yepengfei81-cpu/Motor_Glove/docs/teleop_cube_test.png

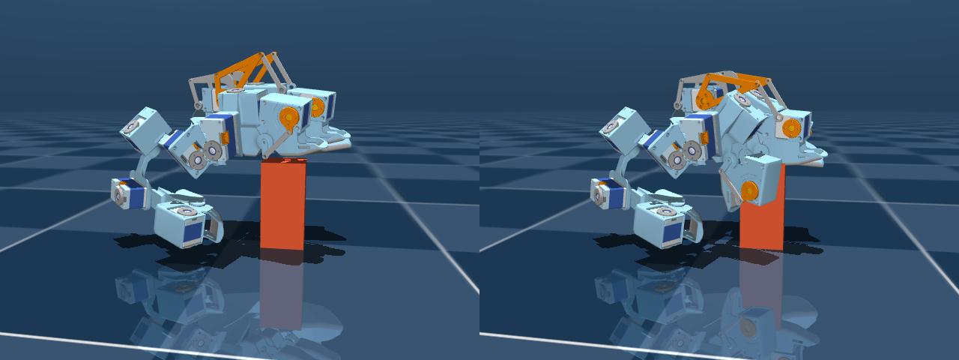
docs/teleop_cube_test.png
