yepengfei81-cpu/Motor_Glove/docs/middle_mcp_boxes_numbered.png

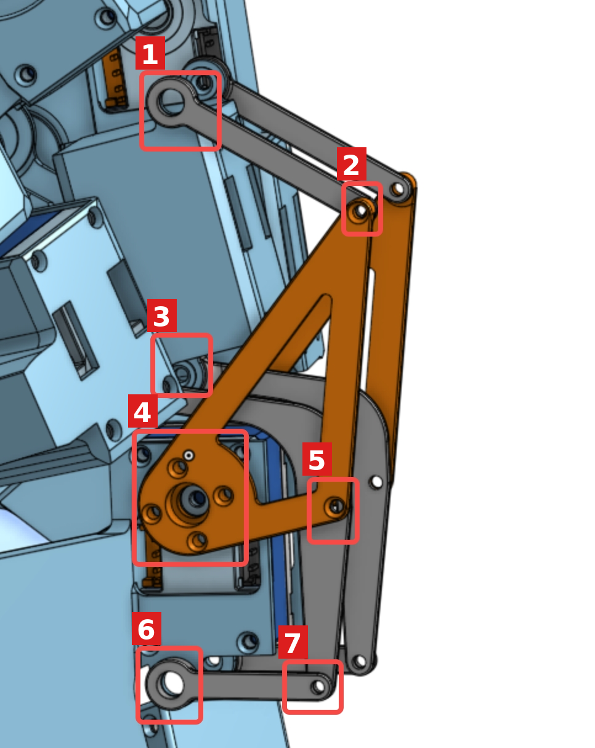
docs/middle_mcp_boxes_numbered.png
