yepengfei81-cpu/Motor_Glove/docs/motor_optimization_plan.md

# 电机性能优化计划（台架：两台 XL330-M077，ACM0 = OpenRB-150，USB0 = U2D2）

最后更新：2026-10-22。状态：☐ 没做 ☐→ 进行中 ☑ 完成。每完成一项把结论写在后面，别只打勾。

## 0. 现状基线（演示版本，手套 A → 机械手 H，13 关节）
- 控制频率 160–183 Hz：两条总线各一次 Sync Read（13 × 21 字节 ≈ 2.7 ms 线上时间）+ 两次 Sync Write + USB 往返 + 纯 Python SDK 拼包/CRC；两总线并行读后 183 Hz。
- 力反馈：主手电流模式，kp·位置差（有虚位）；或墙模式（主手模式 5，目标 = 从手位置，电流上限 = 门控 × 力）。
- 摩擦补偿：按电机报的速度加电流（--visc-ma），在 M077 上变成负阻尼，已弃用。
- 速度信号：电机的 Present Velocity，滤波滞后 + 0.229 rpm 量化。

## 1. 通信（已完成：3 Mbps + Fast Sync Read + 常驻读线程 + --rt；台架 1 关节 750 Hz，墙模式 800 Hz 手感明显优于 100 Hz）
- ☑ 写 `tools/bench_bus.py`，1 Mbps 单电机实测：OpenRB 读 0.6 ms / U2D2 读 1.0 ms（FTDI latency timer 地板）；读+写环 1.2 kHz / 1.0 kHz；500 Hz 节拍 0% 迟到；SDK 和精简包一样快（Python 开销可忽略）：单次读写往返、Sync Read vs Fast Sync Read(0x8A)、latency timer 1/16、用大块读模拟 13 电机线上时间、环频率和抖动直方图。
- ☑ U2D2 的 FTDI latency timer 是 1 ms（`cat /sys/bus/usb-serial/devices/ttyUSB0/latency_timer`，规则文件 tools/99-dxl-latency.rules）。
- ☑ 波特率：U2D2 2 Mbps 通（13 电机模拟读 1.0 ms）。OpenRB 原厂桥接固件只能 1 M。
- ☑ 自己的桥接固件 `firmware/openrb_bridge`（DMA 接收环形缓冲 + 8 倍过采样 + 总线供电开关）：
    逐字节中断在 2 M 就丢字节（每 7–10 字节丢 1 个，中断优先级提高也没用）→ DMA 后 2 M / 3 M 500 次 111 字节读 0 坏包；
    4 M 有 0.2% 坏包（分频 1.5，时序余量不够）→ **定 3 Mbps**。
    3 M 实测（OpenRB）：单电机读 0.36 ms，13 电机模拟读 0.82 ms，读+写全速环 1.95 kHz，800 Hz 节拍 0% 迟到。
    U2D2 3 M 实测：所有读都卡在 1.00 ms（FTDI latency timer 地板，和波特率无关），读+写环 1.0 kHz，800 Hz 节拍 0% 迟到。机械手侧要再快只能换成 OpenRB 跑同一个固件。
- ☑ Fast Sync Read：2 电机同总线验证通过（回包 ID 字段是 0xFE，每段 CRC 是累计 CRC，末段 CRC 即整包 CRC）。
    已并进 `dxl_bus.Bus`：`read_state`/`read_raw` 默认走 0x8A，按包头重对齐 + 整包 CRC，连续失败 3 次自动退回 SDK Sync Read；
    `Bus()` 打开时按 3M → 1M → 2M → 57600 自动找波特率；`mg.py <设备> baud 3000000` 一键迁移。
    台架 2 电机 @3M：read_state 0.47 ms（SDK 0.50），read_raw 0.40 ms。
- ☐ 真手套/机械手迁移到 3 M 并量 13 电机实际周期：`mg.py A baud 3000000`、`mg.py H baud 3000000`，然后 `mg.py teleop A H --hz 800`。
- ☑ 精简包层：实测和 SDK 一样快，不需要重写，保留 SDK。
- ☐ 每条总线一个线程自由跑，最新状态写共享缓冲；控制环固定节拍取值，不在环里等串口。
- ☑ `--rt`：SCHED_FIFO 50 + 绑空闲核（需 limits.conf 放开 rtprio）；例行检查拆成逐周期一步；从手常驻读线程。p99 1.6 ms。
- ☐→ 13 电机周期估算（线上时间 + USB 往返 + 写；3 M + Fast Sync Read ≈ 0.63 + 0.3 + 0.15 ≈ 1.1 ms → 800 Hz 级别，真手套上验证）：
    1 M 普通 Sync Read ≈ 4.2 ms → 240 Hz（现状）；1 M Fast Sync Read ≈ 3.4 ms → 290 Hz；1 M Fast + 只读位置电流 6 字节 ≈ 2.9 ms → 350 Hz；
    2 M Fast ≈ 1.7 ms → 600 Hz；4 M Fast ≈ 1.2 ms → 800 Hz。结论：1 M 下 13 个电机到不了 500 Hz，手套侧必须提波特率或内环上板。
- ☐ 评估把内环搬到 OpenRB-150 固件（它本来就在手套上，不加重量）：板上 1 kHz，PC 发设定值。STM32 不需要。

## 2. 辨识（裸电机，M077 和 M288 各做）
- ☑ `tools/motor_id.py`：spin / ramp / chirp / step / hold 五个实验 + fit（合成数据自测能拟回 J、b、tc），结果存 config/motor_params/<设备>.json。待台架实测。
- ☒ 实验 1 挂砝码保持 / 电流抬升（T1 实测）：不可用。砝码径向拉力让输出轴套摩擦涨到 ≈20 mN·m（空载 2.6），
    29 mN·m 的重力矩从上面下放只要 18 mA 保持；lift 里 100 mA 不动、140 mA 起动后直接翻过顶（起动后摩擦骤降，净力矩翻倍）。
    推论：真实电磁 Kt ≈ 0.3 N·m/A，手册 0.146 是堵转净值；输出力矩 = Kt·i − 随负载和方向变化的摩擦，被反驱和主动推要分开标。
- ☑ 实验 1''（sweep，T1，164 g × 18 mm 连续转 2 圈 × 2 方向，重复性 1 mA 以内）：
    抬升半圈（电机推负载）电流峰值包络 vs 重力矩 → 净 Kt ≈ 0.16 N·m/A，手册 0.146 基本对；抬升段是粘滑（电流在 20–240 mA 间来回），负载下静摩擦 > 动摩擦。
    下放半圈（负载反驱电机）平均电流只有 13 mA，摩擦扛了约 90% 的负载：1.6 N 径向力压在输出轴套上，M077 在这种负载下接近不可反驱。
    对手套的含义：四连杆对舵盘的拉力就是这种径向负载（50 mN·m 关节力矩 ≈ 5 N 链接力），接触时主手电机"顶住人"几乎不花电流、"推动人"要全额电流，
    透明度的大头是负载摩擦不是控制；机械上考虑用 idler 侧双支撑输出轴、或加轴承。
- ☐ 实验 1'（可选）平衡杆惯量法：对称杆装/不装各做一次 chirp，ΔJ 已知 → 电磁 Kt 和电机 J（现在净 Kt 已够用，优先级降低）。
- ☑ 负载摩擦标定（T1：53 / 122 / 164 g）：反驱时摩擦 4.6 / 12.2 / 16.5 mN·m，对径向力线性，≈ 10.9 mN·m 每牛顿，截距 ≈ 0。
    推负载时的表观净 Kt 随负载降（0.21 → 0.16），反推电磁 Kt ≈ 0.27 N·m/A（三点一致 ±15%）。
    模型：τ_out = 0.27·i − f，f ≈ 10.9 mN·m/N × 径向力（+ 空载 2.9）。手套四连杆的径向力 ≈ 关节力矩 / 舵盘半径，摩擦和传递力矩同量级。
    结果存 config/motor_params/T1.json（load_friction_model、kt_em_estimate）。
- ☑ 实验 2 ramp（T1）：起动电流 17–18 mA 极稳（≈2.6 mN·m 按手册 Kt；按真实 Kt 约 5 mN·m）。
- ☑ 实验 3（改为 spin 零电流衰减，T1）：b/J = 1.30 /s，tc/J = 110 rad/s²（与 Kt 无关的量）。
- ☑ 实验 4 chirp（T1）：按手册 Kt 算 J = 26 g·cm²（真实 Kt 下约 50）；电流环：实测电流滞后指令 8 ms。chirp 的 b 和 spin 差十倍，拟合要补延迟，信 spin。
- ☐ 实验 5 零电流单摆衰减：反驱摩擦（手感）；关扭矩再做一遍对比（零电流 ≠ 关扭矩？）。
- ☑ 实验 6 step（T1）：电机报的速度比位置差分滞后 22 ms → 阻尼项不能用它，必须自己做速度估计。
- ☐ 装上手套/机械手后：每个四连杆关节做一次衰减实验，减去裸电机模型 = 连杆增量（销轴摩擦、柔度），按关节存。传动比 r = dφ/dθ 用 passive_map 的曲线。
- ☐ 同型号多台的离散度：测 2–3 台看摩擦差多少，决定按型号还是按台存参数。

## 3. 控制
- ☐ 速度估计：500 Hz 下用位置 + 辨识模型做观测器（或低滞后差分滤波），替掉 Present Velocity。
- ☐ 模型前馈：摩擦（Stribeck/库仑/粘滞）+ 惯量，用辨识参数，不手调。
- ☐ 增益由目标阻抗（K、B）和辨识对象 + 延迟反推，带裕度。
- ☐ 扰动观测器（DOB）：标称模型 = 辨识结果，抵消摩擦和参数误差，做"透明"模式。
- ☐ 时域无源性控制（TDPC）：能量观测，自动注入阻尼，硬墙不抖。
- ☐ 位置模式前馈寄存器（88 速度前馈、90 加速度前馈）：从手跟随用，系数从 b、J 换算，比例实测。
- ☐ 可选：PWM 模式（16）+ 反电动势补偿当更快的力矩通路，需要 R、Ke。
- ☐ 可选：小网络拟合摩擦随角度/方向/温度的图，只做前馈，用衰减实验验证。

## 4. 其他
- ☐ 热：M077/M288 持续电流上限和温升曲线。
- ☐ 机械：四连杆销轴换轴承（手感的大头）。
- ☐ 台架 = 一自由度双边遥操作测试台：透明度（空中力）、墙刚度、稳定边界、Z-width；每版控制律先在台架量。

## 已经确定的结论
- 墙模式比电流模式弹簧硬得多，无虚位；电流上限不能按预算预摊（会把 13 关节摊薄）。
- 零点在 0/4095 边缘的关节写目标位置必须就近折返。
- 拇指 IP、中指 PIP 从手方向相反，力反馈要乘方向符号。

## 2026-10-23 虚拟耦合为什么高频振、根因与出路

**现象（data/coupling.csv，bench_coupling 预设，kc 0）**：6.6 Hz 极限环。主手 ±52°，从手反相 ±40°，主手电流 ±800 mA 饱和 88% 时间，
速度封顶 ±31 rad/s —— 正好是 6 V 除以 Ke 0.18–0.19 V·s/rad 的空载转速（实测电流随转速逼近 31 rad/s 掉到 0，Kt_em≈0.18 又一次被证实）。
日志里的 qA/qB/err 单位是弧度，不是度。

**我加的、也是出问题的东西**：coupling 模式把弹簧从"门控开才接"改成了"误差超过 2° 就一直接"，又加了 B·ė。电流模式下这两项都是非被动的：

| 事实 | 数值 | 来源 |
|---|---|---|
| 命令到力矩延迟 T | ≈7 ms | 阶跃位置起动 7.6 ms、啁啾回归 5–9 ms、实测电流滞后 8 ms（三者一致，是电机内部电流环的慢，不是上报滤波） |
| 主手物理阻尼 b | 0.45 mN·m·s/rad | 啁啾 |
| 延迟弹簧等效负阻尼 K·T | 0.8 × 7 ms = 5.6 mN·m·s/rad | 远大于 b |
| 被动上界 K < 2b/T（Colgate） | ≈0.13 N·m/rad | 实际 0.8，超 6 倍 |
| B·ė 在 25 Hz（√(K/J)）处的相位 | −72°(延迟) −59°(15 Hz 观测器) = −131° | 本身已是负阻尼 |

手指握着时手指的阻尼和惯量把它压住，所以 bench_free 在接触时好用；一松手就只剩电机自己 → 弹飞/振荡。门控方案空载不振只是因为空载弹簧根本没接。

**仿真（scratchpad bilat_sim.py：两电机、7 ms 延迟、反电动势限速、库仑摩擦、编码器量化、从手位置环）**：
- 电流模式连续弹簧：K ≥ 0.04 空载一拨就起 10 Hz 极限环，K 0.8 复现饱和极限环（14 Hz ±24°，实测 6.6 Hz ±52°，量级一致）；堵转松手同样振。
- 原门控方案：空载 2°（没弹簧），堵转松手 35° @10 Hz 衰减到 2.6°（就是用户感受到的"弹飞"）。
- 电压(PWM)模式：绕组被电压源驱动，Kt²/R ≈ 0.18²/3.3 ≈ 9.8 mN·m·s/rad 的电磁阻尼是物理的、零延迟的（电流模式下它被电机的电流环抵消掉了）。
  K 0.8 和 2.0、空载和松手全部 0.00° 振幅（延迟 2 ms），延迟 7 ms 也稳。空载用 k_bemf = 1 − w_pen 把电磁阻尼按穿透深度抵消
  （空载全抵消 = 和电流模式一样轻，一拨滑行 1.9° vs 门控 4.5°），穿透越深阻尼越真。若 PWM 延迟也是 7 ms，松手时 k 要慢放（待调）。

**下一步（台架，T1）**：
1. `python tools/motor_id.py T1 spin --mode pwm`：占空比 20% 脉冲后归零，看是几毫秒刹住（电压源）还是滑行几百毫秒（断开）。
2. `python tools/motor_id.py T1 step --mode pwm`：占空比 ±15% 阶跃 → 延迟、Ke、R。
3. 两个都对了再给 bilateral.py 加 `--mode pwm`（力矩 → 占空比 = (R·τ/Kt + k·Ke·v̂)/V，k = 1 − w_pen），沿用现在的弹簧律、摩擦前馈和观测器。

### 台架结果（2026-10-23，T1 电压模式）

- `spin --mode pwm`：占空比归零后 40–60 ms 停下，再转 10–13°。既不是短路绕组的 3 ms，也不是关扭矩的 380 ms：
  电磁阻尼 b_em ≈ 1.3–1.8 mN·m·s/rad（阶跃上升时间常数 13–24 ms 给出 1.4–2.5，一致）。比电流模式的 0.45 大 4 倍，但没有理论值 9.8 那么大。
- `step --mode pwm` ±15%（0.915 V）：稳态 6.5 rad/s；实测电流 2 ms 就开始升、8 ms 到峰（61 mA）；位置 10 ms 才动 1 tick。
  电流模式 +120 mA 阶跃同样 2 ms 起电流、10 ms 位置才动。**延迟主要在位置上报（≈6 ms），执行 ≈2 ms，两种模式一样。**
  起始加速度 450 rad/s²（电流模式 120 mA 是 545）→ 15% 占空比 ≈ 100 mA 当量，G ≈ 19 mN·m/V，100% ≈ 117 mN·m；
  扣摩擦 0.31 V 后 Ke_eff ≈ 0.093 V·s/rad（6.1 V 空载 65 rad/s）；G·Ke = 1.8 mN·m·s/rad 和 spin 测的 b_em 自洽。
  （电流读数的绝对标定和 Kt 0.18/Ke 0.093 对不上，先不管：控制只用电压模式里直接测到的 G、Ke、b_em。）
- 仿真按实测改（感知 6 + 执行 2 ms，b_em 1.8）：空载连续弹簧 电流模式 K≥0.2 全振，电压模式 K 到 0.8 都 0.00°；
  堵转松手两种模式都有"弹飞"——松手后力矩还要作用一个回路延迟（≈9 ms），Δv = τ·T/J ≈ 20 rad/s，这是硬物理，
  电压模式只是把之后的滑行从 ~100°（库仑摩擦刹）缩到 ~25°（电磁阻尼 τ=J/b=18 ms）。仿真里松手后的极限环比实际悲观（实际门控方案会收敛）。

### 决定

1. 先不动力律：`--mode pwm` 用 bench_free 同一套（门控弹簧、单向、摩擦前馈、观测器），只换执行路径：
   占空比 = (τ/G + k·Ke·v̂)/V，k = pwm-cancel × (1 − 门控)。空载全抵消电磁阻尼（和电流模式一样轻），接触/松手保留。预设 `bench_pwm`。
   A/B：`mg.py teleop T1 T2 thumb --preset bench_free` vs `--preset bench_pwm`，重点是堵转松手。
2. 再做：电压模式下用实测电流反推速度（i = (dV − Ke·ω)/R，电流 2 ms 就响应，位置要 6 ms）做松手检测，把力矩作用时间从 9 ms 压到 4 ms，弹飞再减半。
3. 之后才考虑去掉门控的连续弹簧（空载从手滞后 3° 会变成拖拽，需要死区/滞后补偿）。

## 2026-10-25 M288 辨识与从手软件环

- 两台从手套拆下的 M288（T3 = ID 5 index_mcp_flex，T4 另一台）全套辨识，和 M077 按减速比 3.74 对照全部吻合：
  起动 21/18 mA（M077 17–18，起动摩擦在转子侧）；tc 15.8 mN·m（3.6×3.74 = 13.5）；tc/J 28.5/26.4（110×3.74/14 = 29）；
  J 5.6e-4（3.2e-5×14 = 4.5e-4）；净 Kt 0.76–1.0（0.18×3.74 = 0.67）；负载摩擦 ≈9 mN·m/N（M077 10.9）；关扭矩多出的 b/J +1.3 /s 两者一样。
  两台之间 Kt、负载摩擦差 <5%，摩擦差 7–14% → 共用参数，前馈留一成余量（手套预设 0.8）。
- 电压模式：归零刹车 τ≈26 ms → b_em 21 mN·m·s/rad（M077 1.5 × 14）；Ke 0.45（0.12 × 3.74）；R 沿用 4.1 Ω。
  **发现驱动桥 PWM 关断期断开（断续导通）**：堵转 占空比→电流 不是线性，5% 时表观 14 Ω、50% 时 6 Ω、88% 才 4.1 Ω。
  原来按 G 线性换算，13 mA 前馈只给了 0.8% 占空比（需要 2.2%），接触 134 mA 只送到 35 mA。改成查堵转表（从接触段日志反推，两型号共用），电流环增益按工作点表观电阻。
- 参数文件按型号：XL330-M288.json / XL330-M077.json；bilateral `--model auto` 按总线型号逐关节选，J、B、φ、G/Ke/R 全部按关节。
- 从手 `--follower-mode current`：电流模式 + 软件 PD（K = J·(2πf)²，f 默认 6 Hz，`--follower-bw-map M077=12`）+ 模型前馈（J·a_ref + b·v_ref + c·tc·sgn(v_ref)）。
  台架 T3/T4 实测：从手不再粘滑（原位置环 P 600 需 1.2° 误差才顶过静摩擦，一格一格跳；加 I 增益会在目标附近来回蹭），用户评价"效果很好"。
- `--fb-force`：反作用力观测器力反射（从手指令力矩 − 模型），第一版三项滤波不配平 → 主手一加速就出假接触力，两边抖且黏；改成统一 6 Hz 低通 + 和前馈同形的摩擦项，待台架验证。
  位置差弹簧只能渲染硬挡，软物体（硅胶）要靠力反射；电流/位置上报 8 ms 滞后 + M288 自身摩擦 16 mN·m 决定了纹理摸不到，软硬和慢起伏可以。
- M288 空载"比断电更丝滑"的上限：摩擦那十几 mN·m 能补掉 80–90%，换向死区内仍是全摩擦；惯量 5.6e-4（M077 的 14 倍）补不了，是 288:1 的代价。
- 下一步：装回手套（T4 ID 改回、两台先回 1 M、整只迁 3 M、量 13 电机实际频率）；装着做 ramp 量每关节起动摩擦再放开前馈；舵盘半径表填 --r-load-map；机械手 PIP/IP 若嫌软退回位置模式。
