yepengfei81-cpu/Motor_Glove/docs/figs/ppt/cad_palm_front.png

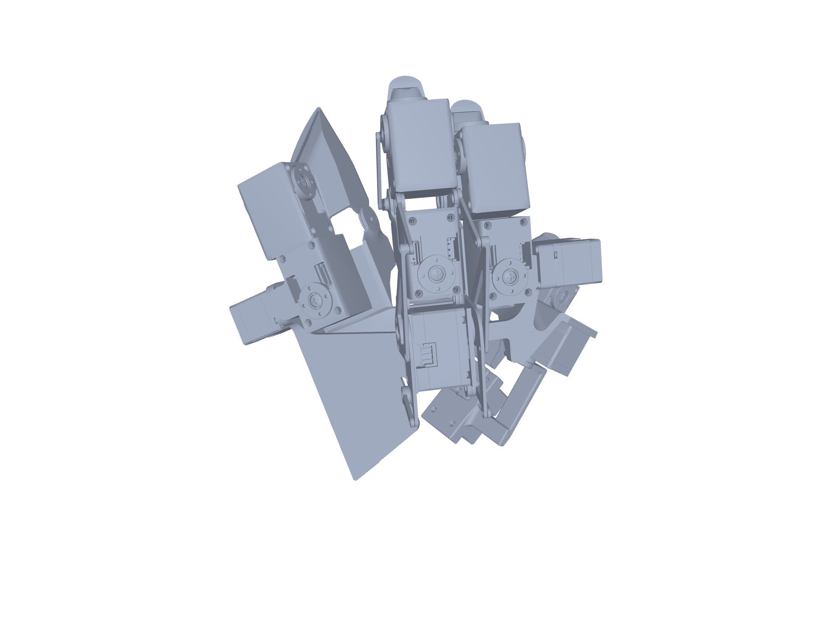
docs/figs/ppt/cad_palm_front.png
