yepengfei81-cpu/Motor_Glove/docs/figs/ppt/cad_top.png

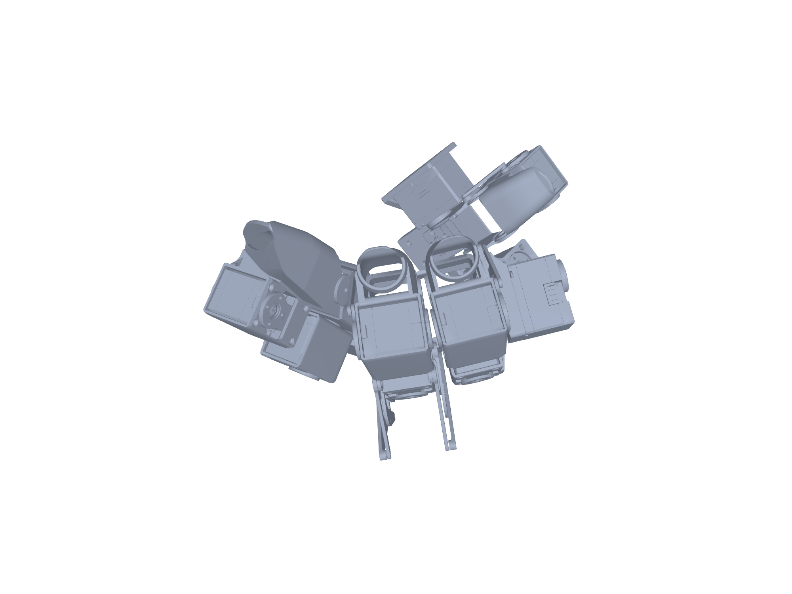
docs/figs/ppt/cad_top.png
