yepengfei81-cpu/Motor_Glove/docs/figs/ppt/comparison_table.png

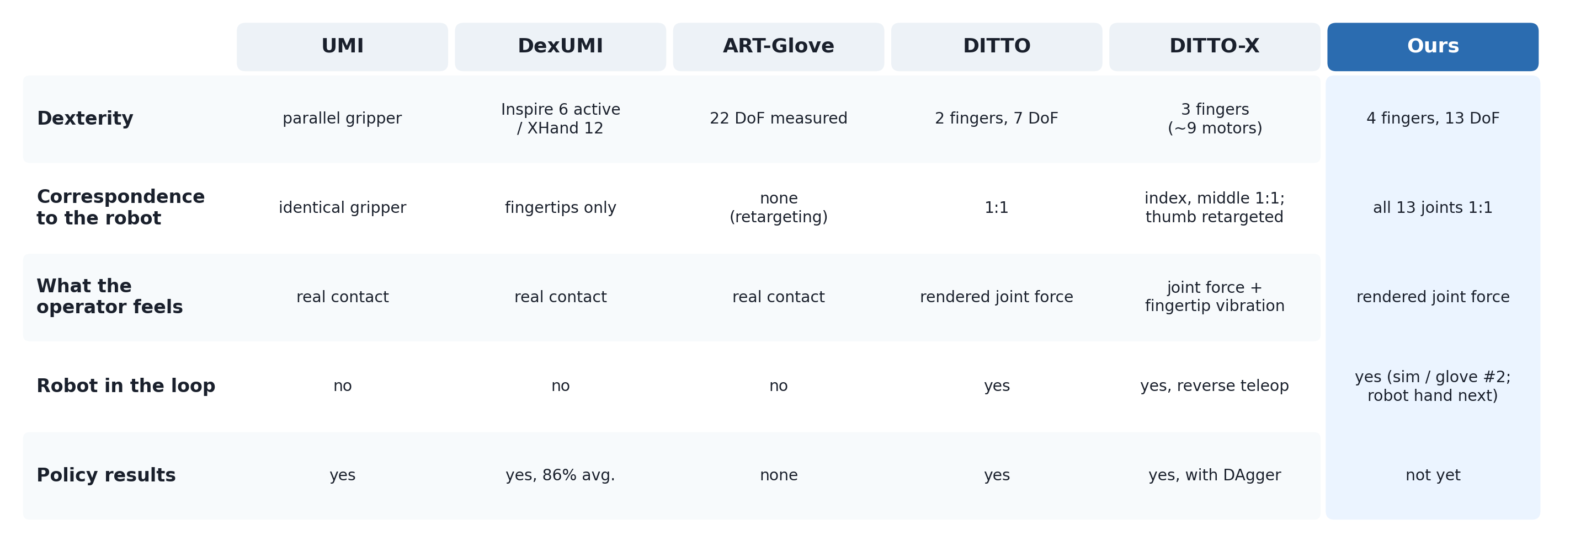
docs/figs/ppt/comparison_table.png
