yepengfei81-cpu/Motor_Glove/docs/figs/ppt/control_law.png

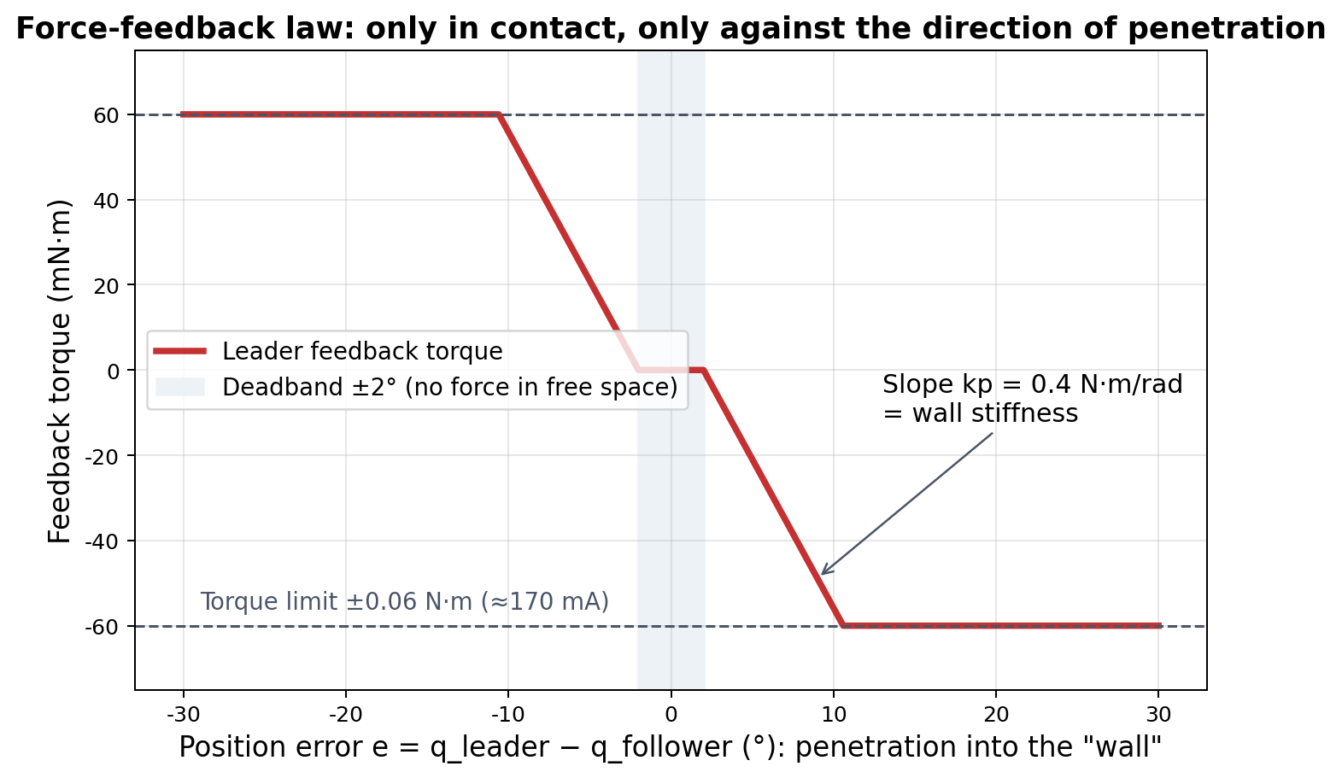
docs/figs/ppt/control_law.png
