yepengfei81-cpu/Motor_Glove/docs/figs/ppt/data_record.png

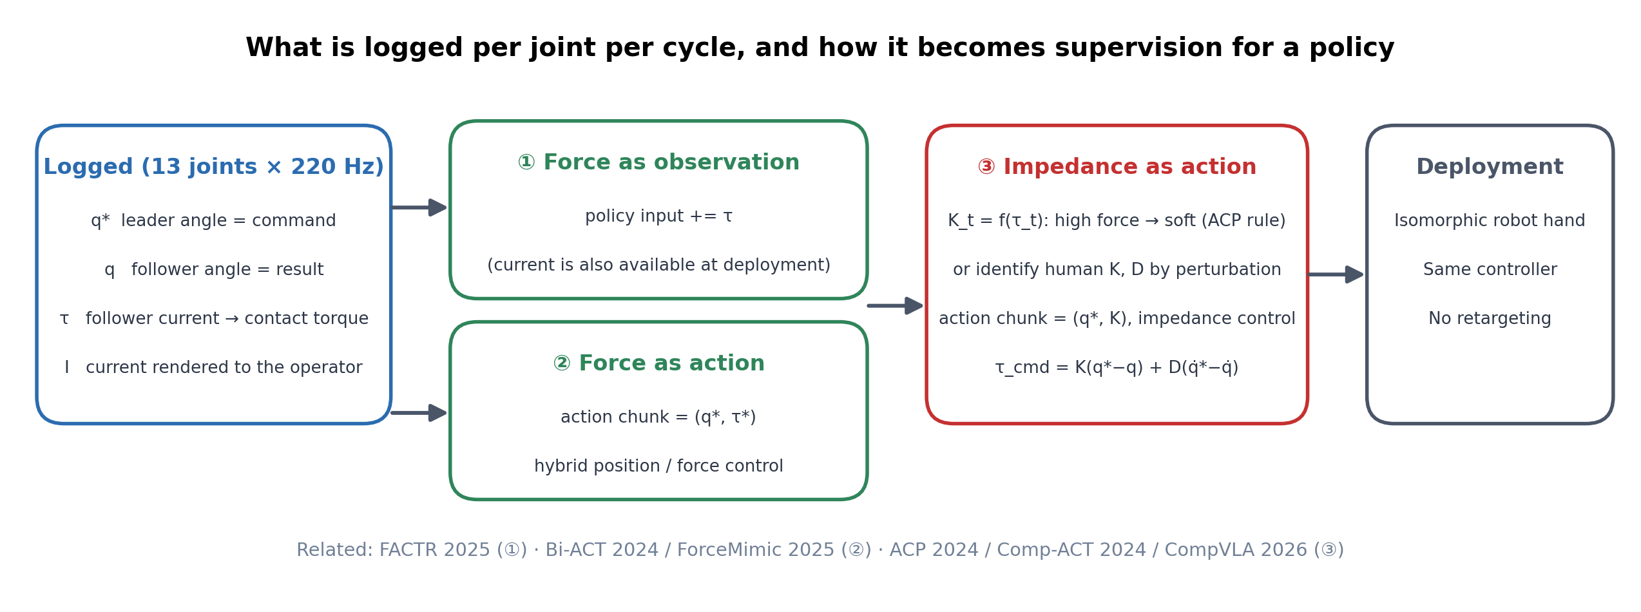
docs/figs/ppt/data_record.png
