yepengfei81-cpu/Motor_Glove/docs/figs/ppt/modules_dorsal.png

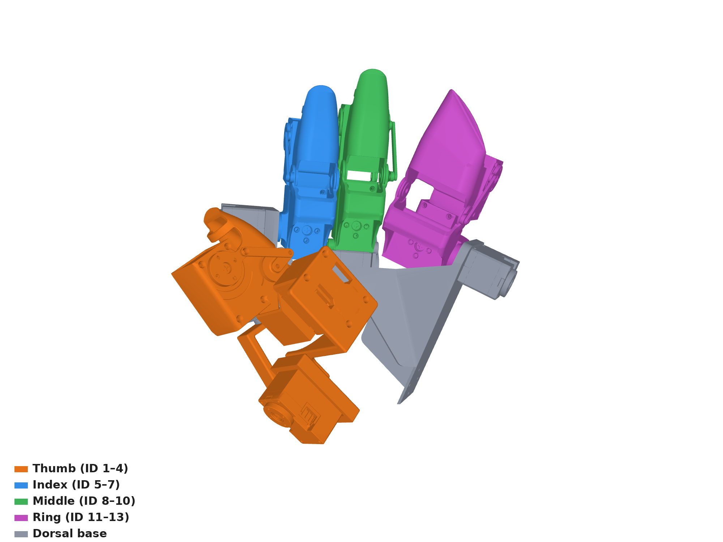
docs/figs/ppt/modules_dorsal.png
