yepengfei81-cpu/Motor_Glove/docs/figs/ppt/modules_palm_front.png

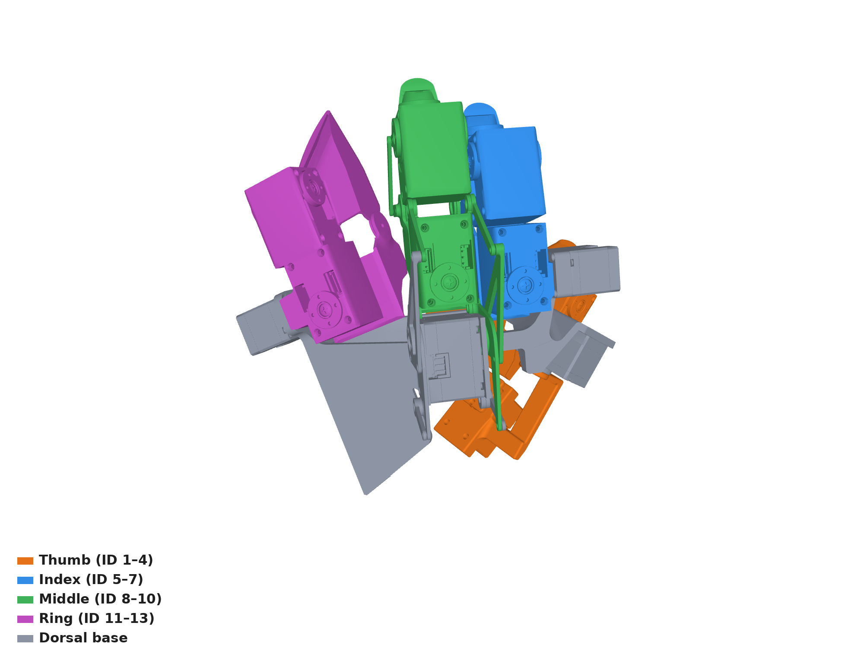
docs/figs/ppt/modules_palm_front.png
