yepengfei81-cpu/Motor_Glove/docs/figs/ppt/modules_palm_oblique.png

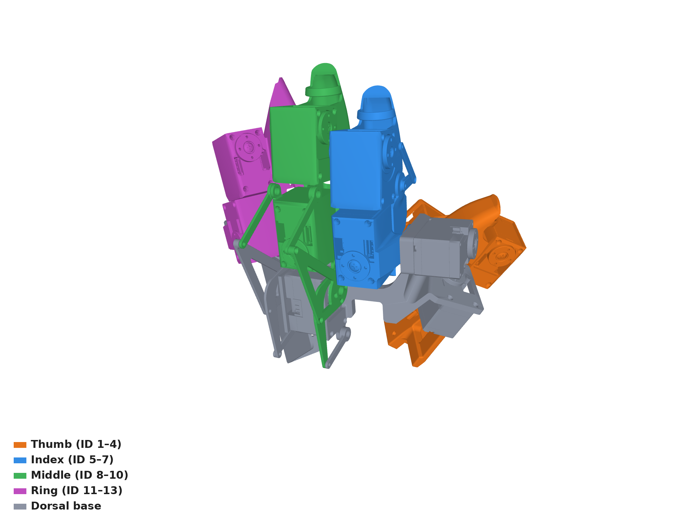
docs/figs/ppt/modules_palm_oblique.png
