yepengfei81-cpu/Motor_Glove/docs/figs/ppt/rcm_mid_mcp.png

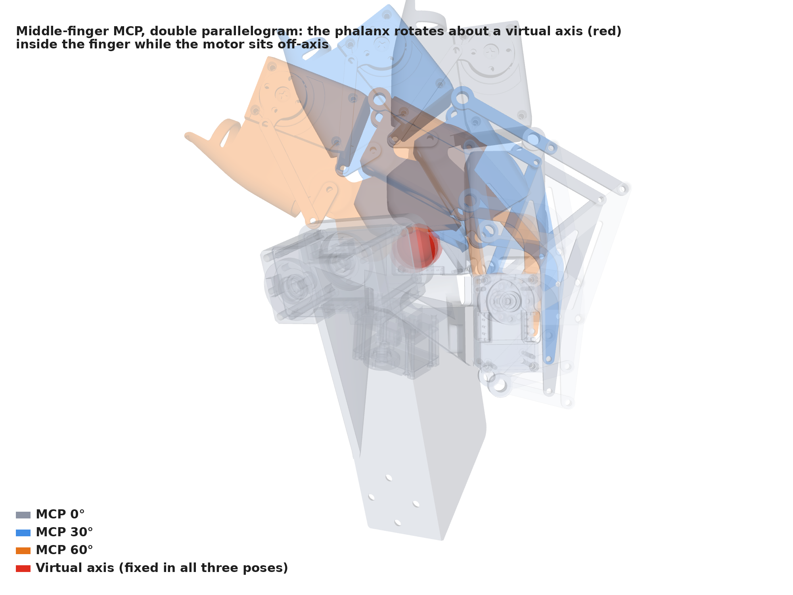
docs/figs/ppt/rcm_mid_mcp.png
