yepengfei81-cpu/Motor_Glove/docs/figs/ppt/rom_overlay_palm_front.png

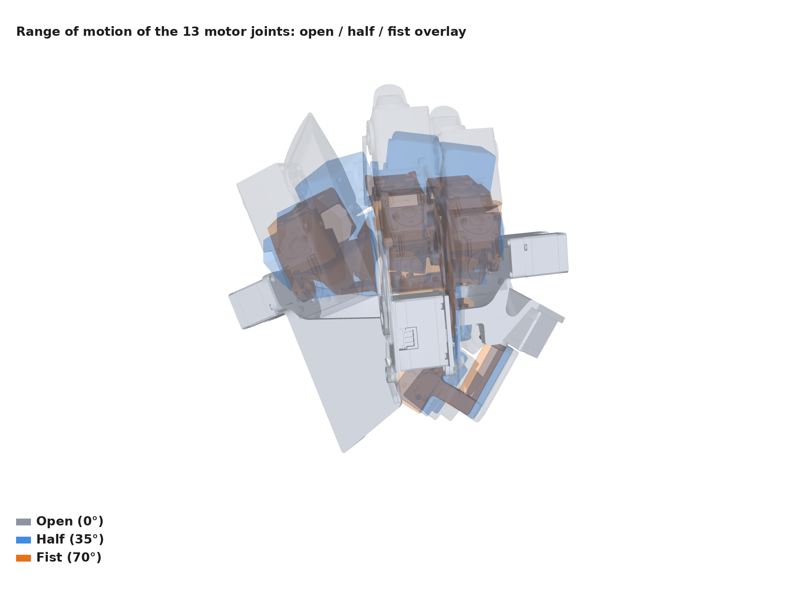
docs/figs/ppt/rom_overlay_palm_front.png
