yepengfei81-cpu/Motor_Glove/docs/figs/ppt/scorecard.png

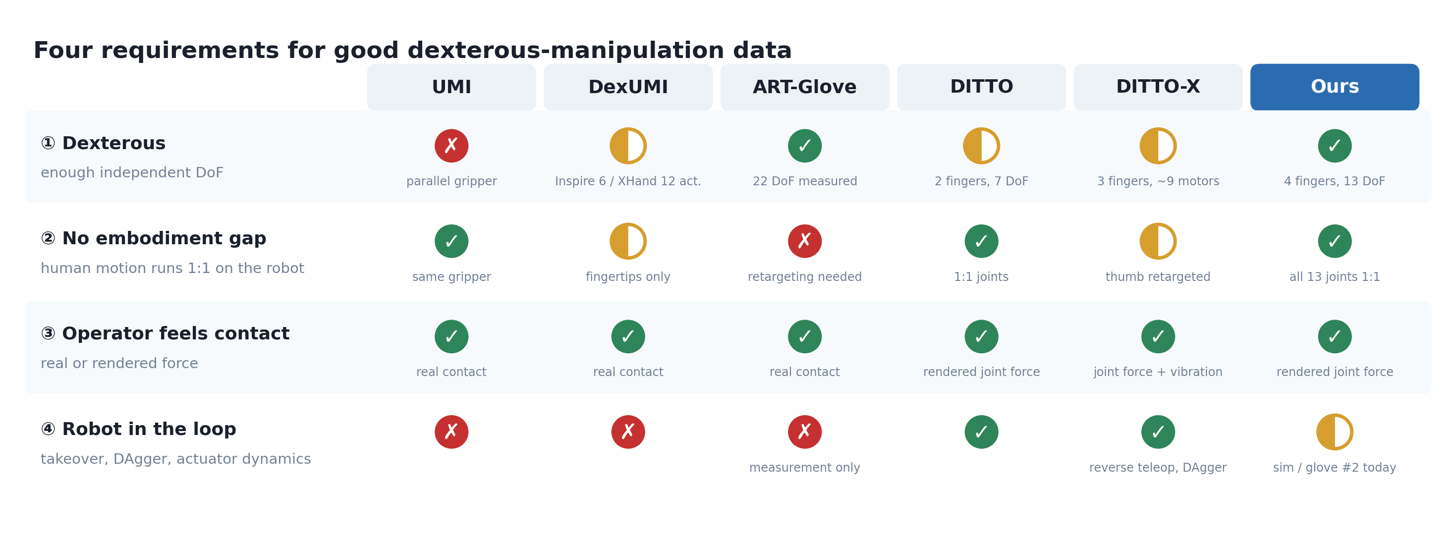
docs/figs/ppt/scorecard.png
