yepengfei81-cpu/Motor_Glove/docs/figs/ppt/scorecard_artglove.png

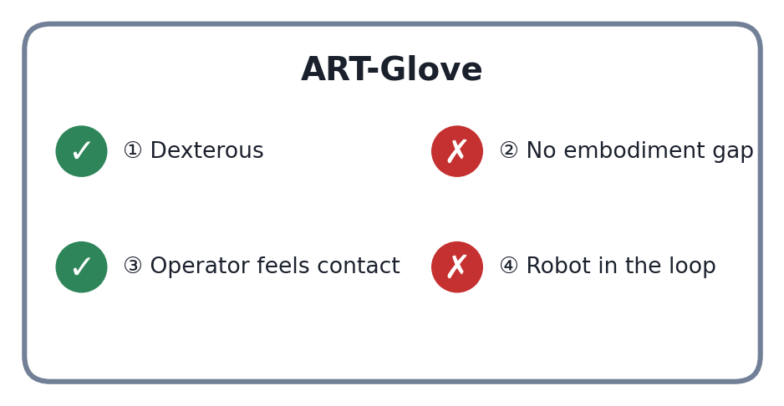
docs/figs/ppt/scorecard_artglove.png
