yepengfei81-cpu/Motor_Glove/docs/figs/ppt/stiffness_adaptive.png

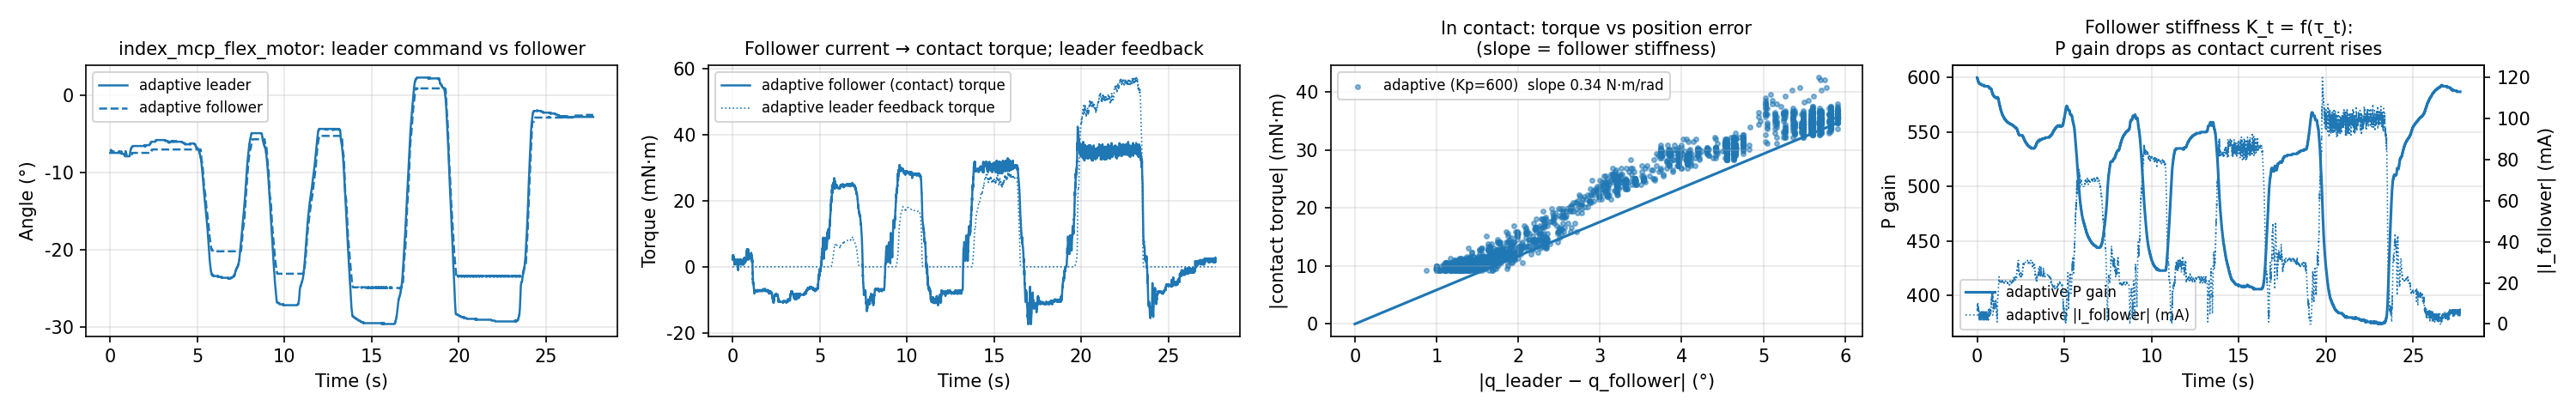
docs/figs/ppt/stiffness_adaptive.png
