yepengfei81-cpu/Motor_Glove/docs/figs/ppt/stiffness_adaptive_p1.png

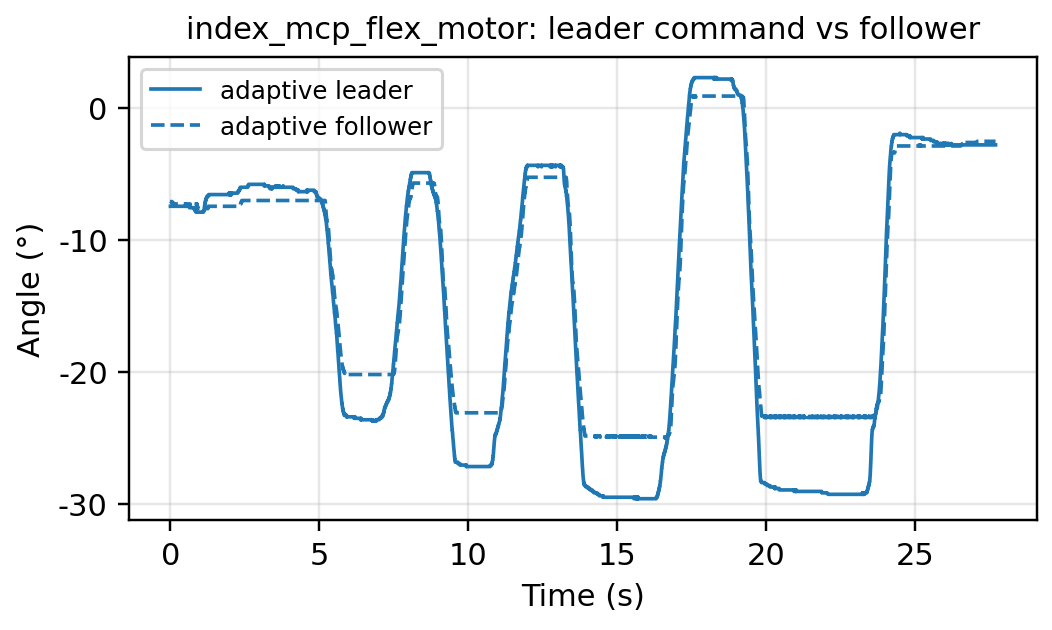
docs/figs/ppt/stiffness_adaptive_p1.png
