yepengfei81-cpu/Motor_Glove/docs/figs/ppt/stiffness_adaptive_p2.png

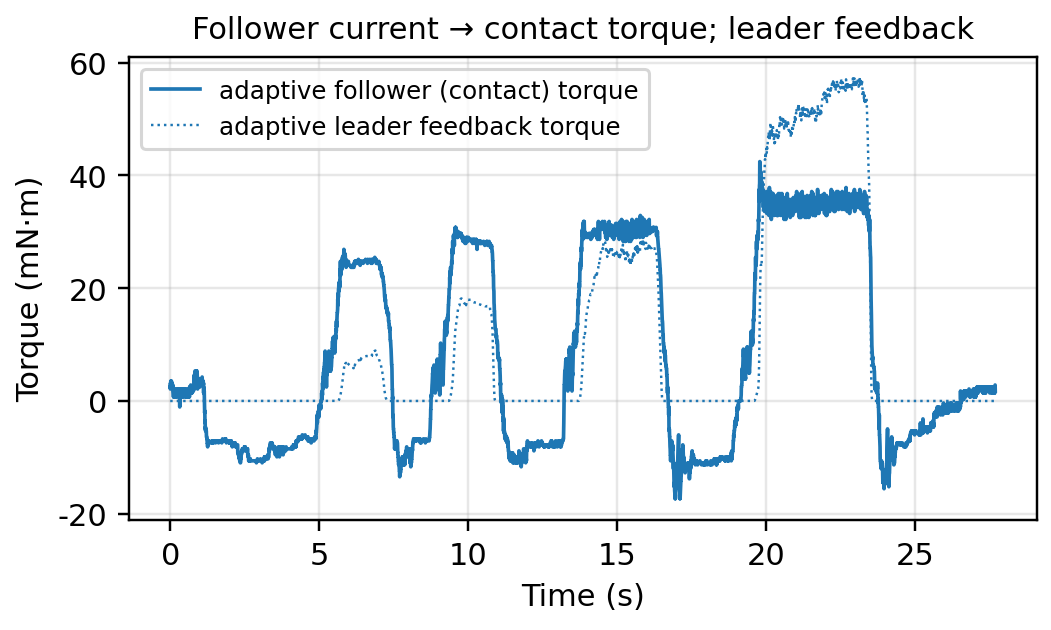
docs/figs/ppt/stiffness_adaptive_p2.png
