yepengfei81-cpu/Motor_Glove/docs/figs/ppt/stiffness_adaptive_p3.png

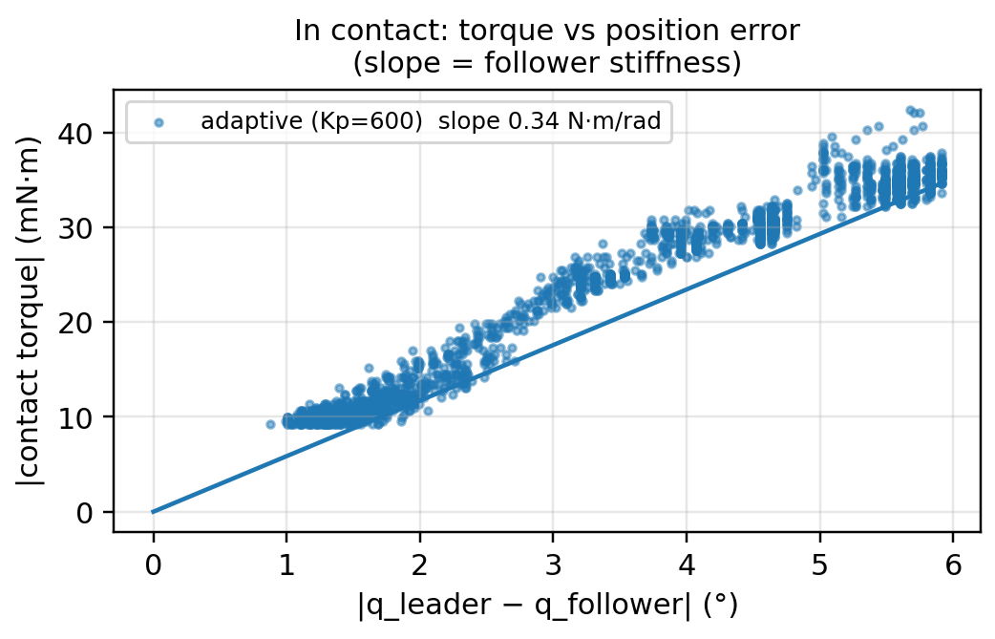
docs/figs/ppt/stiffness_adaptive_p3.png
