yepengfei81-cpu/Motor_Glove/docs/figs/ppt/stiffness_kp.png

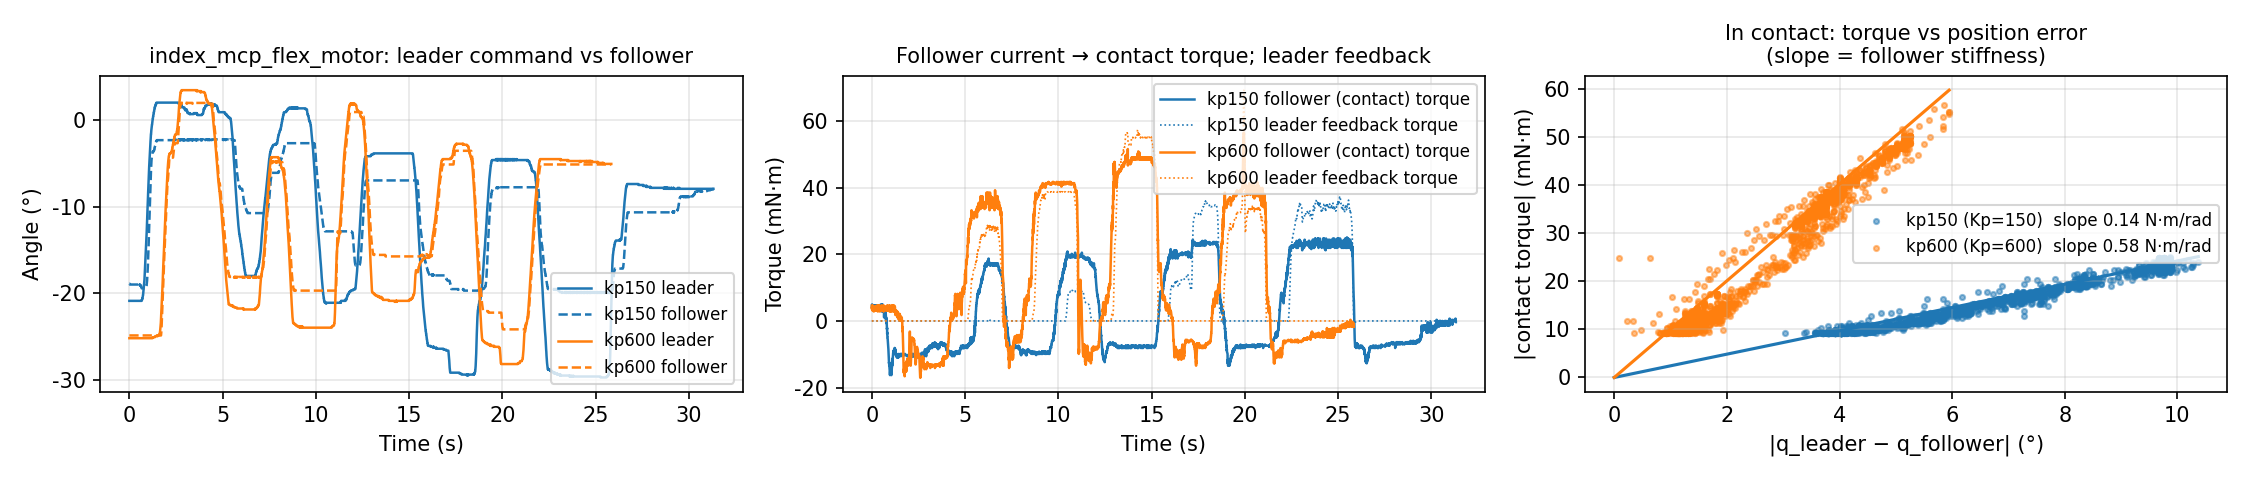
docs/figs/ppt/stiffness_kp.png
