yepengfei81-cpu/Motor_Glove/docs/figs/ppt/stiffness_kp_p1.png

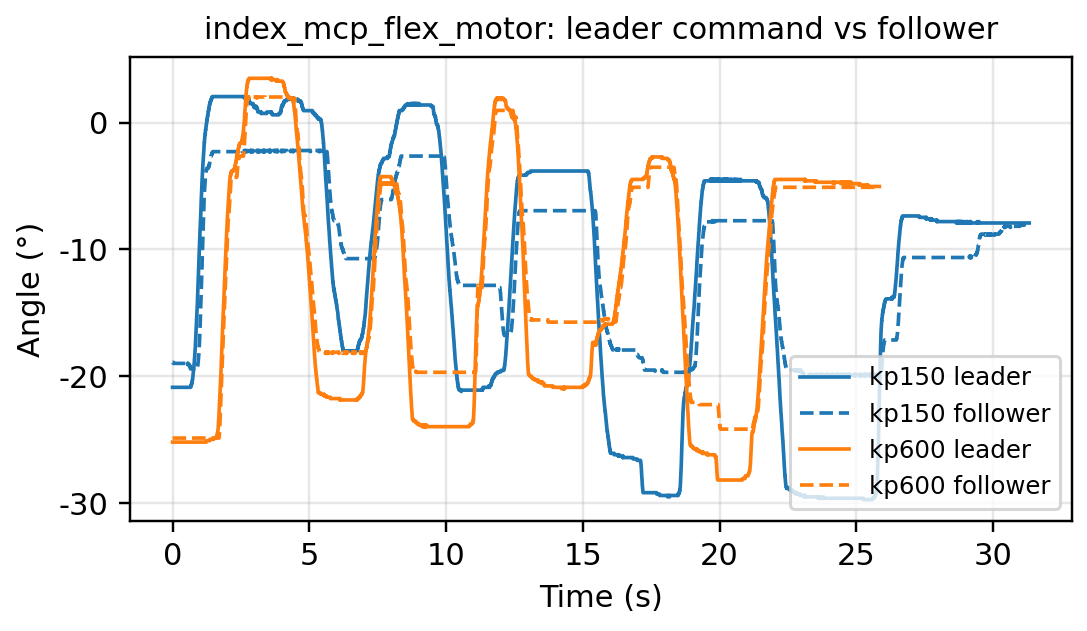
docs/figs/ppt/stiffness_kp_p1.png
