yepengfei81-cpu/Motor_Glove/docs/figs/ppt/system_diagram.png

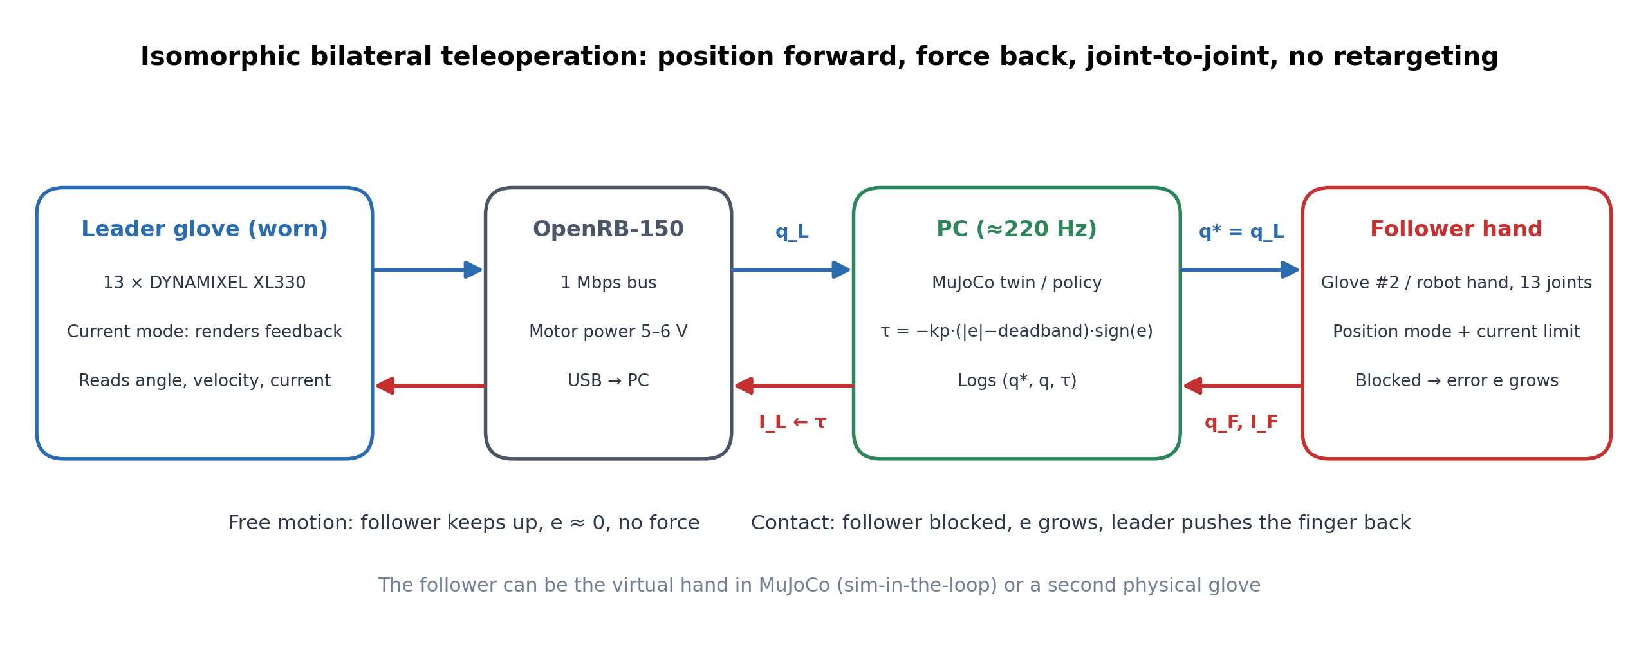
docs/figs/ppt/system_diagram.png
