yepengfei81-cpu/Motor_Glove/docs/figs/skeleton_fist_dorsal.png

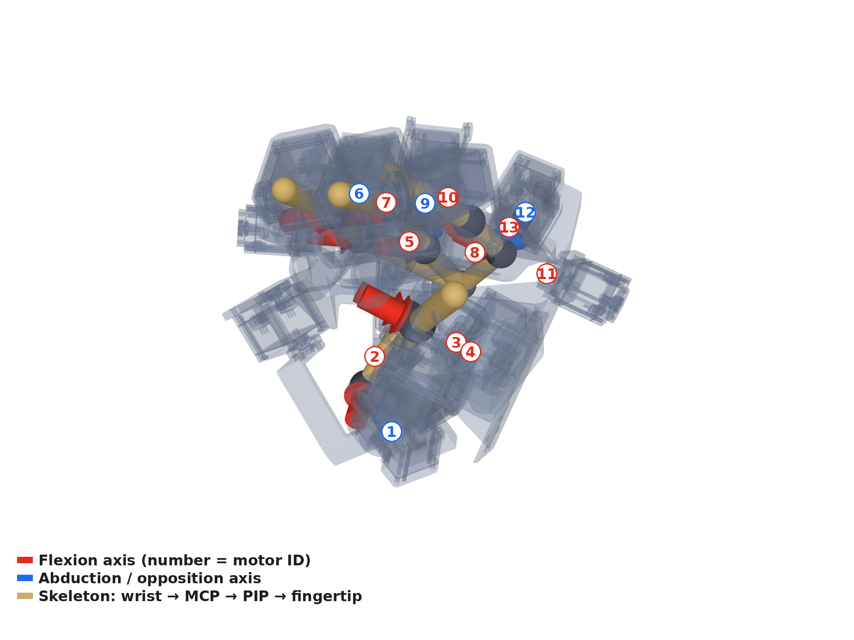
docs/figs/skeleton_fist_dorsal.png
