yepengfei81-cpu/Motor_Glove/docs/figs/skeleton_fist_palm_oblique.png

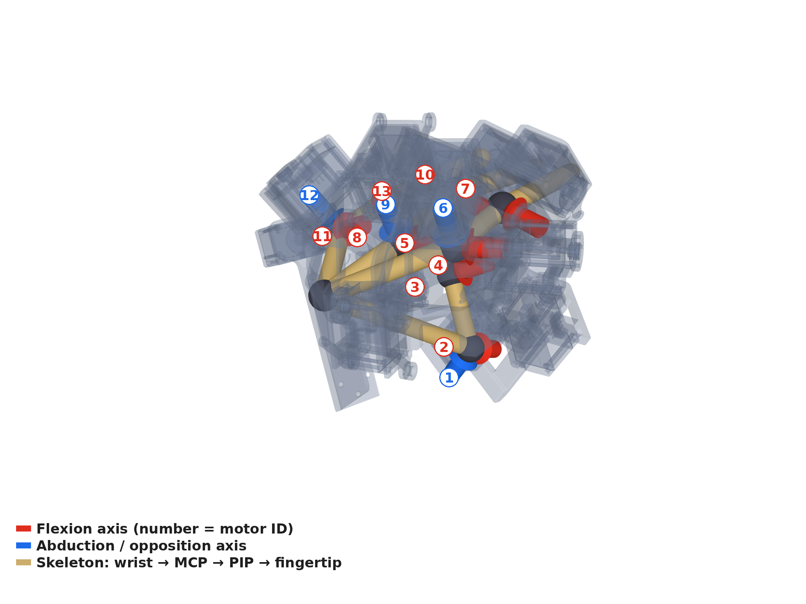
docs/figs/skeleton_fist_palm_oblique.png
