yepengfei81-cpu/Motor_Glove/docs/figs/skeleton_zero_dorsal.png

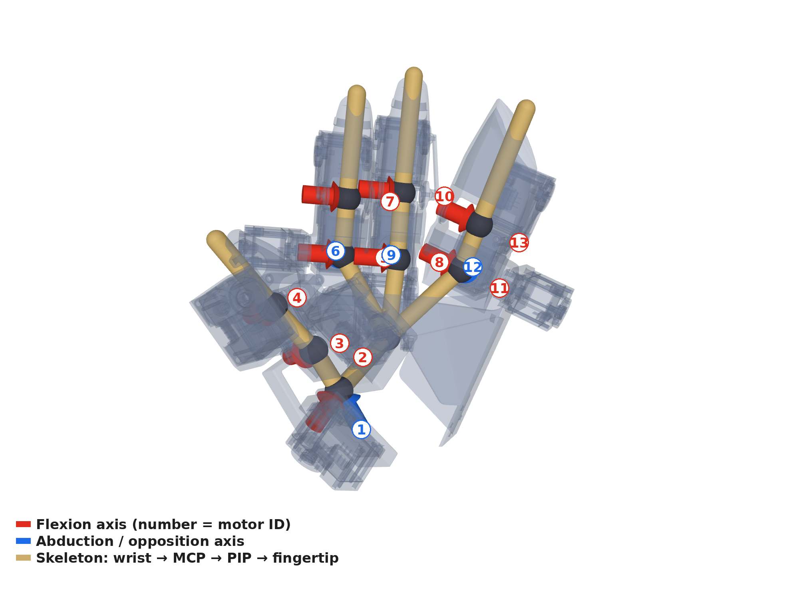
docs/figs/skeleton_zero_dorsal.png
