yepengfei81-cpu/Motor_Glove/docs/figs/skeleton_zero_dorsal_nomesh.png

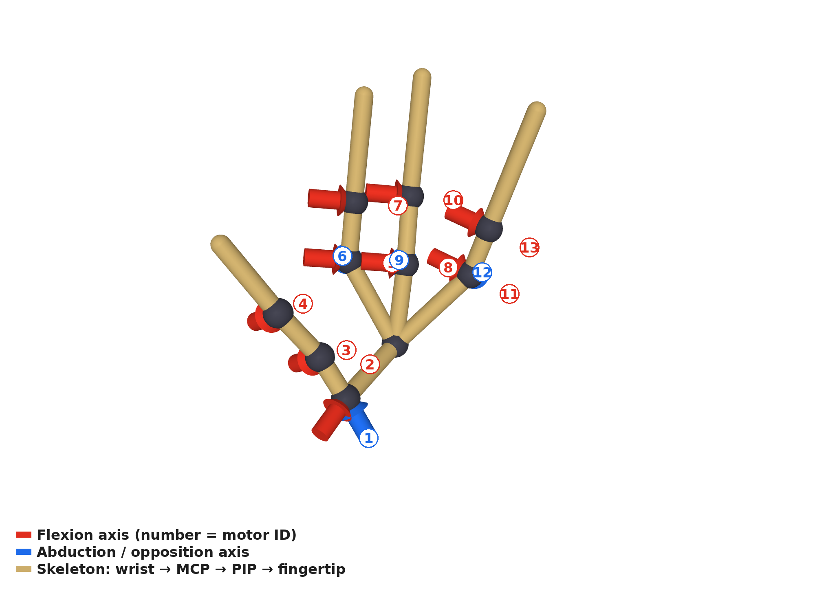
docs/figs/skeleton_zero_dorsal_nomesh.png
