yepengfei81-cpu/Motor_Glove/docs/figs/skeleton_zero_palm_oblique.png

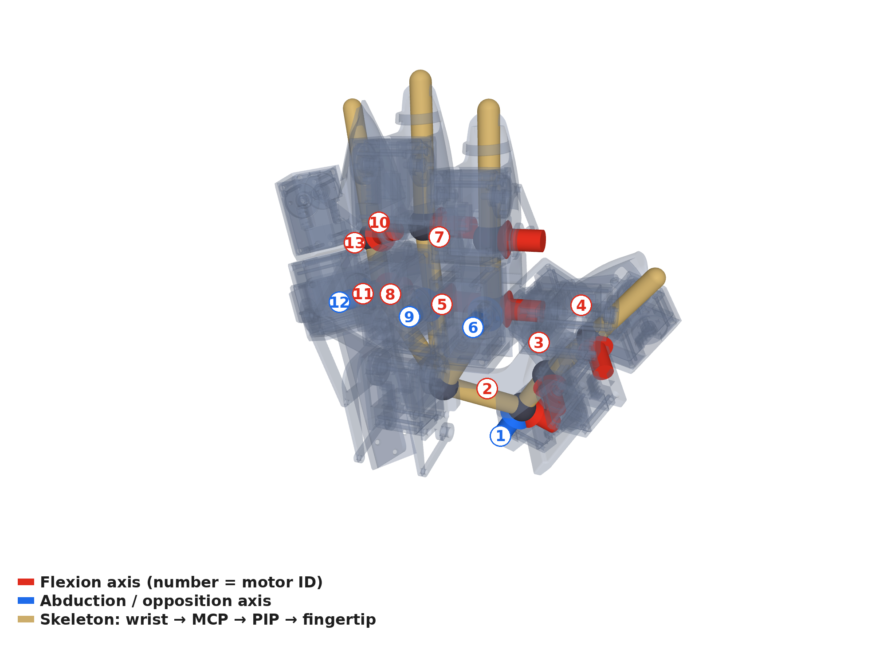
docs/figs/skeleton_zero_palm_oblique.png
