yepengfei81-cpu/Motor_Glove/docs/figs/skeleton_zero_thumb_side_nomesh.png

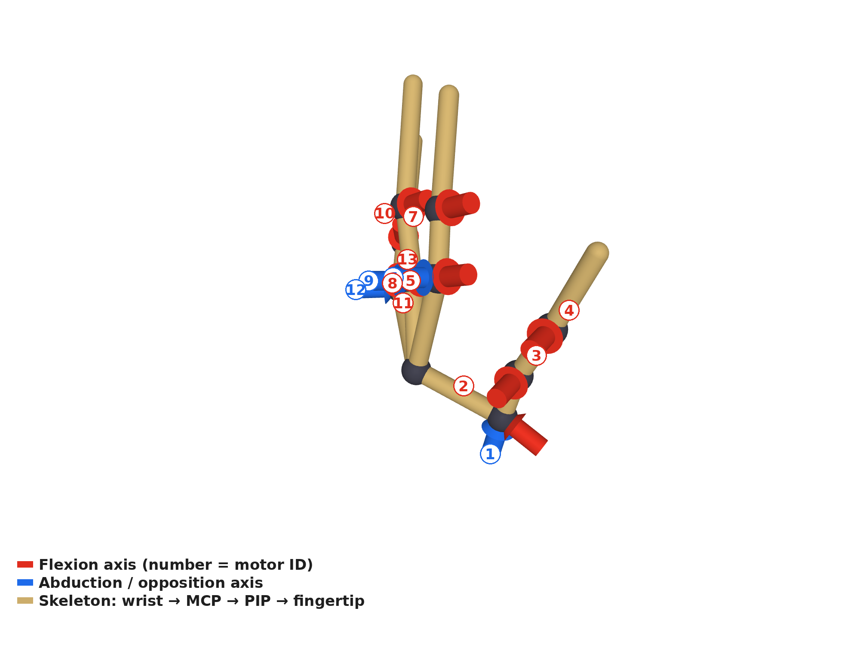
docs/figs/skeleton_zero_thumb_side_nomesh.png
