yepengfei81-cpu/Motor_Glove/docs/figs/skeleton_zero_top.png

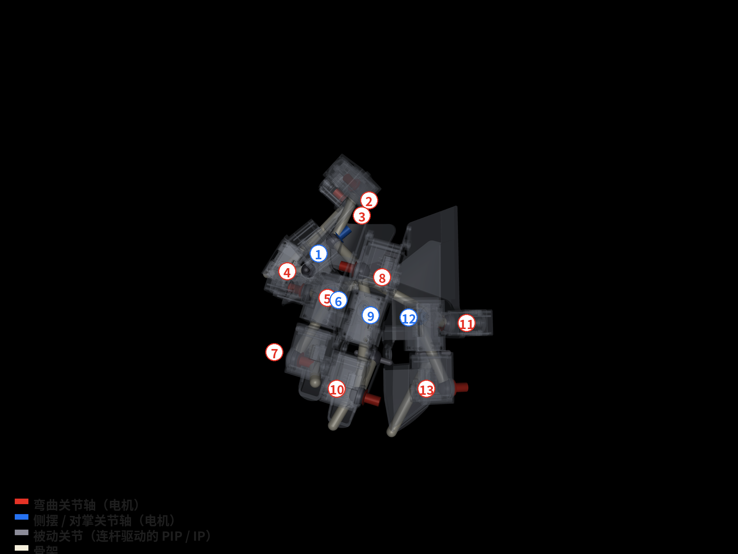
docs/figs/skeleton_zero_top.png
