yepengfei81-cpu/Motor_Glove/docs/mujoco_preview.png

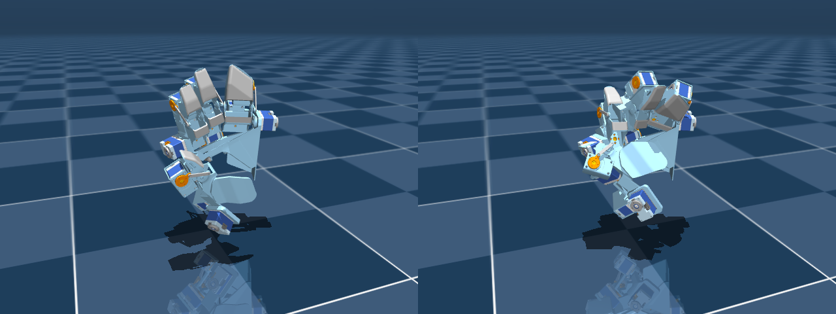
docs/mujoco_preview.png
