yepengfei81-cpu/Motor_Glove/docs/palm_down_check.png

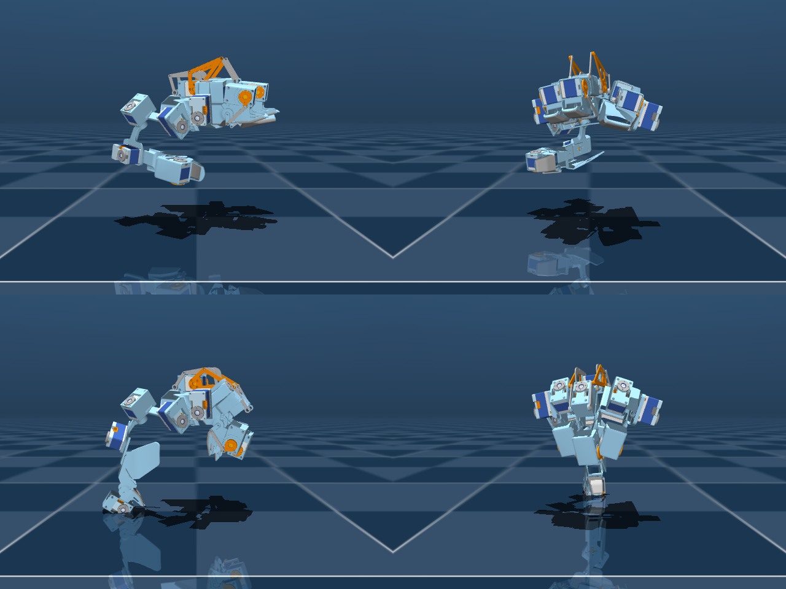
docs/palm_down_check.png
