yepengfei81-cpu/Motor_Glove/glove/assets/part_1.stl

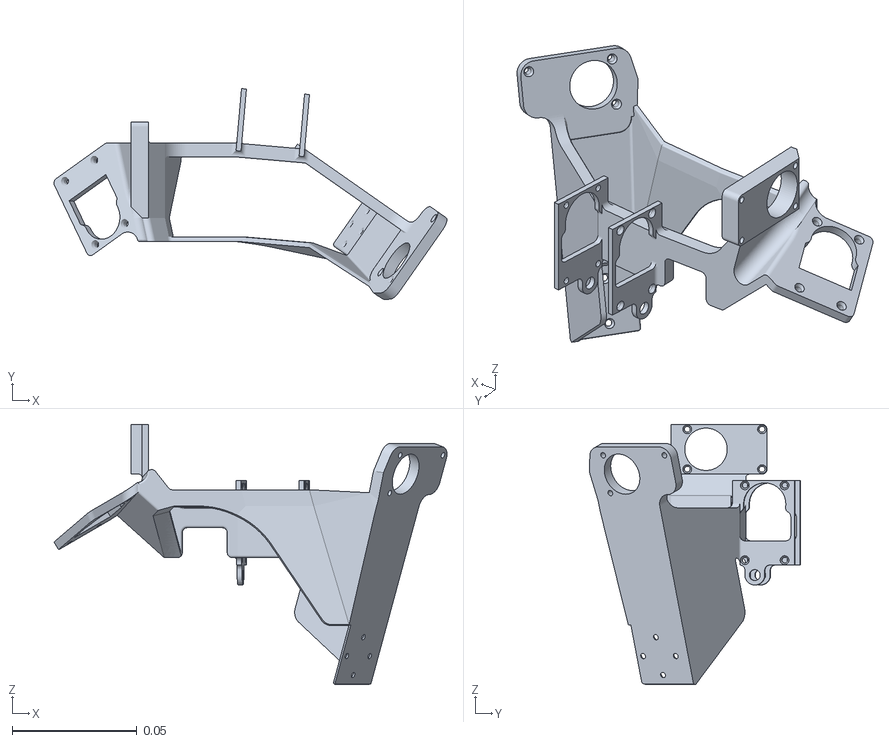
[picture p50: CAD file, 2026-10-20]
glove/assets/part_1.stl
0.158 x 0.0846 x 0.104
