yepengfei81-cpu/Motor_Glove/hand/assets/part_1__3.stl

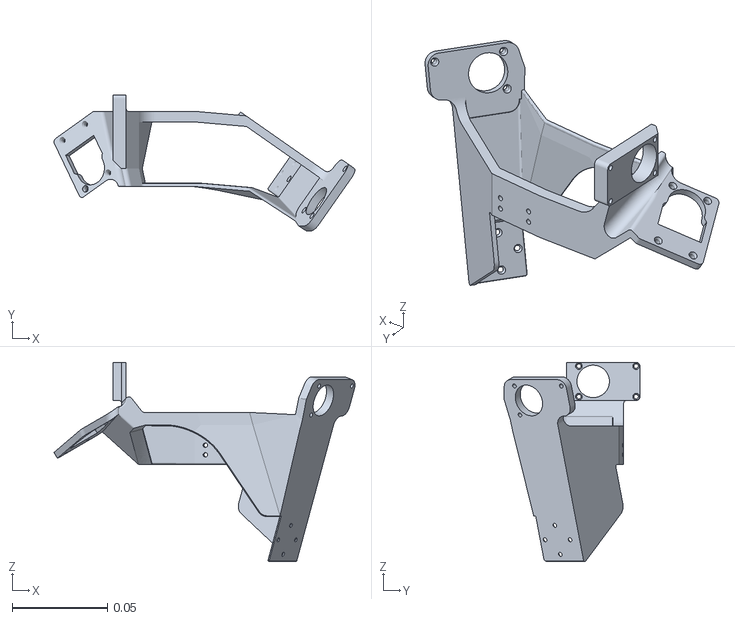
[picture p51: CAD file, 2026-10-20]
hand/assets/part_1__3.stl
0.158 x 0.0712 x 0.104
