yepengfei81-cpu/Motor_Glove/hand_mujoco/assets/part_1__15.stl

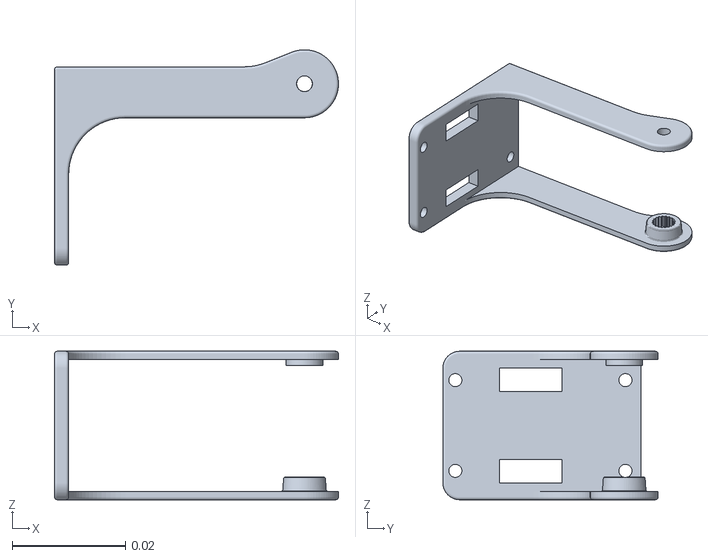
[picture p52: CAD file, 2026-10-20]
hand_mujoco/assets/part_1__15.stl
0.0501 x 0.038 x 0.0262
