yepengfei81-cpu/Motor_Glove/glove/assets/part_1__2.stl

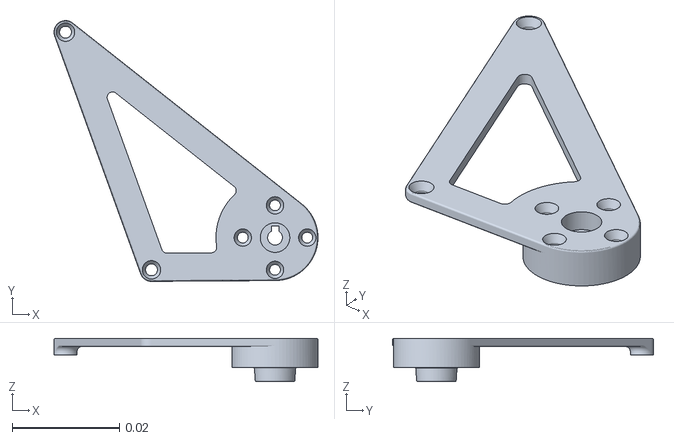
[picture p53: CAD file, 2026-10-16]
glove/assets/part_1__2.stl
0.0492 x 0.0485 x 0.00805
