yepengfei81-cpu/Motor_Glove/glove_mujoco/assets/part_1__34.stl

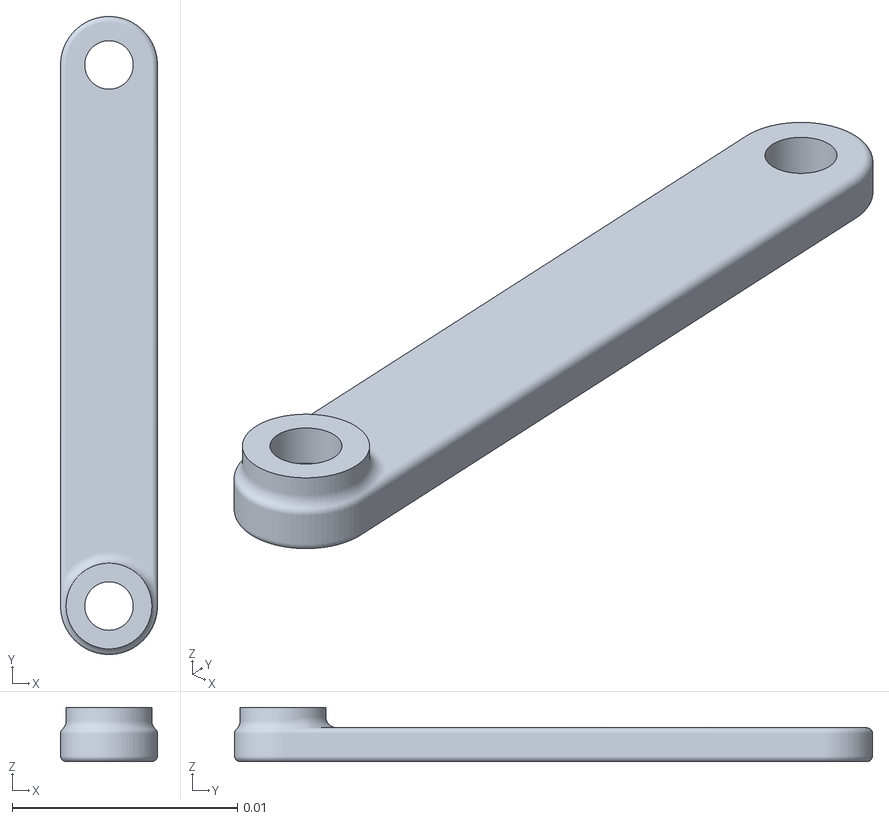
[picture p54: CAD file, 2026-10-16]
glove_mujoco/assets/part_1__34.stl
0.0043 x 0.0283 x 0.0024
