yepengfei81-cpu/Motor_Glove/glove/assets/part_1__32.stl

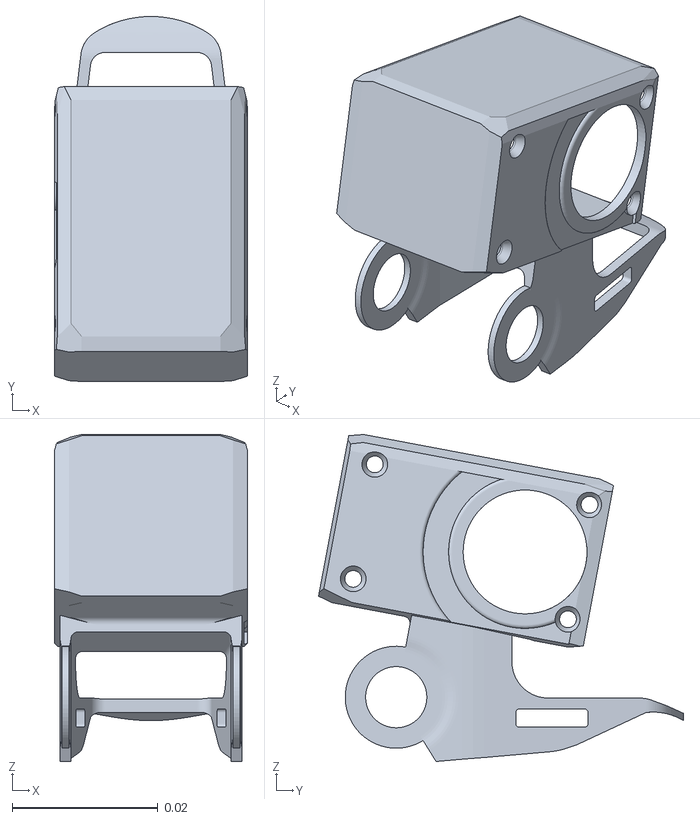
[picture p55: CAD file, 2026-10-16]
glove/assets/part_1__32.stl
0.0265 x 0.0501 x 0.0449
