yepengfei81-cpu/Motor_Glove/glove_mujoco/assets/part_1__6.stl

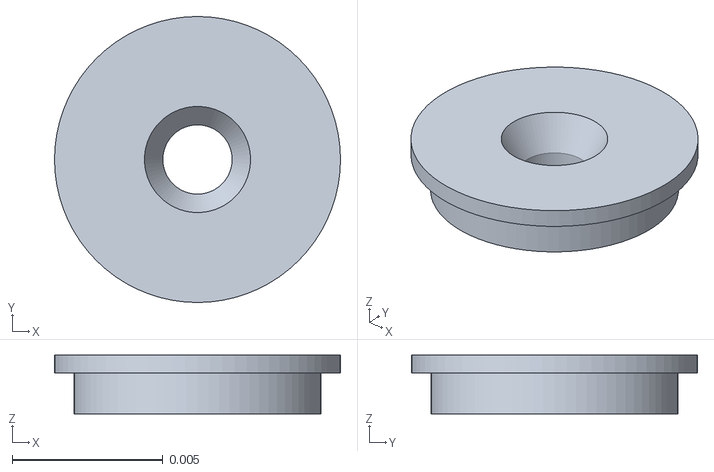
[picture p56: CAD file, 2026-10-16]
glove_mujoco/assets/part_1__6.stl
0.0095 x 0.0095 x 0.00195
