yepengfei81-cpu/Motor_Glove/hand/assets/part_1__14.stl

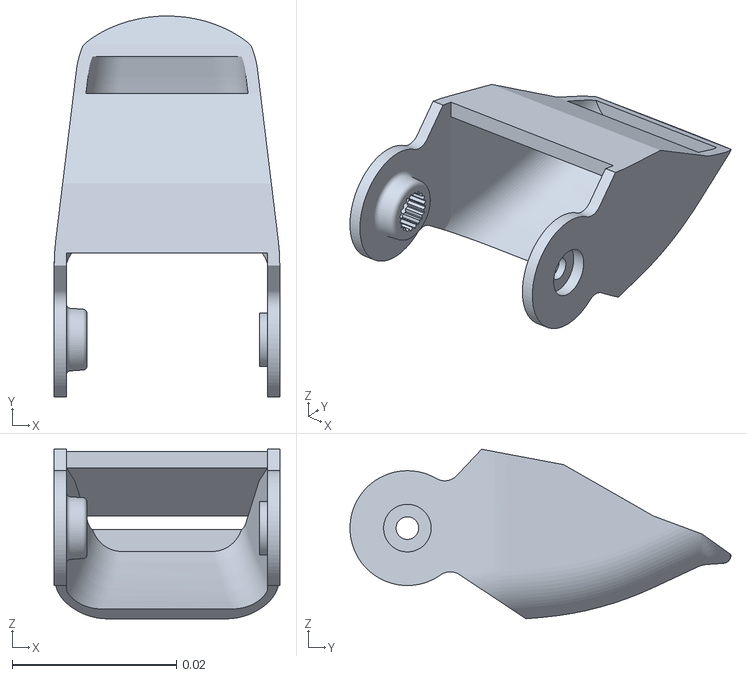
[picture p57: CAD file, 2026-10-20]
hand/assets/part_1__14.stl
0.0275 x 0.0464 x 0.0207
