yepengfei81-cpu/Motor_Glove/glove/assets/part_1__3.stl

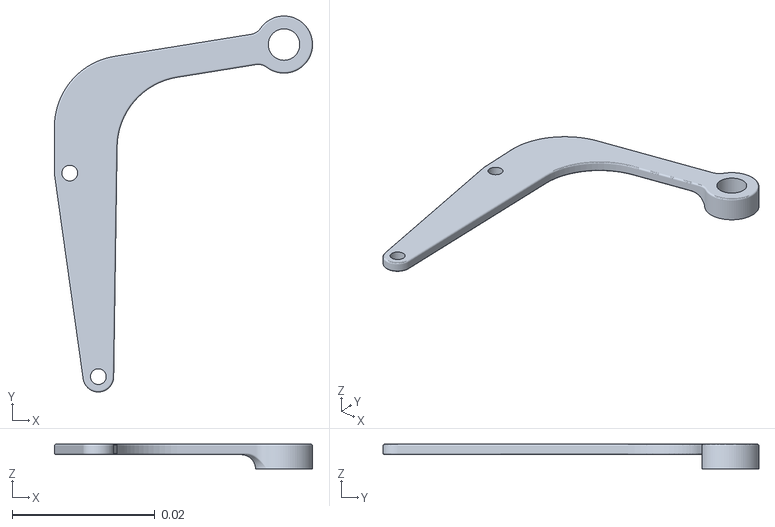
[picture p58: CAD file, 2026-10-16]
glove/assets/part_1__3.stl
0.0361 x 0.0526 x 0.0035
