yepengfei81-cpu/Motor_Glove/glove_mujoco/assets/part_1__4.stl

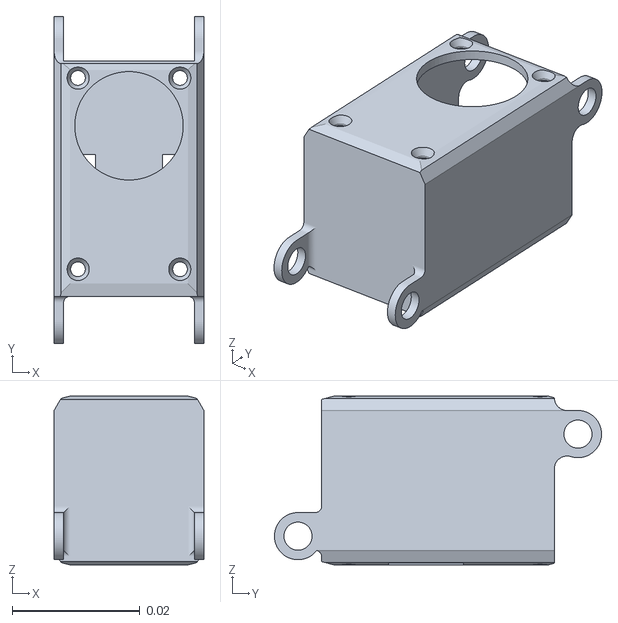
[picture p59: CAD file, 2026-10-16]
glove_mujoco/assets/part_1__4.stl
0.0235 x 0.0513 x 0.0265
