yepengfei81-cpu/Motor_Glove/hand/assets/part_1__6.stl

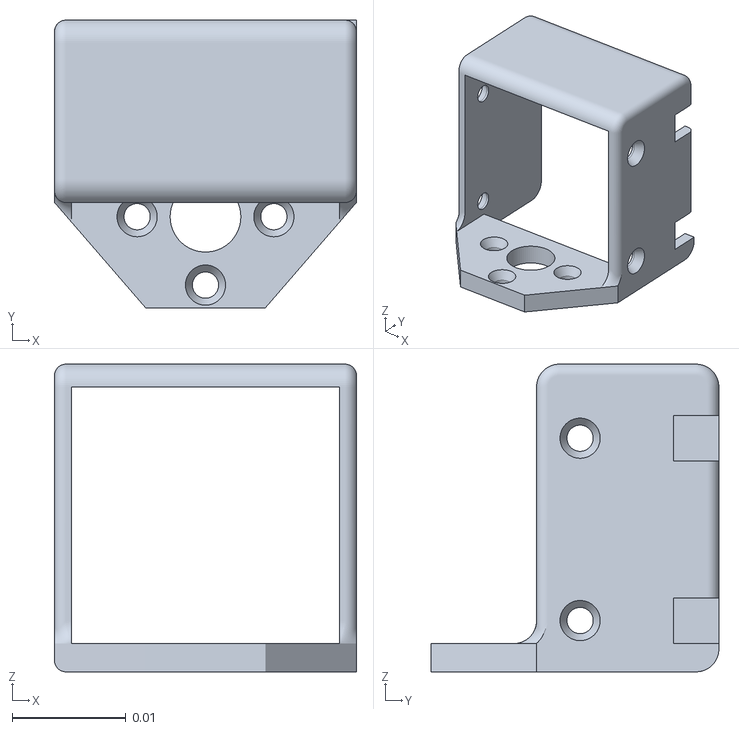
[picture p60: CAD file, 2026-10-20]
hand/assets/part_1__6.stl
0.0265 x 0.0252 x 0.027
