yepengfei81-cpu/Motor_Glove/hand_mujoco/assets/part_1__7.stl

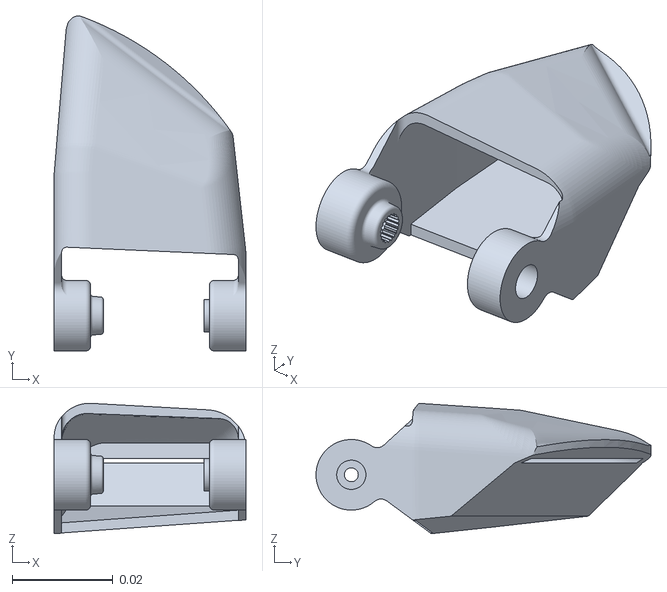
[picture p61: CAD file, 2026-10-20]
hand_mujoco/assets/part_1__7.stl
0.038 x 0.0664 x 0.0258
