yepengfei81-cpu/Motor_Glove/glove/assets/part_1__33.stl

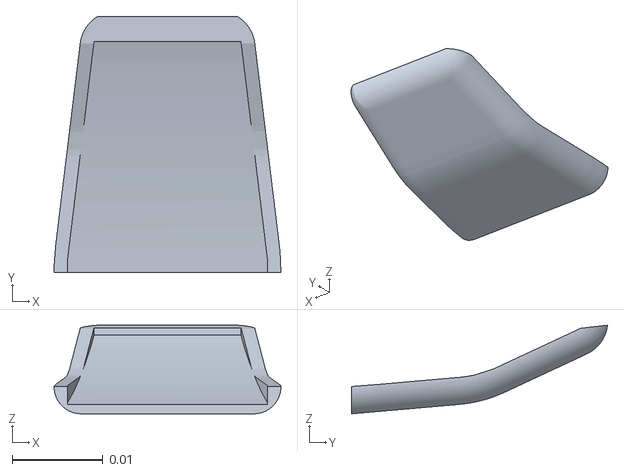
[picture p62: CAD file, 2026-10-16]
glove/assets/part_1__33.stl
0.025 x 0.0282 x 0.00976
