yepengfei81-cpu/Motor_Glove/glove_mujoco/assets/part_1__9.stl

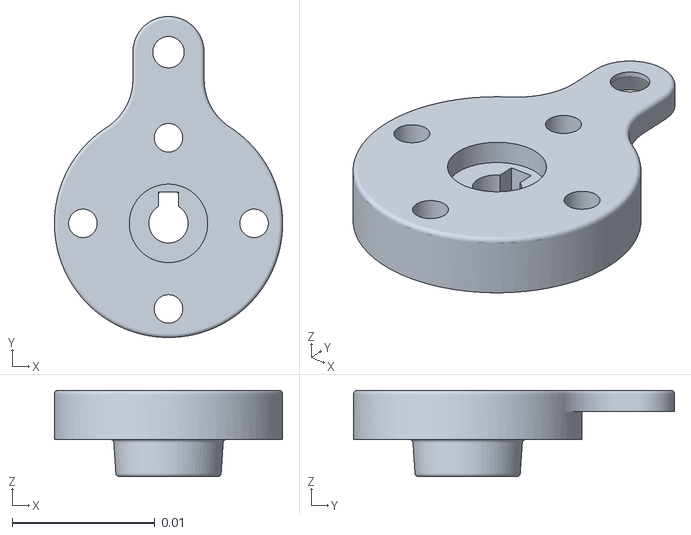
[picture p63: CAD file, 2026-10-16]
glove_mujoco/assets/part_1__9.stl
0.016 x 0.0225 x 0.00605
