yepengfei81-cpu/Motor_Glove/hand/assets/part_1__17.stl

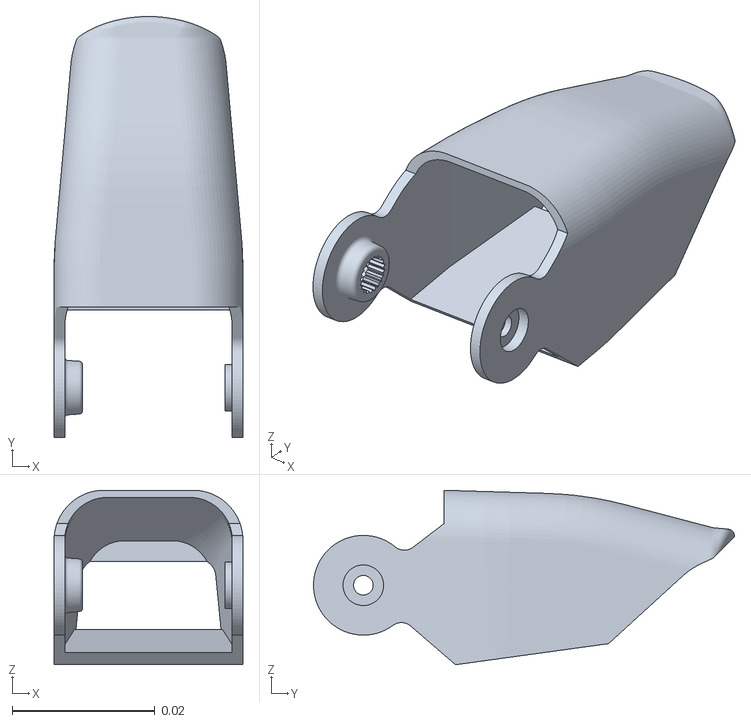
[picture p64: CAD file, 2026-10-20]
hand/assets/part_1__17.stl
0.0265 x 0.0591 x 0.0245
