yepengfei81-cpu/Motor_Glove/glove/assets/part_1__15.stl

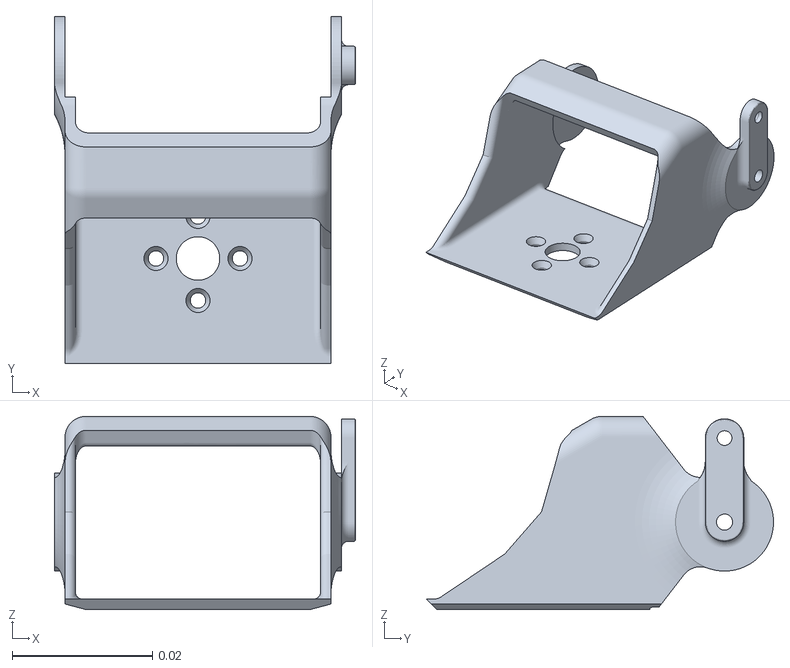
[picture p65: CAD file, 2026-10-16]
glove/assets/part_1__15.stl
0.043 x 0.0496 x 0.0276
