yepengfei81-cpu/Motor_Glove/hand/assets/part_1__16.stl

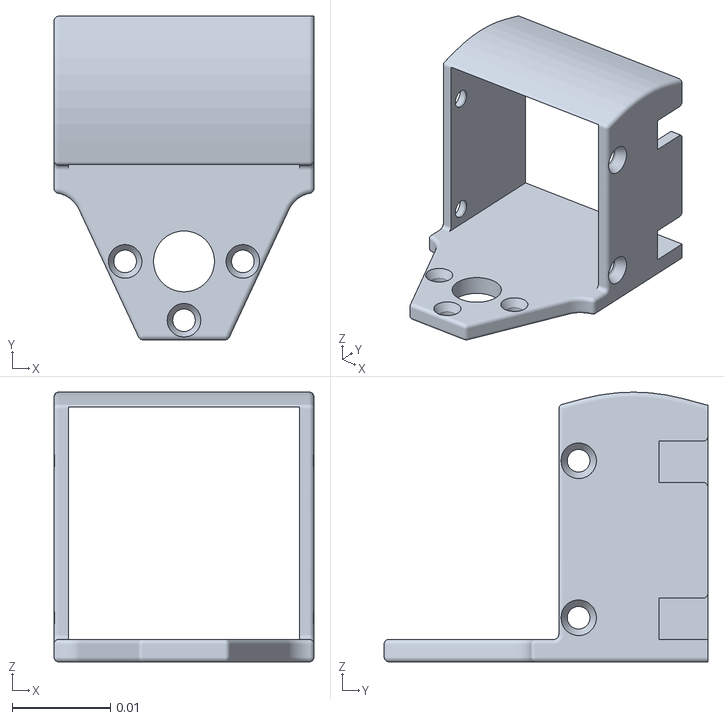
[picture p66: CAD file, 2026-10-20]
hand/assets/part_1__16.stl
0.0265 x 0.033 x 0.0275
