yepengfei81-cpu/Motor_Glove/hand_mujoco/assets/part_1__13.stl

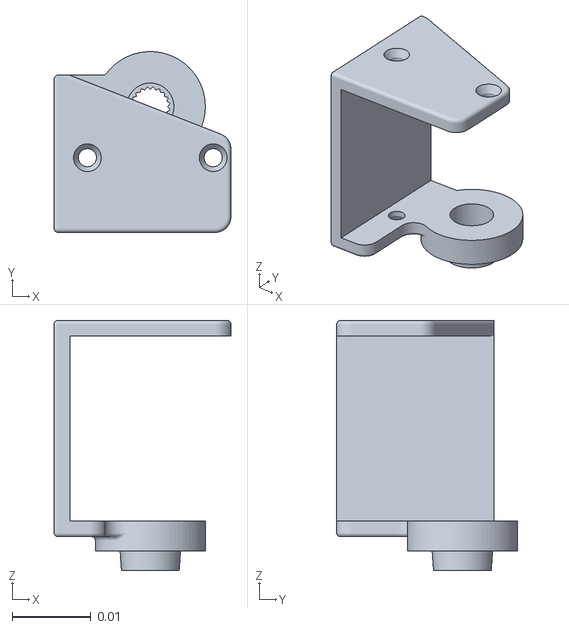
[picture p67: CAD file, 2026-10-20]
hand_mujoco/assets/part_1__13.stl
0.0225 x 0.023 x 0.0318
