yepengfei81-cpu/Motor_Glove/glove_mujoco/assets/part_1__10.stl

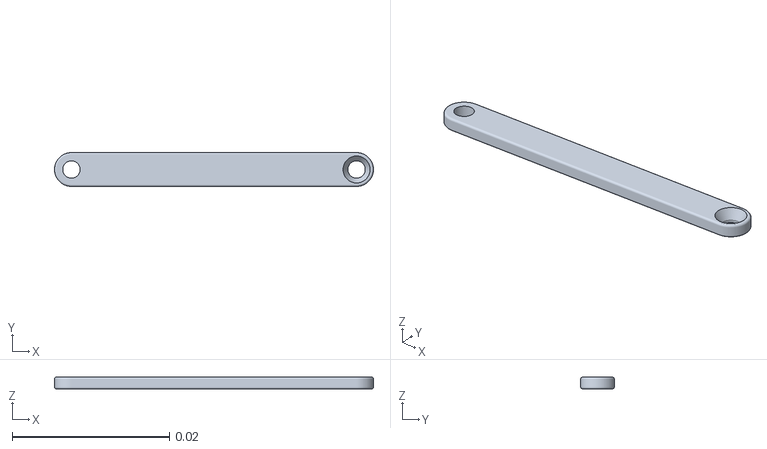
[picture p68: CAD file, 2026-10-16]
glove_mujoco/assets/part_1__10.stl
0.0405 x 0.0043 x 0.0015
