yepengfei81-cpu/Motor_Glove/hand_mujoco/assets/part_1__10.stl

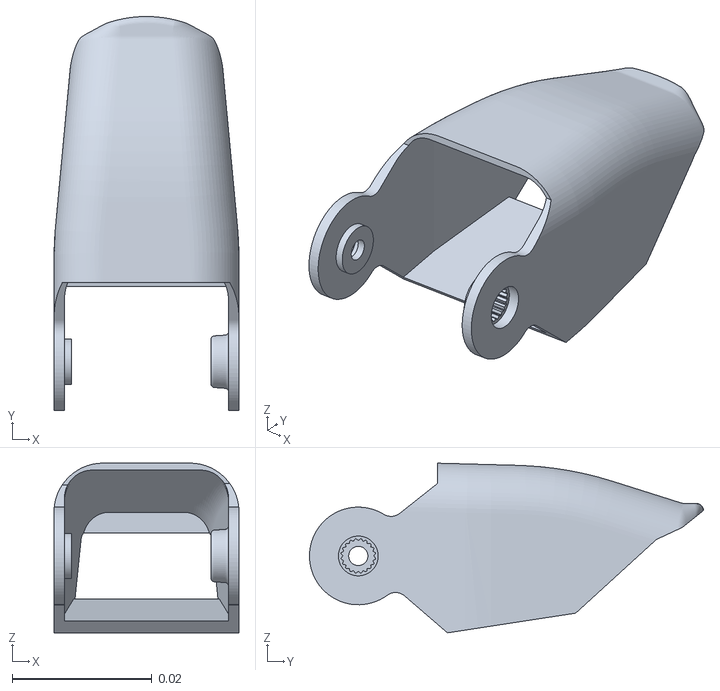
[picture p69: CAD file, 2026-10-20]
hand_mujoco/assets/part_1__10.stl
0.0265 x 0.0565 x 0.0243
