yepengfei81-cpu/Motor_Glove/glove/assets/part_1__20.stl

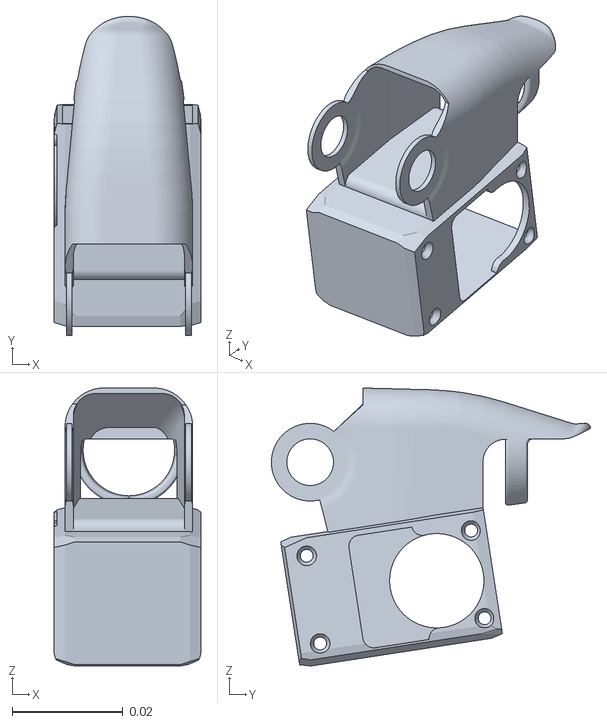
[picture p70: CAD file, 2026-10-16]
glove/assets/part_1__20.stl
0.0265 x 0.0576 x 0.0501
