yepengfei81-cpu/Motor_Glove/glove_mujoco/assets/part_1__28.stl

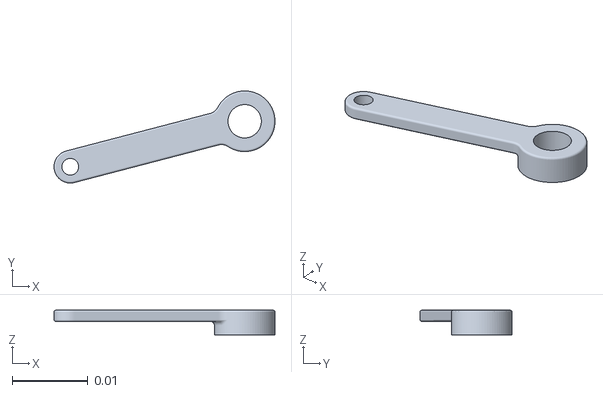
[picture p71: CAD file, 2026-10-16]
glove_mujoco/assets/part_1__28.stl
0.0291 x 0.0121 x 0.00325
