yepengfei81-cpu/Motor_Glove/hand_mujoco/assets/part_1.stl

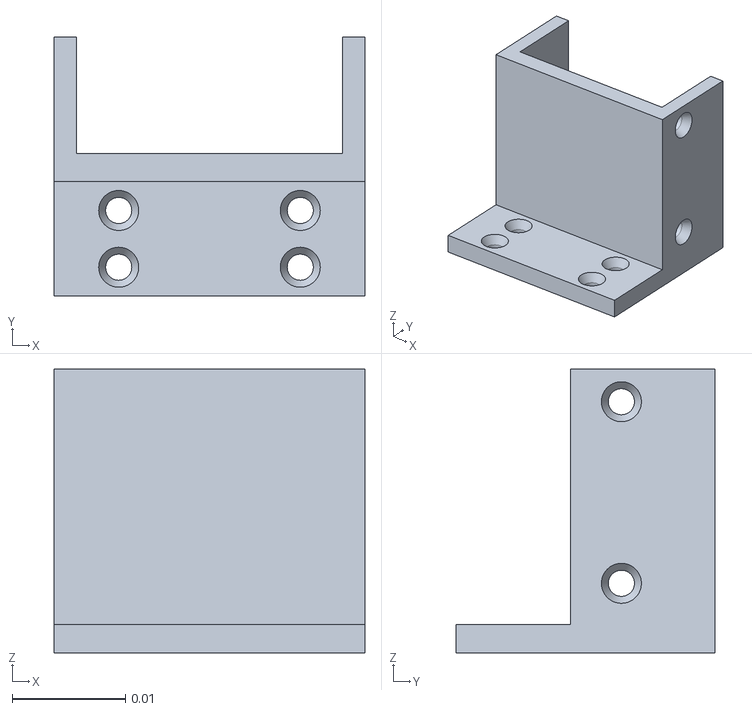
[picture p72: CAD file, 2026-10-20]
hand_mujoco/assets/part_1.stl
0.0274 x 0.0228 x 0.025
