yepengfei81-cpu/Motor_Glove/hand_mujoco/assets/part_1__9.stl

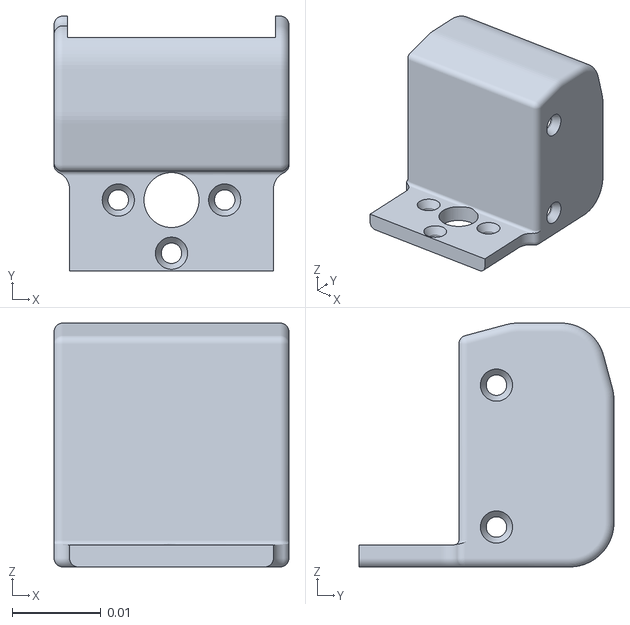
[picture p73: CAD file, 2026-10-20]
hand_mujoco/assets/part_1__9.stl
0.0265 x 0.0287 x 0.0275
