yepengfei81-cpu/Motor_Glove/glove/assets/part_1__31.stl

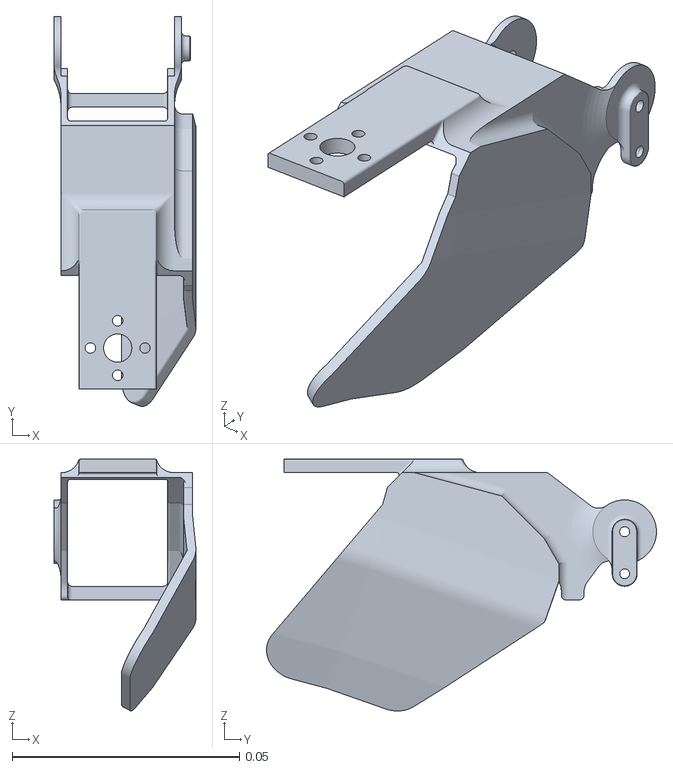
[picture p74: CAD file, 2026-10-16]
glove/assets/part_1__31.stl
0.0312 x 0.0858 x 0.0554
