yepengfei81-cpu/Motor_Glove/glove/assets/part_1__16.stl

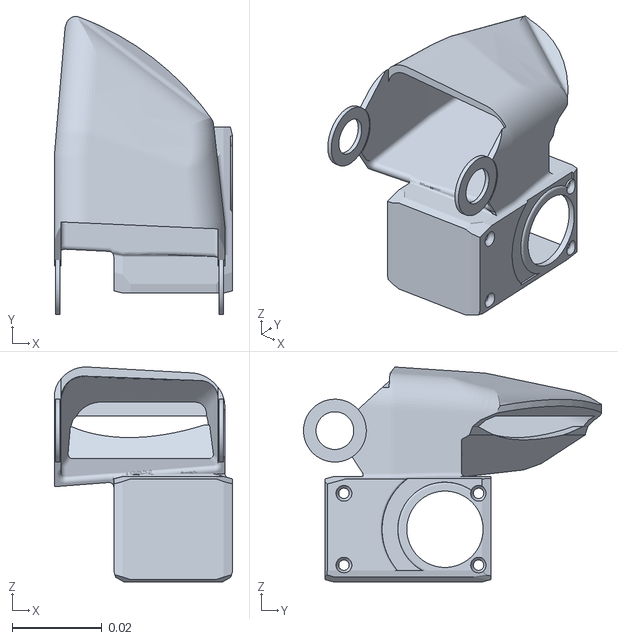
[picture p75: CAD file, 2026-10-16]
glove/assets/part_1__16.stl
0.0397 x 0.0664 x 0.0479
