yepengfei81-cpu/Motor_Glove/glove_mujoco/assets/part_1__26.stl

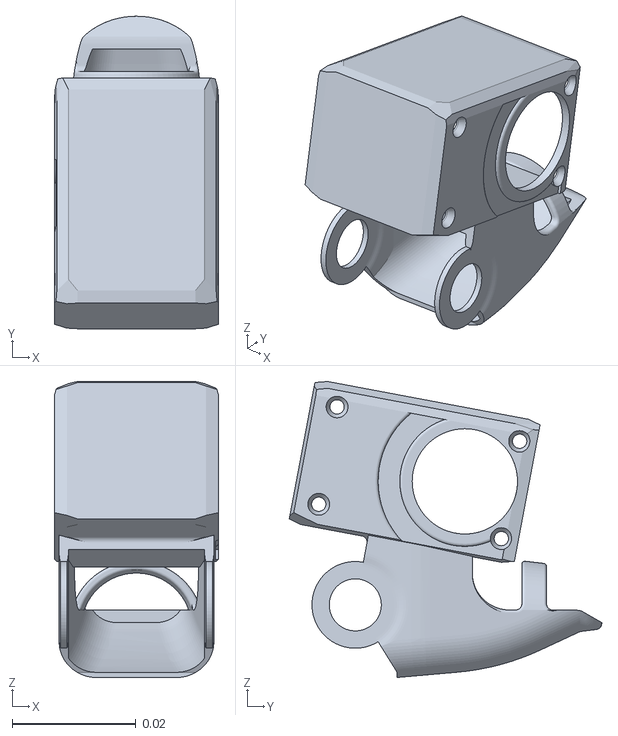
[picture p76: CAD file, 2026-10-16]
glove_mujoco/assets/part_1__26.stl
0.0265 x 0.0505 x 0.0478
