yepengfei81-cpu/Motor_Glove/glove/assets/part_1__11.stl

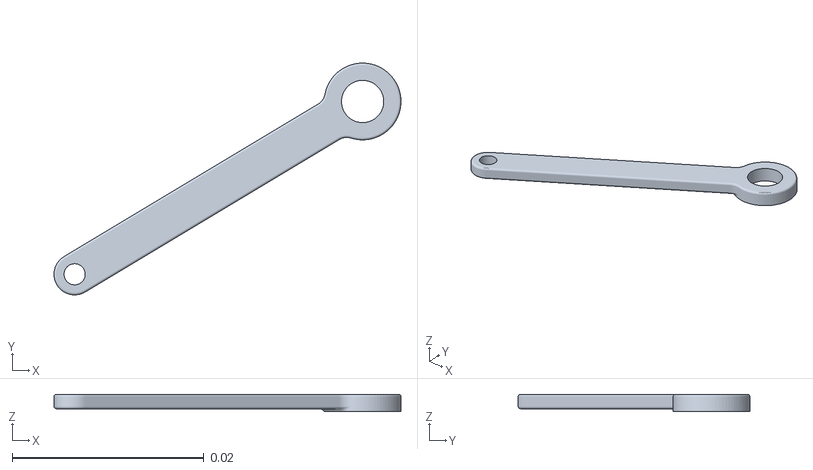
[picture p77: CAD file, 2026-10-16]
glove/assets/part_1__11.stl
0.0361 x 0.0241 x 0.0018
