yepengfei81-cpu/Motor_Glove/hand/assets/dc15_a01_horn_dummy.stl

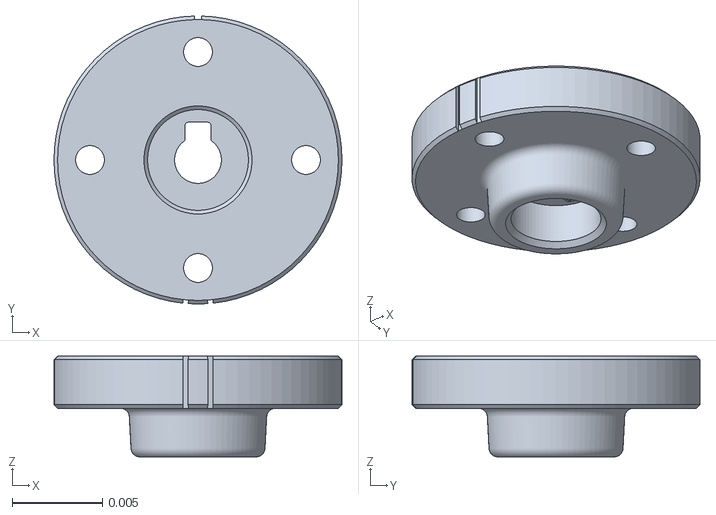
[picture p78: CAD file, 2026-10-16]
hand/assets/dc15_a01_horn_dummy.stl
0.016 x 0.016 x 0.0056
