yepengfei81-cpu/Motor_Glove/hand_mujoco/assets/bts2_m2_6x8_1.stl

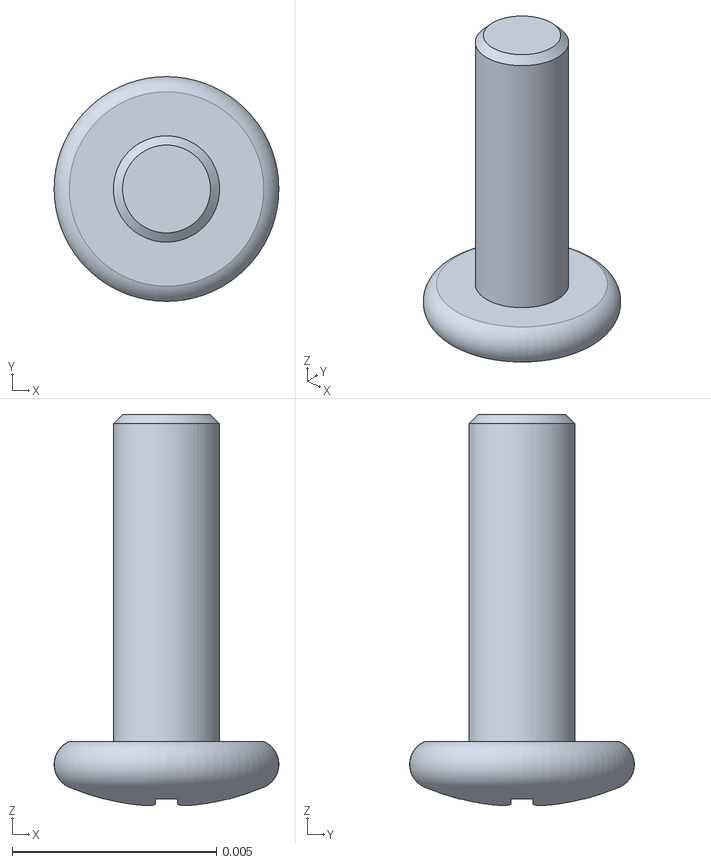
[picture p79: CAD file, 2026-10-16]
hand_mujoco/assets/bts2_m2_6x8_1.stl
0.0055 x 0.0055 x 0.00957
