yepengfei81-cpu/Motor_Glove/glove/assets/part_1__17.stl

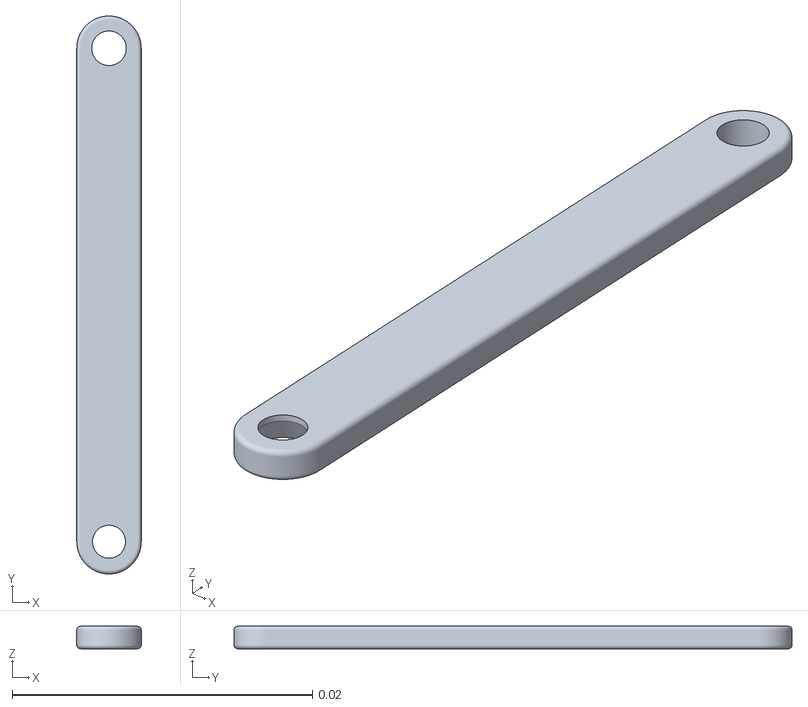
[picture p80: CAD file, 2026-10-16]
glove/assets/part_1__17.stl
0.0043 x 0.0372 x 0.0015
