yepengfei81-cpu/Motor_Glove/hand_mujoco/assets/dc15_a01_case_b_dummy.stl

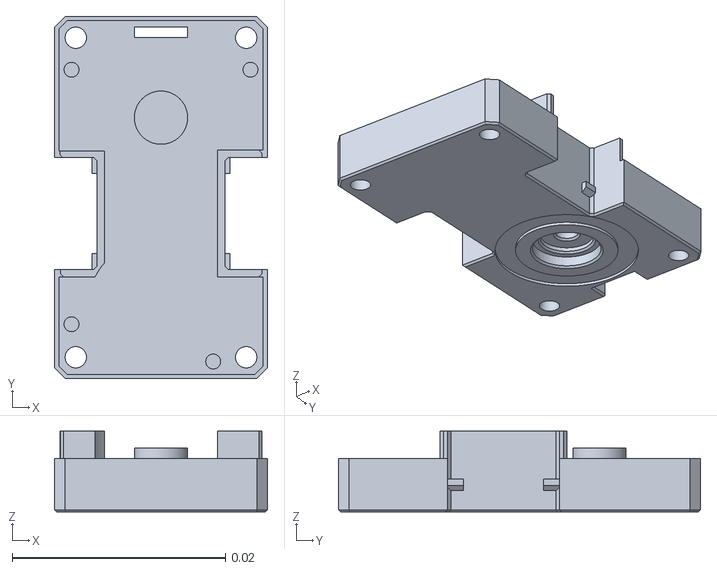
[picture p82: CAD file, 2026-10-16]
hand_mujoco/assets/dc15_a01_case_b_dummy.stl
0.02 x 0.034 x 0.0076
