yepengfei81-cpu/Motor_Glove/glove/assets/part_1__21.stl

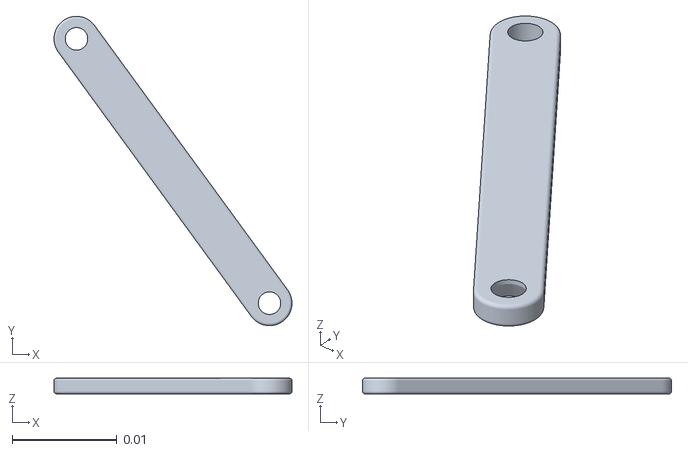
[picture p83: CAD file, 2026-10-16]
glove/assets/part_1__21.stl
0.0227 x 0.0295 x 0.0015
