yepengfei81-cpu/Motor_Glove/hand/assets/part_1__4.stl

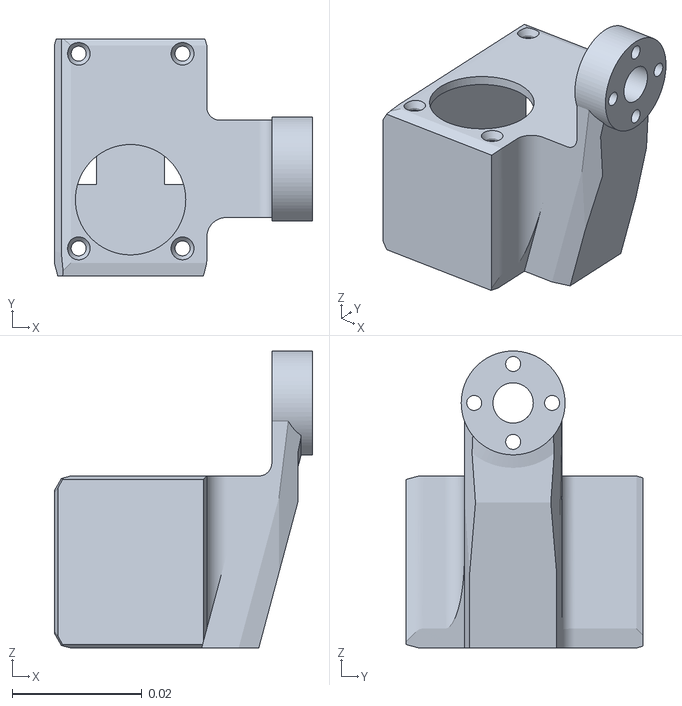
[picture p84: CAD file, 2026-10-16]
hand/assets/part_1__4.stl
0.0398 x 0.0365 x 0.0457
