yepengfei81-cpu/Motor_Glove/hand_mujoco/assets/dc15_a01_led_cap2_dummy.stl

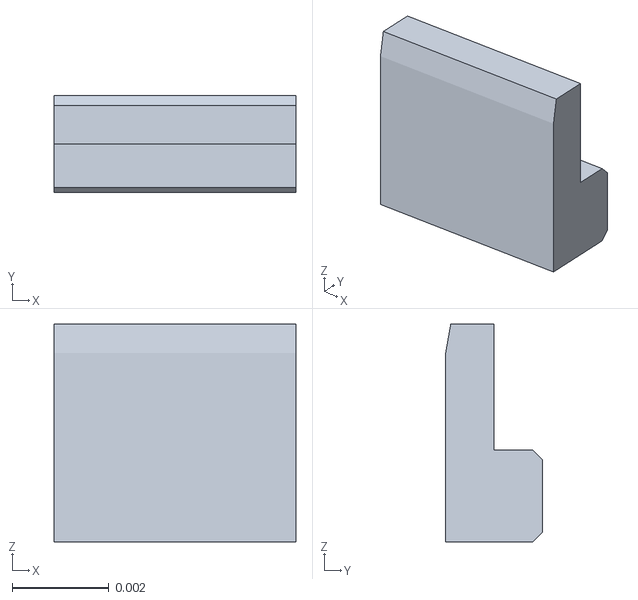
[picture p85: CAD file, 2026-10-16]
hand_mujoco/assets/dc15_a01_led_cap2_dummy.stl
0.005 x 0.002 x 0.0045
