yepengfei81-cpu/Motor_Glove/glove/assets/part_1__7.stl

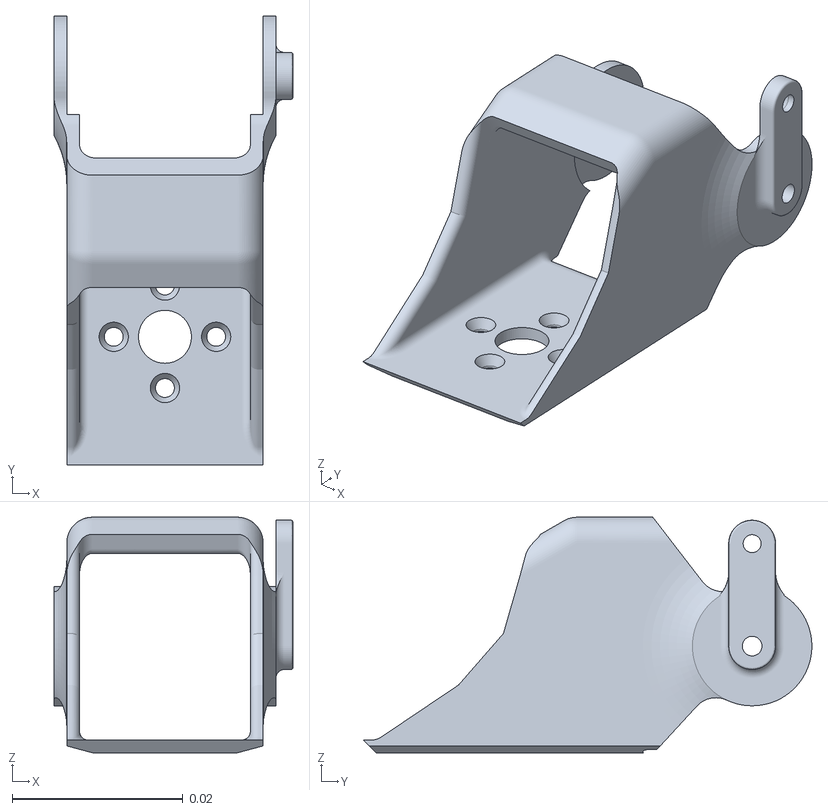
[picture p86: CAD file, 2026-10-16]
glove/assets/part_1__7.stl
0.028 x 0.0526 x 0.0276
