yepengfei81-cpu/Motor_Glove/glove_mujoco/assets/part_1__29.stl

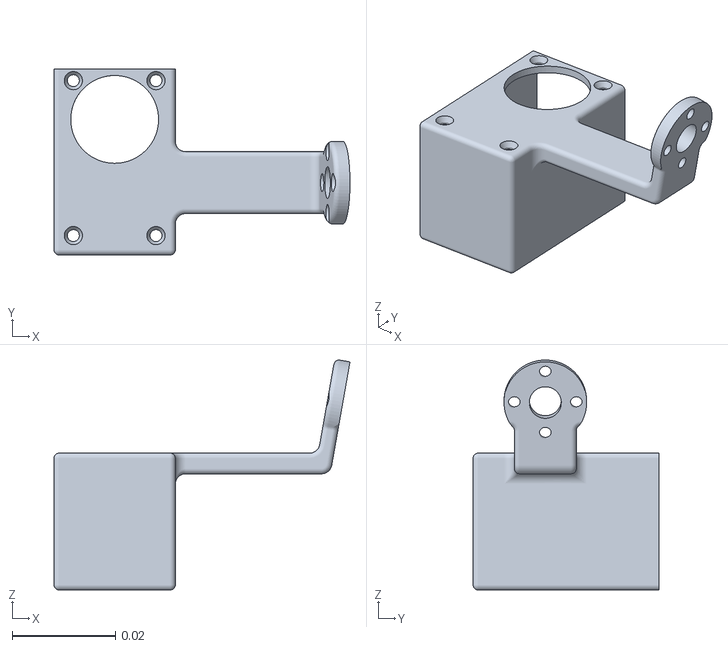
[picture p87: CAD file, 2026-10-16]
glove_mujoco/assets/part_1__29.stl
0.0573 x 0.036 x 0.0445
