yepengfei81-cpu/Motor_Glove/glove/assets/part_1__30.stl

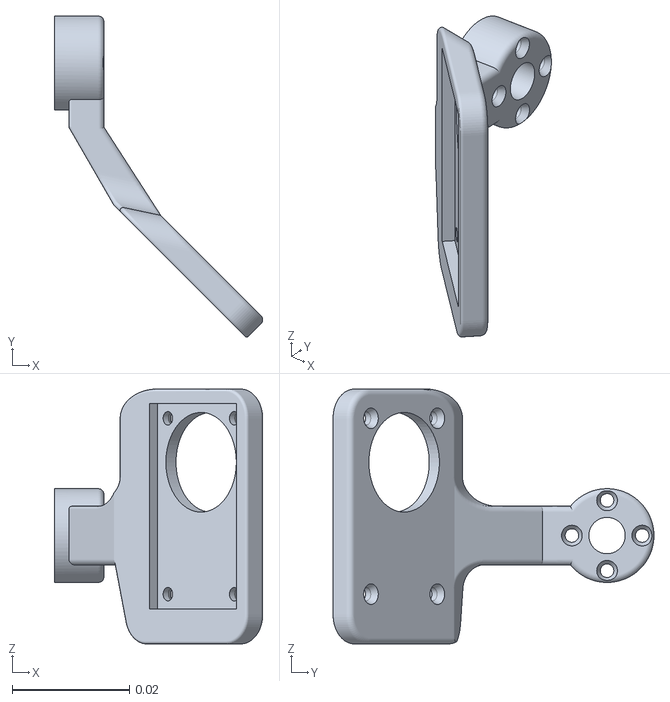
[picture p88: CAD file, 2026-10-16]
glove/assets/part_1__30.stl
0.0356 x 0.0547 x 0.0435
