yepengfei81-cpu/Motor_Glove/hand/assets/part_1__12.stl

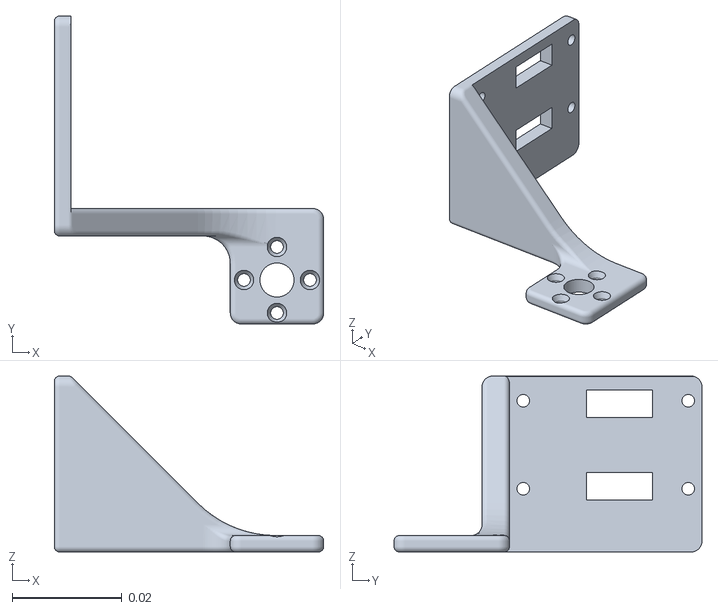
[picture p89: CAD file, 2026-10-16]
hand/assets/part_1__12.stl
0.049 x 0.056 x 0.032
