yepengfei81-cpu/Motor_Glove/hand_mujoco/assets/dc15_a01_idle_cap_dummy.stl

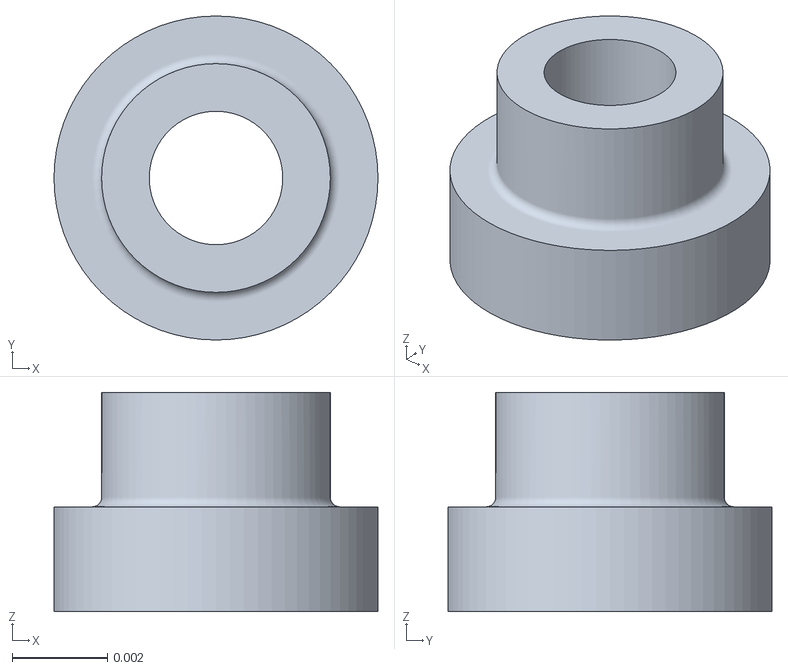
[picture p90: CAD file, 2026-10-16]
hand_mujoco/assets/dc15_a01_idle_cap_dummy.stl
0.0068 x 0.0068 x 0.0046
