yepengfei81-cpu/Motor_Glove/glove/assets/part_1__8.stl

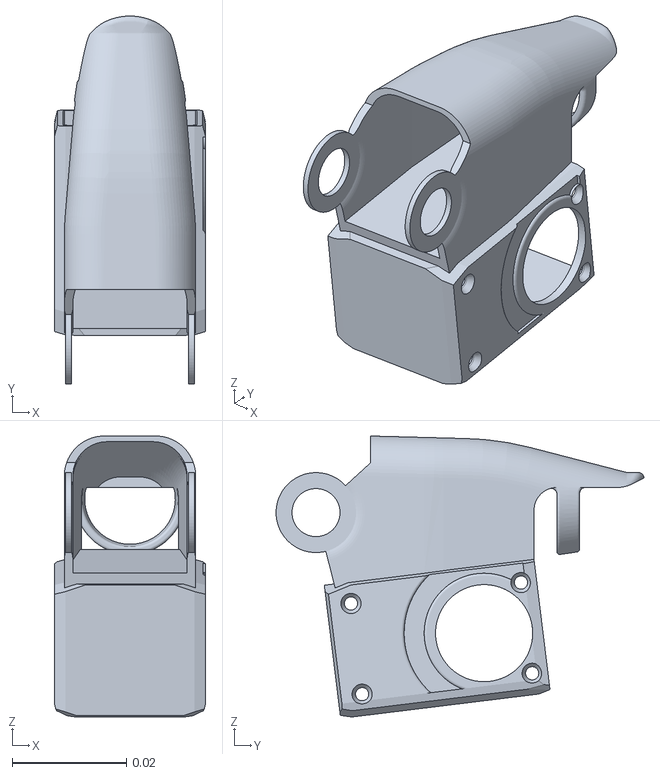
[picture p91: CAD file, 2026-10-16]
glove/assets/part_1__8.stl
0.0265 x 0.0644 x 0.0492
