yepengfei81-cpu/Motor_Glove/hand/assets/part_1__8.stl

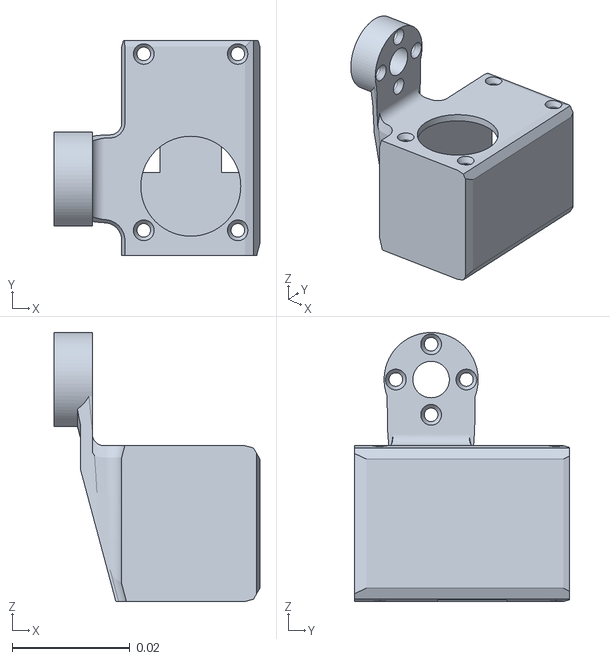
[picture p92: CAD file, 2026-10-16]
hand/assets/part_1__8.stl
0.035 x 0.0365 x 0.0457
