yepengfei81-cpu/Motor_Glove/hand_mujoco/assets/phs_1_7x20_5_dc10_1.stl

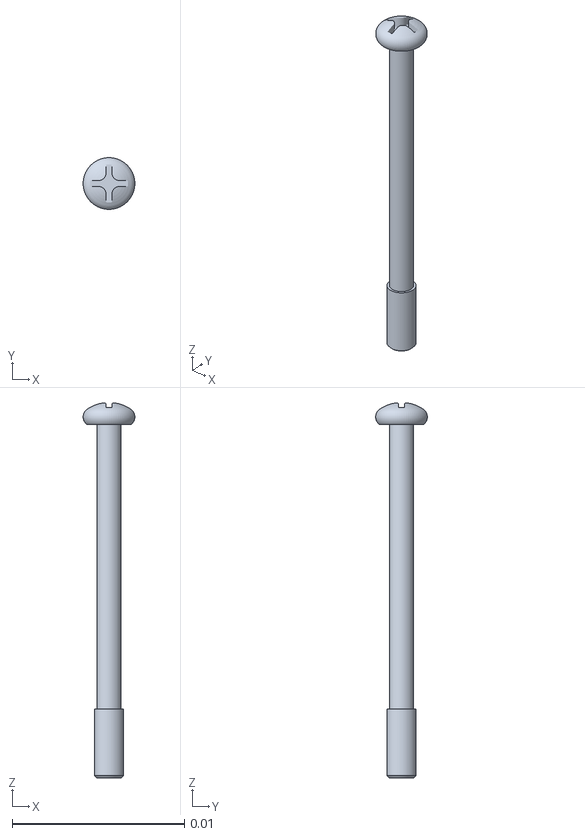
[picture p93: CAD file, 2026-10-16]
hand_mujoco/assets/phs_1_7x20_5_dc10_1.stl
0.003 x 0.003 x 0.0218
