yepengfei81-cpu/Motor_Glove/hand/assets/b3b_eh_1.stl

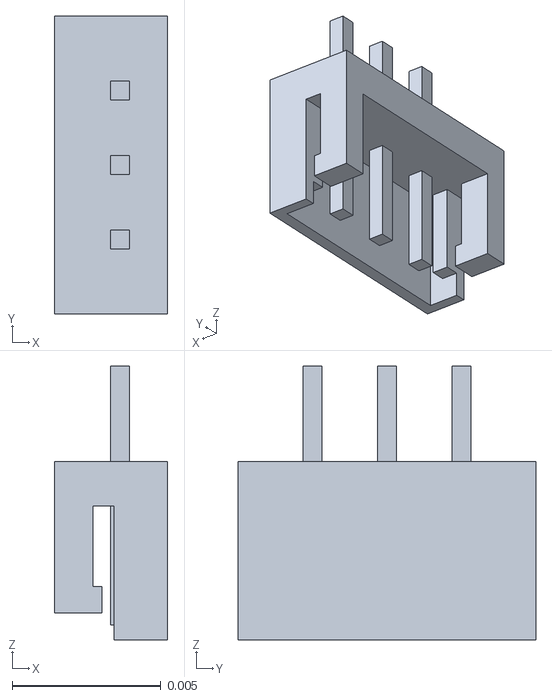
[picture p94: CAD file, 2026-10-16]
hand/assets/b3b_eh_1.stl
0.0038 x 0.01 x 0.0092
