yepengfei81-cpu/Motor_Glove/glove_mujoco/assets/part_1__19.stl

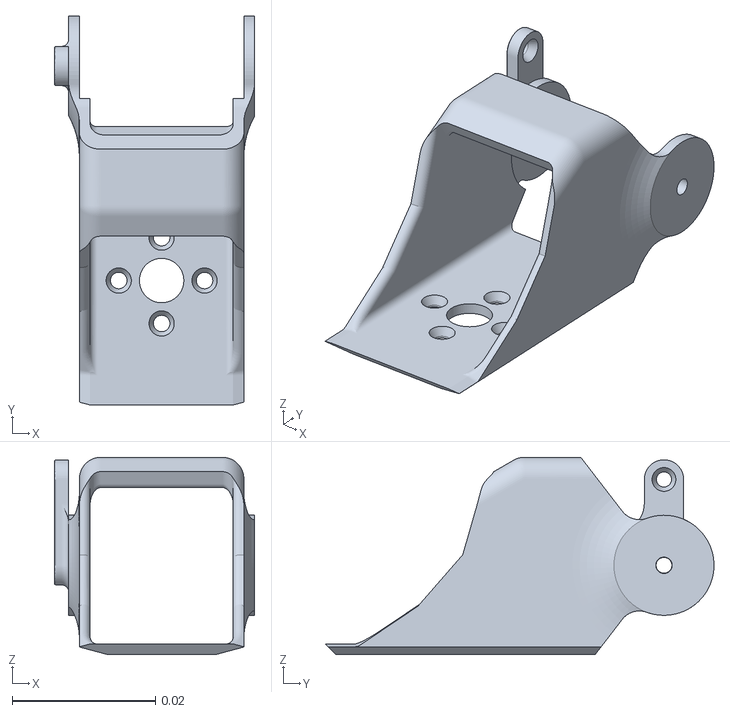
[picture p95: CAD file, 2026-10-16]
glove_mujoco/assets/part_1__19.stl
0.028 x 0.0544 x 0.0276
