yepengfei81-cpu/Motor_Glove/hand/assets/dc15_a01_case_f_dummy.stl

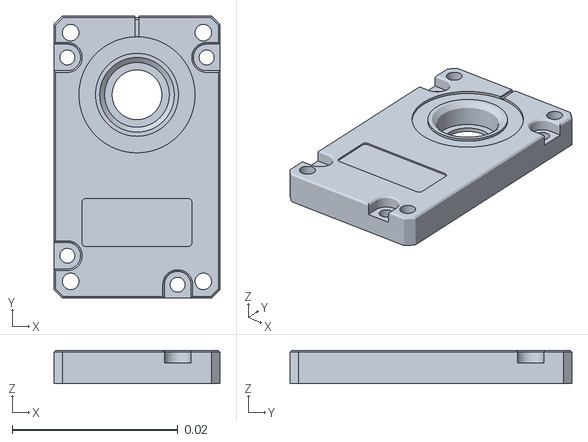
[picture p96: CAD file, 2026-10-16]
hand/assets/dc15_a01_case_f_dummy.stl
0.02 x 0.034 x 0.004
