yepengfei81-cpu/Motor_Glove/glove/assets/part_1__12.stl

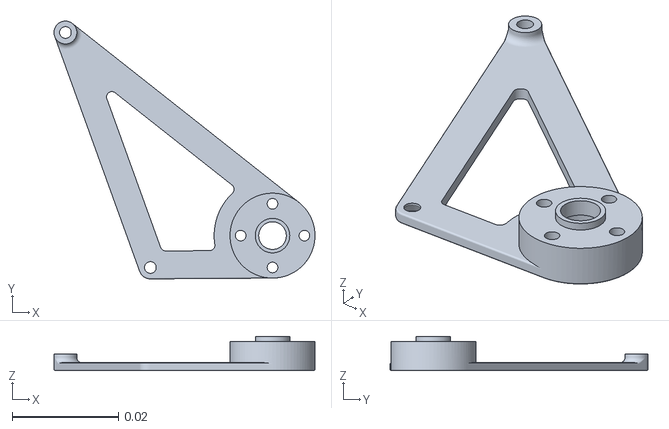
[picture p97: CAD file, 2026-10-16]
glove/assets/part_1__12.stl
0.0492 x 0.0485 x 0.00645
