yepengfei81-cpu/Motor_Glove/glove/assets/part_1__25.stl

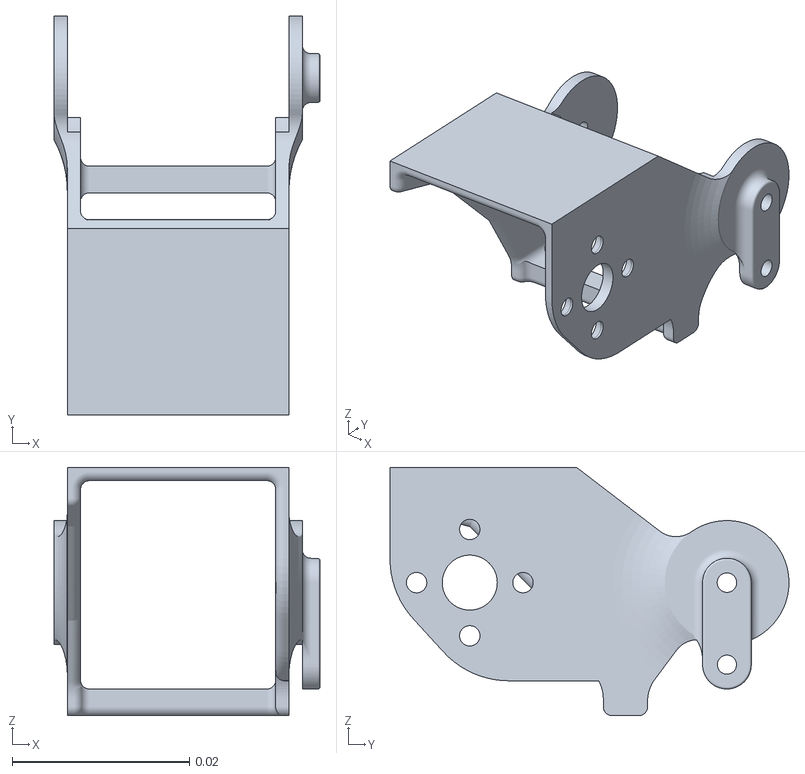
[picture p98: CAD file, 2026-10-16]
glove/assets/part_1__25.stl
0.03 x 0.045 x 0.028
