yepengfei81-cpu/Motor_Glove/hand/assets/part_1__11.stl

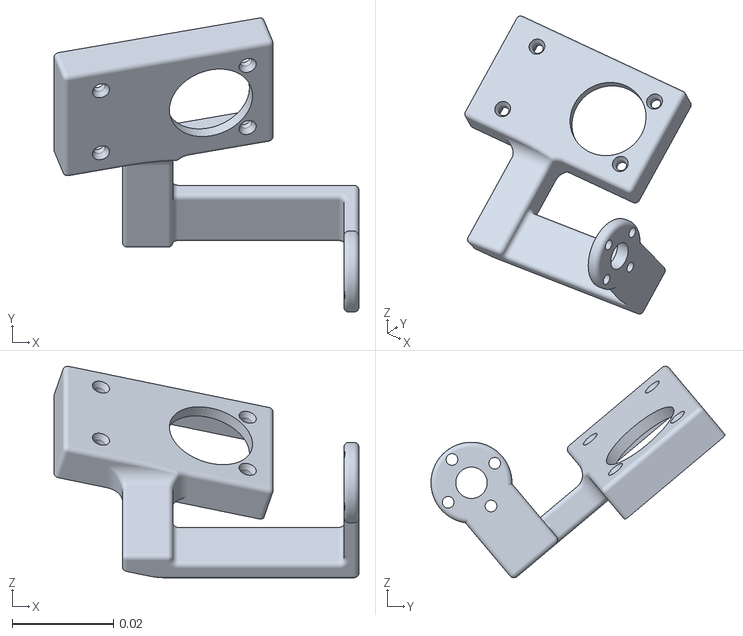
[picture p99: CAD file, 2026-10-16]
hand/assets/part_1__11.stl
0.0603 x 0.0581 x 0.0418
