yepengfei81-cpu/Motor_Glove/hand/assets/part_1__5.stl

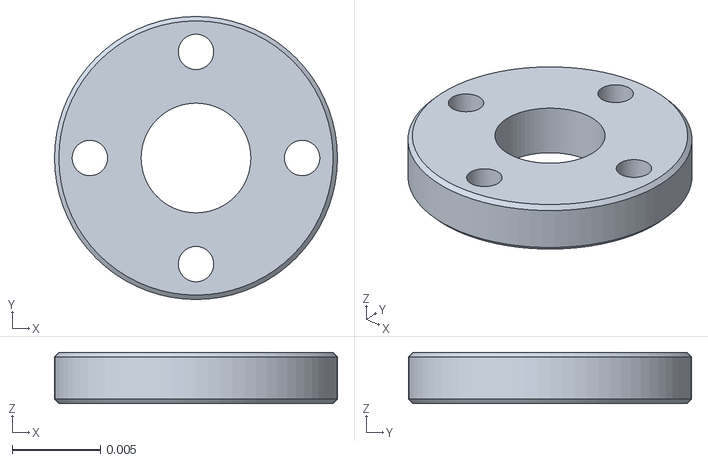
[picture p100: CAD file, 2026-10-16]
hand/assets/part_1__5.stl
0.016 x 0.016 x 0.0029
