yepengfei81-cpu/Motor_Glove/hand_mujoco/assets/dc15_a01_horn_idle2_dummy.stl

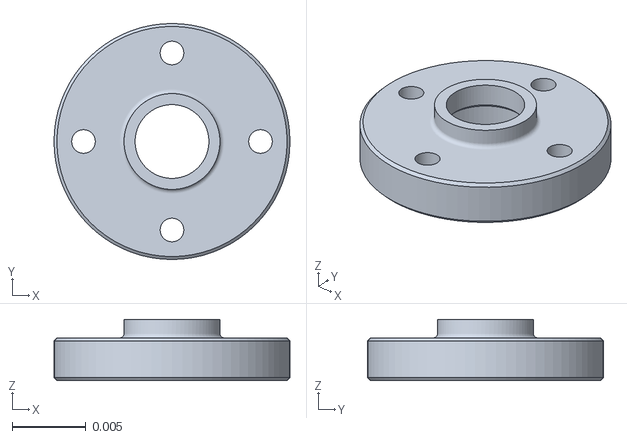
[picture p101: CAD file, 2026-10-16]
hand_mujoco/assets/dc15_a01_horn_idle2_dummy.stl
0.016 x 0.016 x 0.00415
