yepengfei81-cpu/Motor_Glove/(list of files, cad)

Other CAD files:
hand_mujoco/assets/bts2_m2_6x8.stl
glove_mujoco/assets/part_1__13.stl
glove/assets/part_1__13.stl
hand_mujoco/assets/b3b_eh.stl
hand/assets/phs_1_7x20_5_dc10.stl
hand/assets/b3b_eh.stl
hand_mujoco/assets/phs_1_7x20_5_dc10_3.stl
hand/assets/phs_1_7x20_5_dc10_2.stl
hand/assets/phs_1_7x20_5_dc10_3.stl
hand_mujoco/assets/phs_1_7x20_5_dc10.stl
hand/assets/bts2_m2_6x8.stl
hand_mujoco/assets/phs_1_7x20_5_dc10_2.stl
