yepengfei81-cpu/Motor_Glove/glove/robot.urdf

<?xml version='1.0' encoding='utf-8'?>
<robot name="glove">
  
  <link name="part_1">
    <inertial>
      <origin xyz="0.0310784 0.0195374 0.00547114" rpy="0 0 0" /><mass value="0.121822" />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</inertial>
    
    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
  </link>
  
  <link name="part_1_2">
    <inertial>
      <origin xyz="-0.0105507 -0.0069616 -0.00345433" rpy="0 0 0" /><mass value="0.00228171" />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</inertial>
    
    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
  </link>
  
  <link name="closing_mid_mcp_1_r_2">
    <origin xyz="0 0 0" rpy="0 -0 0" />
    <inertial>
      <origin xyz="0 0 0" rpy="0 0 0" /><mass value="0.001" />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</inertial>
  </link>
  <joint name="closing_mid_mcp_1_r_2_frame" type="fixed">
    <origin xyz="-0.039 -0.03825 -0.00425" rpy="-3.14159 0 -0" />
    <parent link="part_1_2" />
    <child link="closing_mid_mcp_1_r_2" />
    <axis xyz="0 0 0" />
  </joint>
  
  <link name="closing_mid_mcp_1_r_2_z">
    <origin xyz="0 0 0" rpy="0 -0 0" />
    <inertial>
      <origin xyz="0 0 0" rpy="0 0 0" /><mass value="0.001" />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</inertial>
  </link>
  <joint name="closing_mid_mcp_1_r_2_z_frame" type="fixed">
    <origin xyz="-0.039 -0.03825 -0.10425" rpy="-3.14159 0 -0" />
    <parent link="part_1_2" />
    <child link="closing_mid_mcp_1_r_2_z" />
    <axis xyz="0 0 0" />
  </joint>
  
  <link name="part_1_3">
    <inertial>
      <origin xyz="0 0 0" rpy="0 0 0" /><mass value="0.001" />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</inertial>
    
    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
  </link>
  
  <link name="closing_mid_mcp_2_r_2">
    <origin xyz="0 0 0" rpy="0 -0 0" />
    <inertial>
      <origin xyz="0 0 0" rpy="0 0 0" /><mass value="0.001" />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</inertial>
  </link>
  <joint name="closing_mid_mcp_2_r_2_frame" type="fixed">
    <origin xyz="0.004 -0.0285 0.00075" rpy="-0 -0 -0" />
    <parent link="part_1_3" />
    <child link="closing_mid_mcp_2_r_2" />
    <axis xyz="0 0 0" />
  </joint>
  
  <link name="closing_mid_mcp_2_r_2_z">
    <origin xyz="0 0 0" rpy="0 -0 0" />
    <inertial>
      <origin xyz="0 0 0" rpy="0 0 0" /><mass value="0.001" />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</inertial>
  </link>
  <joint name="closing_mid_mcp_2_r_2_z_frame" type="fixed">
    <origin xyz="0.004 -0.0285 0.10075" rpy="-0 -0 -0" />
    <parent link="part_1_3" />
    <child link="closing_mid_mcp_2_r_2_z" />
    <axis xyz="0 0 0" />
  </joint>
  
  <link name="dc15_a01_case_m_dummy">
    <inertial>
      <origin xyz="-0.0213304 -0.00693934 -0.0117467" rpy="0 0 0" /><mass value="0.0258605" />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</inertial>
    
    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
  </link>
  
  <link name="closing_mid_mcp_3_l_1">
    <origin xyz="0 0 0" rpy="0 -0 0" />
    <inertial>
      <origin xyz="0 0 0" rpy="0 0 0" /><mass value="0.001" />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</inertial>
  </link>
  <joint name="closing_mid_mcp_3_l_1_frame" type="fixed">
    <origin xyz="0 0 -0.0235" rpy="-3.14159 0 0" />
    <parent link="dc15_a01_case_m_dummy" />
    <child link="closing_mid_mcp_3_l_1" />
    <axis xyz="0 0 0" />
  </joint>
  
  <link name="closing_mid_mcp_3_l_1_z">
    <origin xyz="0 0 0" rpy="0 -0 0" />
    <inertial>
      <origin xyz="0 0 0" rpy="0 0 0" /><mass value="0.001" />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</inertial>
  </link>
  <joint name="closing_mid_mcp_3_l_1_z_frame" type="fixed">
    <origin xyz="0 -0 -0.1235" rpy="-3.14159 0 0" />
    <parent link="dc15_a01_case_m_dummy" />
    <child link="closing_mid_mcp_3_l_1_z" />
    <axis xyz="0 0 0" />
  </joint>
  
  <link name="part_1_4">
    <inertial>
      <origin xyz="0.000790504 -0.0127167 -0.0124567" rpy="0 0 0" /><mass value="0.00515238" />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</inertial>
    
    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
  </link>
  
  <link name="closing_mid_mcp_2">
    <origin xyz="0 0 0" rpy="0 -0 0" />
    <inertial>
      <origin xyz="0 0 0" rpy="0 0 0" /><mass value="0.001" />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</inertial>
  </link>
  <joint name="closing_mid_mcp_2_frame" type="fixed">
    <origin xyz="0.0146 -0.0305728 -0.0245" rpy="-1.5708 0 1.5708" />
    <parent link="part_1_4" />
    <child link="closing_mid_mcp_2" />
    <axis xyz="0 0 0" />
  </joint>
  
  <link name="closing_mid_mcp_2_z">
    <origin xyz="0 0 0" rpy="0 -0 0" />
    <inertial>
      <origin xyz="0 0 0" rpy="0 0 0" /><mass value="0.001" />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</inertial>
  </link>
  <joint name="closing_mid_mcp_2_z_frame" type="fixed">
    <origin xyz="-0.0854 -0.0305728 -0.0245" rpy="-1.5708 0 1.5708" />
    <parent link="part_1_4" />
    <child link="closing_mid_mcp_2_z" />
    <axis xyz="0 0 0" />
  </joint>
  
  <link name="dc15_a01_case_m_dummy_2">
    <inertial>
      <origin xyz="0.0215685 0.0179583 -0.0129681" rpy="0 0 0" /><mass value="0.0308923" />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</inertial>
    
    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
  </link>
  
  <link name="part_1_5">
    <inertial>
      <origin xyz="0 0 0" rpy="0 0 0" /><mass value="0.001" />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</inertial>
    
    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
  </link>
  
  <link name="part_1_6">
    <inertial>
      <origin xyz="0 0 0" rpy="0 0 0" /><mass value="0.001" />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</inertial>
    
    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
  </link>
  
  <link name="closing_mid_mcp_1">
    <origin xyz="0 0 0" rpy="0 -0 0" />
    <inertial>
      <origin xyz="0 0 0" rpy="0 0 0" /><mass value="0.001" />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</inertial>
  </link>
  <joint name="closing_mid_mcp_1_frame" type="fixed">
    <origin xyz="-0.0294679 -0.0210773 -0.00155" rpy="-0 0 -2.5207" />
    <parent link="part_1_6" />
    <child link="closing_mid_mcp_1" />
    <axis xyz="0 0 0" />
  </joint>
  
  <link name="closing_mid_mcp_1_z">
    <origin xyz="0 0 0" rpy="0 -0 0" />
    <inertial>
      <origin xyz="0 0 0" rpy="0 0 0" /><mass value="0.001" />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</inertial>
  </link>
  <joint name="closing_mid_mcp_1_z_frame" type="fixed">
    <origin xyz="-0.0294679 -0.0210773 0.09845" rpy="-0 0 -2.5207" />
    <parent link="part_1_6" />
    <child link="closing_mid_mcp_1_z" />
    <axis xyz="0 0 0" />
  </joint>
  
  <joint name="mid_pip_rod_passive" type="revolute">
    <origin xyz="0 -0.012 -0.00345" rpy="-0 -0 -0" />
    <parent link="part_1_5" />
    <child link="part_1_6" />
    <axis xyz="0 0 1" />
    <limit effort="10" velocity="10" lower="-3.141592653589793" upper="3.141592653589793" />
  </joint>
  
  <joint name="mid_pip_motor" type="revolute">
    <origin xyz="0.0294295 0.0211116 -0.0246" rpy="0 -0 0.00116171" />
    <parent link="dc15_a01_case_m_dummy_2" />
    <child link="part_1_5" />
    <axis xyz="0 0 1" />
    <limit effort="10" velocity="10" lower="-3.141592653589793" upper="3.141592653589793" />
  </joint>
  
  <joint name="mid_pip" type="revolute">
    <origin xyz="-0.013 -0.0305728 -0.0125" rpy="1.5708 -0 -1.5708" />
    <parent link="part_1_4" />
    <child link="dc15_a01_case_m_dummy_2" />
    <axis xyz="0 0 1" />
    <limit effort="10" velocity="10" lower="-3.141592653589793" upper="3.141592653589793" />
  </joint>
  
  <joint name="mid_mcp_abd_motor" type="revolute">
    <origin xyz="-0.01345 0.00722288 -0.01175" rpy="1.5708 1.5708 0" />
    <parent link="dc15_a01_case_m_dummy" />
    <child link="part_1_4" />
    <axis xyz="0 0 1" />
    <limit effort="10" velocity="10" lower="-3.141592653589793" upper="3.141592653589793" />
  </joint>
  
  <link name="part_1_7">
    <inertial>
      <origin xyz="0 0 0" rpy="0 0 0" /><mass value="0.001" />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</inertial>
    
    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
  </link>
  
  <link name="closing_mid_mcp_1_r_1">
    <origin xyz="0 0 0" rpy="0 -0 0" />
    <inertial>
      <origin xyz="0 0 0" rpy="0 0 0" /><mass value="0.001" />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</inertial>
  </link>
  <joint name="closing_mid_mcp_1_r_1_frame" type="fixed">
    <origin xyz="0.0177121 0.0301708 -0.0019" rpy="3.14159 -0 -1.56123" />
    <parent link="part_1_7" />
    <child link="closing_mid_mcp_1_r_1" />
    <axis xyz="0 0 0" />
  </joint>
  
  <link name="closing_mid_mcp_1_r_1_z">
    <origin xyz="0 0 0" rpy="0 -0 0" />
    <inertial>
      <origin xyz="0 0 0" rpy="0 0 0" /><mass value="0.001" />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</inertial>
  </link>
  <joint name="closing_mid_mcp_1_r_1_z_frame" type="fixed">
    <origin xyz="0.0177121 0.0301708 -0.1019" rpy="3.14159 -0 -1.56123" />
    <parent link="part_1_7" />
    <child link="closing_mid_mcp_1_r_1_z" />
    <axis xyz="0 0 0" />
  </joint>
  
  <joint name="mid_mcp_p1_passive_r" type="revolute">
    <origin xyz="-0.0439 -0.016 -0" rpy="-3.14159 0 0" />
    <parent link="dc15_a01_case_m_dummy" />
    <child link="part_1_7" />
    <axis xyz="0 0 1" />
    <limit effort="10" velocity="10" lower="-3.141592653589793" upper="3.141592653589793" />
  </joint>
  
  <link name="part_1_8">
    <inertial>
      <origin xyz="0 0 0" rpy="0 0 0" /><mass value="0.001" />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</inertial>
    
    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
  </link>
  
  <link name="closing_mid_mcp_1_l_1">
    <origin xyz="0 0 0" rpy="0 -0 0" />
    <inertial>
      <origin xyz="0 0 0" rpy="0 0 0" /><mass value="0.001" />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</inertial>
  </link>
  <joint name="closing_mid_mcp_1_l_1_frame" type="fixed">
    <origin xyz="-0.03 0.018 -0.00105" rpy="3.14159 0 0" />
    <parent link="part_1_8" />
    <child link="closing_mid_mcp_1_l_1" />
    <axis xyz="0 0 0" />
  </joint>
  
  <link name="closing_mid_mcp_1_l_1_z">
    <origin xyz="0 0 0" rpy="0 -0 0" />
    <inertial>
      <origin xyz="0 0 0" rpy="0 0 0" /><mass value="0.001" />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</inertial>
  </link>
  <joint name="closing_mid_mcp_1_l_1_z_frame" type="fixed">
    <origin xyz="-0.03 0.018 -0.10105" rpy="3.14159 0 0" />
    <parent link="part_1_8" />
    <child link="closing_mid_mcp_1_l_1_z" />
    <axis xyz="0 0 0" />
  </joint>
  
  <joint name="mid_mcp_p1_passive_l" type="revolute">
    <origin xyz="-0.0439 -0.016 -0.0236" rpy="0 0 2.64207" />
    <parent link="dc15_a01_case_m_dummy" />
    <child link="part_1_8" />
    <axis xyz="0 0 1" />
    <limit effort="10" velocity="10" lower="-3.141592653589793" upper="3.141592653589793" />
  </joint>
  
  <joint name="mid_mcp_p3_passive_r" type="revolute">
    <origin xyz="0.03 0.018 -0.00285" rpy="0 0 -1.5708" />
    <parent link="part_1_3" />
    <child link="dc15_a01_case_m_dummy" />
    <axis xyz="0 0 1" />
    <limit effort="10" velocity="10" lower="-3.141592653589793" upper="3.141592653589793" />
  </joint>
  
  <joint name="mid_mcp_p4_passive_r" type="revolute">
    <origin xyz="-0.023 0.006 -0.003" rpy="-3.14159 0 0.00386359" />
    <parent link="part_1_2" />
    <child link="part_1_3" />
    <axis xyz="0 0 1" />
    <limit effort="10" velocity="10" lower="-3.141592653589793" upper="3.141592653589793" />
  </joint>
  
  <joint name="mid_mcp_motor" type="revolute">
    <origin xyz="0.031767 -0.00977873 0.0035" rpy="1.5708 0.00386359 1.65806" />
    <parent link="part_1" />
    <child link="part_1_2" />
    <axis xyz="0 0 1" />
    <limit effort="10" velocity="10" lower="-3.141592653589793" upper="3.141592653589793" />
  </joint>
  
  <link name="part_1_9">
    <inertial>
      <origin xyz="-0.0115642 0.00763374 -0.00367135" rpy="0 0 0" /><mass value="0.00208172" />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</inertial>
    
    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
  </link>
  
  <link name="closing_mid_mcp_1_l_2">
    <origin xyz="0 0 0" rpy="0 -0 0" />
    <inertial>
      <origin xyz="0 0 0" rpy="0 0 0" /><mass value="0.001" />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</inertial>
  </link>
  <joint name="closing_mid_mcp_1_l_2_frame" type="fixed">
    <origin xyz="-0.039 0.03825 -0.00235" rpy="-3.14159 -0 1.5708" />
    <parent link="part_1_9" />
    <child link="closing_mid_mcp_1_l_2" />
    <axis xyz="0 0 0" />
  </joint>
  
  <link name="closing_mid_mcp_1_l_2_z">
    <origin xyz="0 0 0" rpy="0 -0 0" />
    <inertial>
      <origin xyz="0 0 0" rpy="0 0 0" /><mass value="0.001" />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</inertial>
  </link>
  <joint name="closing_mid_mcp_1_l_2_z_frame" type="fixed">
    <origin xyz="-0.039 0.03825 -0.10235" rpy="-3.14159 -0 1.5708" />
    <parent link="part_1_9" />
    <child link="closing_mid_mcp_1_l_2_z" />
    <axis xyz="0 0 0" />
  </joint>
  
  <link name="part_1_10">
    <inertial>
      <origin xyz="0 0 0" rpy="0 0 0" /><mass value="0.001" />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</inertial>
    
    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
  </link>
  
  <link name="closing_mid_mcp_3_l_2">
    <origin xyz="0 0 0" rpy="0 -0 0" />
    <inertial>
      <origin xyz="0 0 0" rpy="0 0 0" /><mass value="0.001" />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</inertial>
  </link>
  <joint name="closing_mid_mcp_3_l_2_frame" type="fixed">
    <origin xyz="0.03 0.018 0.0036" rpy="3.14159 0 1.5708" />
    <parent link="part_1_10" />
    <child link="closing_mid_mcp_3_l_2" />
    <axis xyz="0 0 0" />
  </joint>
  
  <link name="closing_mid_mcp_3_l_2_z">
    <origin xyz="0 0 0" rpy="0 -0 0" />
    <inertial>
      <origin xyz="0 0 0" rpy="0 0 0" /><mass value="0.001" />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</inertial>
  </link>
  <joint name="closing_mid_mcp_3_l_2_z_frame" type="fixed">
    <origin xyz="0.03 0.018 -0.0964" rpy="3.14159 0 1.5708" />
    <parent link="part_1_10" />
    <child link="closing_mid_mcp_3_l_2_z" />
    <axis xyz="0 0 0" />
  </joint>
  
  <link name="closing_mid_mcp_2_l_2">
    <origin xyz="0 0 0" rpy="0 -0 0" />
    <inertial>
      <origin xyz="0 0 0" rpy="0 0 0" /><mass value="0.001" />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</inertial>
  </link>
  <joint name="closing_mid_mcp_2_l_2_frame" type="fixed">
    <origin xyz="0.004 -0.0285 0" rpy="3.14159 -0 -0" />
    <parent link="part_1_10" />
    <child link="closing_mid_mcp_2_l_2" />
    <axis xyz="0 0 0" />
  </joint>
  
  <link name="closing_mid_mcp_2_l_2_z">
    <origin xyz="0 0 0" rpy="0 -0 0" />
    <inertial>
      <origin xyz="0 0 0" rpy="0 0 0" /><mass value="0.001" />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</inertial>
  </link>
  <joint name="closing_mid_mcp_2_l_2_z_frame" type="fixed">
    <origin xyz="0.004 -0.0285 -0.1" rpy="3.14159 -0 -0" />
    <parent link="part_1_10" />
    <child link="closing_mid_mcp_2_l_2_z" />
    <axis xyz="0 0 0" />
  </joint>
  
  <joint name="mid_mcp_p4_passive_l" type="revolute">
    <origin xyz="-0.023 -0.006 -0.00375" rpy="0 -0 -0.00386359" />
    <parent link="part_1_9" />
    <child link="part_1_10" />
    <axis xyz="0 0 1" />
    <limit effort="10" velocity="10" lower="-3.141592653589793" upper="3.141592653589793" />
  </joint>
  
  <joint name="mid_mcp_p5_l_passive" type="revolute">
    <origin xyz="0.0548787 -0.00775672 0.0035" rpy="-1.5708 0.00386359 1.65806" />
    <parent link="part_1" />
    <child link="part_1_9" />
    <axis xyz="0 0 1" />
    <limit effort="10" velocity="10" lower="-3.141592653589793" upper="3.141592653589793" />
  </joint>
  
  <link name="dc15_a01_case_m_dummy_3">
    <inertial>
      <origin xyz="0.00113052 -0.0229789 -0.0239765" rpy="0 0 0" /><mass value="0.0326139" />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</inertial>
    
    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
  </link>
  
  <link name="part_1_11">
    <inertial>
      <origin xyz="-0.0030995 -0.00985523 -0.0115819" rpy="0 0 0" /><mass value="0.00616941" />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</inertial>
    
    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
  </link>
  
  <link name="closing_ring_mcp_2">
    <origin xyz="0 0 0" rpy="0 -0 0" />
    <inertial>
      <origin xyz="0 0 0" rpy="0 0 0" /><mass value="0.001" />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</inertial>
  </link>
  <joint name="closing_ring_mcp_2_frame" type="fixed">
    <origin xyz="0.0109392 -0.033865 -0.0245" rpy="2.7696 -1.5708 0" />
    <parent link="part_1_11" />
    <child link="closing_ring_mcp_2" />
    <axis xyz="0 0 0" />
  </joint>
  
  <link name="closing_ring_mcp_2_z">
    <origin xyz="0 0 0" rpy="0 -0 0" />
    <inertial>
      <origin xyz="0 0 0" rpy="0 0 0" /><mass value="0.001" />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</inertial>
  </link>
  <joint name="closing_ring_mcp_2_z_frame" type="fixed">
    <origin xyz="0.1041 -0.0702122 -0.0245" rpy="2.7696 -1.5708 0" />
    <parent link="part_1_11" />
    <child link="closing_ring_mcp_2_z" />
    <axis xyz="0 0 0" />
  </joint>
  
  <link name="dc15_a01_case_m_dummy_4">
    <inertial>
      <origin xyz="0.0184492 0.0166334 -0.0240893" rpy="0 0 0" /><mass value="0.0331407" />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</inertial>
    
    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
  </link>
  
  <link name="part_1_12">
    <inertial>
      <origin xyz="0 0 0" rpy="0 0 0" /><mass value="0.001" />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</inertial>
    
    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
  </link>
  
  <link name="part_1_13">
    <inertial>
      <origin xyz="0 0 0" rpy="0 0 0" /><mass value="0.001" />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</inertial>
    
    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
  </link>
  
  <link name="closing_ring_mcp_1">
    <origin xyz="0 0 0" rpy="0 -0 0" />
    <inertial>
      <origin xyz="0 0 0" rpy="0 0 0" /><mass value="0.001" />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</inertial>
  </link>
  <joint name="closing_ring_mcp_1_frame" type="fixed">
    <origin xyz="0 0.032875 -0.00135" rpy="-3.14159 0 -0" />
    <parent link="part_1_13" />
    <child link="closing_ring_mcp_1" />
    <axis xyz="0 0 0" />
  </joint>
  
  <link name="closing_ring_mcp_1_z">
    <origin xyz="0 0 0" rpy="0 -0 0" />
    <inertial>
      <origin xyz="0 0 0" rpy="0 0 0" /><mass value="0.001" />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</inertial>
  </link>
  <joint name="closing_ring_mcp_1_z_frame" type="fixed">
    <origin xyz="-0 0.032875 -0.10135" rpy="-3.14159 0 -0" />
    <parent link="part_1_13" />
    <child link="closing_ring_mcp_1_z" />
    <axis xyz="0 0 0" />
  </joint>
  
  <joint name="ring_pip_rod_passive" type="revolute">
    <origin xyz="0 -0.012 -0.00365" rpy="-0 0 2.30847" />
    <parent link="part_1_12" />
    <child link="part_1_13" />
    <axis xyz="0 0 1" />
    <limit effort="10" velocity="10" lower="-3.141592653589793" upper="3.141592653589793" />
  </joint>
  
  <joint name="ring_pip_motor" type="revolute">
    <origin xyz="0.0245157 0.0219765 -0.03785" rpy="0 0 -0.00549508" />
    <parent link="dc15_a01_case_m_dummy_4" />
    <child link="part_1_12" />
    <axis xyz="0 0 1" />
    <limit effort="10" velocity="10" lower="-3.141592653589793" upper="3.141592653589793" />
  </joint>
  
  <joint name="ring_pip" type="revolute">
    <origin xyz="-0.0274895 -0.0188718 -0.0125" rpy="1.5708 0 -1.94279" />
    <parent link="part_1_11" />
    <child link="dc15_a01_case_m_dummy_4" />
    <axis xyz="0 0 1" />
    <limit effort="10" velocity="10" lower="-3.141592653589793" upper="3.141592653589793" />
  </joint>
  
  <joint name="ring_mcp_abd_motor" type="revolute">
    <origin xyz="-0.00475 -0.00999988 -0.02805" rpy="-1.5708 -1.1988 3.14159" />
    <parent link="dc15_a01_case_m_dummy_3" />
    <child link="part_1_11" />
    <axis xyz="0 0 1" />
    <limit effort="10" velocity="10" lower="-3.141592653589793" upper="3.141592653589793" />
  </joint>
  
  <joint name="ring_mcp_flex_motor" type="revolute">
    <origin xyz="0.0942892 0.0480499 -0.00944936" rpy="-0 1.24905 0.610865" />
    <parent link="part_1" />
    <child link="dc15_a01_case_m_dummy_3" />
    <axis xyz="0 0 1" />
    <limit effort="10" velocity="10" lower="-3.141592653589793" upper="3.141592653589793" />
  </joint>
  
  <link name="part_1_14">
    <inertial>
      <origin xyz="0.00443147 0.0230868 -0.0212294" rpy="0 0 0" /><mass value="0.0286079" />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</inertial>
    
    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
  </link>
  
  <link name="part_1_15">
    <inertial>
      <origin xyz="-0.000789624 -0.0125421 -0.0119297" rpy="0 0 0" /><mass value="0.0051514" />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</inertial>
    
    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
  </link>
  
  <link name="closing_index_pip_1">
    <origin xyz="0 0 0" rpy="0 -0 0" />
    <inertial>
      <origin xyz="0 0 0" rpy="0 0 0" /><mass value="0.001" />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</inertial>
  </link>
  <joint name="closing_index_pip_1_frame" type="fixed">
    <origin xyz="-0.0146 -0.03 -0.0245" rpy="-1.5708 -0 -1.5708" />
    <parent link="part_1_15" />
    <child link="closing_index_pip_1" />
    <axis xyz="0 0 0" />
  </joint>
  
  <link name="closing_index_pip_1_z">
    <origin xyz="0 0 0" rpy="0 -0 0" />
    <inertial>
      <origin xyz="0 0 0" rpy="0 0 0" /><mass value="0.001" />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</inertial>
  </link>
  <joint name="closing_index_pip_1_z_frame" type="fixed">
    <origin xyz="0.0854 -0.03 -0.0245" rpy="-1.5708 -0 -1.5708" />
    <parent link="part_1_15" />
    <child link="closing_index_pip_1_z" />
    <axis xyz="0 0 0" />
  </joint>
  
  <link name="dc15_a01_case_m_dummy_5">
    <inertial>
      <origin xyz="0.0154585 0.0191245 -0.0102933" rpy="0 0 0" /><mass value="0.0296754" />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</inertial>
    
    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
  </link>
  
  <link name="part_1_16">
    <inertial>
      <origin xyz="0 0 0" rpy="0 0 0" /><mass value="0.001" />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</inertial>
    
    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
  </link>
  
  <link name="part_1_17">
    <inertial>
      <origin xyz="0 0 0" rpy="0 0 0" /><mass value="0.001" />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</inertial>
    
    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
  </link>
  
  <link name="closing_index_pip_2">
    <origin xyz="0 0 0" rpy="0 -0 0" />
    <inertial>
      <origin xyz="0 0 0" rpy="0 0 0" /><mass value="0.001" />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</inertial>
  </link>
  <joint name="closing_index_pip_2_frame" type="fixed">
    <origin xyz="0.0184376 -0.02525 -0.0003" rpy="0 0 -3.14159" />
    <parent link="part_1_17" />
    <child link="closing_index_pip_2" />
    <axis xyz="0 0 0" />
  </joint>
  
  <link name="closing_index_pip_2_z">
    <origin xyz="0 0 0" rpy="0 -0 0" />
    <inertial>
      <origin xyz="0 0 0" rpy="0 0 0" /><mass value="0.001" />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</inertial>
  </link>
  <joint name="closing_index_pip_2_z_frame" type="fixed">
    <origin xyz="0.0184376 -0.02525 0.0997" rpy="0 0 -3.14159" />
    <parent link="part_1_17" />
    <child link="closing_index_pip_2_z" />
    <axis xyz="0 0 0" />
  </joint>
  
  <joint name="index_pip_rod_passive" type="revolute">
    <origin xyz="-0 -0.012 -0.00365" rpy="0 -0 0.187566" />
    <parent link="part_1_16" />
    <child link="part_1_17" />
    <axis xyz="0 0 1" />
    <limit effort="10" velocity="10" lower="-3.141592653589793" upper="3.141592653589793" />
  </joint>
  
  <joint name="index_pip_motor" type="revolute">
    <origin xyz="0.0228226 0.0213691 0.0011" rpy="3.14159 0 3.14159" />
    <parent link="dc15_a01_case_m_dummy_5" />
    <child link="part_1_16" />
    <axis xyz="0 0 1" />
    <limit effort="10" velocity="10" lower="-3.141592653589793" upper="3.141592653589793" />
  </joint>
  
  <joint name="index_pip" type="revolute">
    <origin xyz="-0.01075 -0.03 -0.0125" rpy="1.5708 -0 -1.5708" />
    <parent link="part_1_15" />
    <child link="dc15_a01_case_m_dummy_5" />
    <axis xyz="0 0 1" />
    <limit effort="10" velocity="10" lower="-3.141592653589793" upper="3.141592653589793" />
  </joint>
  
  <joint name="index_mcp_abd_motor" type="revolute">
    <origin xyz="-0.00125 0.00999988 -0.02325" rpy="-1.5708 1.5708 0" />
    <parent link="part_1_14" />
    <child link="part_1_15" />
    <axis xyz="0 0 1" />
    <limit effort="10" velocity="10" lower="-3.141592653589793" upper="3.141592653589793" />
  </joint>
  
  <joint name="index_mcp_flex_motor" type="revolute">
    <origin xyz="-0.0106987 0.016 -0.0185" rpy="3.14159 1.5708 0" />
    <parent link="part_1" />
    <child link="part_1_14" />
    <axis xyz="0 0 1" />
    <limit effort="10" velocity="10" lower="-3.141592653589793" upper="3.141592653589793" />
  </joint>
  
  <link name="part_1_18">
    <inertial>
      <origin xyz="0 0 0" rpy="0 0 0" /><mass value="0.001" />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</inertial>
    
    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
  </link>
  
  <link name="closing_mid_mcp_2_l_1">
    <origin xyz="0 0 0" rpy="0 -0 0" />
    <inertial>
      <origin xyz="0 0 0" rpy="0 0 0" /><mass value="0.001" />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</inertial>
  </link>
  <joint name="closing_mid_mcp_2_l_1_frame" type="fixed">
    <origin xyz="-0.023 -0.006 0.001625" rpy="0 0 -0" />
    <parent link="part_1_18" />
    <child link="closing_mid_mcp_2_l_1" />
    <axis xyz="0 0 0" />
  </joint>
  
  <link name="closing_mid_mcp_2_l_1_z">
    <origin xyz="0 0 0" rpy="0 -0 0" />
    <inertial>
      <origin xyz="0 0 0" rpy="0 0 0" /><mass value="0.001" />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</inertial>
  </link>
  <joint name="closing_mid_mcp_2_l_1_z_frame" type="fixed">
    <origin xyz="-0.023 -0.006 0.101625" rpy="0 0 -0" />
    <parent link="part_1_18" />
    <child link="closing_mid_mcp_2_l_1_z" />
    <axis xyz="0 0 0" />
  </joint>
  
  <joint name="mid_mcp_p2_passive_l" type="revolute">
    <origin xyz="0.0583426 -0.00343838 0.032" rpy="1.5708 0.514228 1.65806" />
    <parent link="part_1" />
    <child link="part_1_18" />
    <axis xyz="0 0 1" />
    <limit effort="10" velocity="10" lower="-3.141592653589793" upper="3.141592653589793" />
  </joint>
  
  <link name="part_1_19">
    <inertial>
      <origin xyz="0 0 0" rpy="0 0 0" /><mass value="0.001" />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</inertial>
    
    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
  </link>
  
  <link name="closing_mid_mcp_2_r_1">
    <origin xyz="0 0 0" rpy="0 -0 0" />
    <inertial>
      <origin xyz="0 0 0" rpy="0 0 0" /><mass value="0.001" />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</inertial>
  </link>
  <joint name="closing_mid_mcp_2_r_1_frame" type="fixed">
    <origin xyz="-0.023 -0.006 0.001625" rpy="0 0 -0" />
    <parent link="part_1_19" />
    <child link="closing_mid_mcp_2_r_1" />
    <axis xyz="0 0 0" />
  </joint>
  
  <link name="closing_mid_mcp_2_r_1_z">
    <origin xyz="0 0 0" rpy="0 -0 0" />
    <inertial>
      <origin xyz="0 0 0" rpy="0 0 0" /><mass value="0.001" />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</inertial>
  </link>
  <joint name="closing_mid_mcp_2_r_1_z_frame" type="fixed">
    <origin xyz="-0.023 -0.006 0.101625" rpy="0 0 -0" />
    <parent link="part_1_19" />
    <child link="closing_mid_mcp_2_r_1_z" />
    <axis xyz="0 0 0" />
  </joint>
  
  <joint name="mid_mcp_p2_passive_r" type="revolute">
    <origin xyz="0.0276058 -0.00612751 0.032" rpy="-1.5708 0.00386359 1.65806" />
    <parent link="part_1" />
    <child link="part_1_19" />
    <axis xyz="0 0 1" />
    <limit effort="10" velocity="10" lower="-3.141592653589793" upper="3.141592653589793" />
  </joint>
  
  <link name="dc15_a01_case_m_dummy_6">
    <inertial>
      <origin xyz="0.0348094 0.000357822 -0.0369962" rpy="0 0 0" /><mass value="0.0284274" />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</inertial>
    
    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
  </link>
  
  <link name="part_1_20">
    <inertial>
      <origin xyz="-0.026836 -0.0263096 -0.0172023" rpy="0 0 0" /><mass value="0.0272383" />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</inertial>
    
    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
  </link>
  
  <link name="part_1_21">
    <inertial>
      <origin xyz="0.0119991 0.00244692 -0.0106869" rpy="0 0 0" /><mass value="0.00376946" />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</inertial>
    
    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
  </link>
  
  <link name="closing_thumb_ip_1">
    <origin xyz="0 0 0" rpy="0 -0 0" />
    <inertial>
      <origin xyz="0 0 0" rpy="0 0 0" /><mass value="0.001" />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</inertial>
  </link>
  <joint name="closing_thumb_ip_1_frame" type="fixed">
    <origin xyz="0.0290015 -0.00925 0.0035" rpy="-0 -0 0" />
    <parent link="part_1_21" />
    <child link="closing_thumb_ip_1" />
    <axis xyz="0 0 0" />
  </joint>
  
  <link name="closing_thumb_ip_1_z">
    <origin xyz="0 0 0" rpy="0 -0 0" />
    <inertial>
      <origin xyz="0 0 0" rpy="0 0 0" /><mass value="0.001" />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</inertial>
  </link>
  <joint name="closing_thumb_ip_1_z_frame" type="fixed">
    <origin xyz="0.0290015 -0.00925 0.1035" rpy="-0 -0 0" />
    <parent link="part_1_21" />
    <child link="closing_thumb_ip_1_z" />
    <axis xyz="0 0 0" />
  </joint>
  
  <link name="dc15_a01_case_m_dummy_7">
    <inertial>
      <origin xyz="0.0105381 0.018292 0.012005" rpy="0 0 0" /><mass value="0.029072" />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</inertial>
    
    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
  </link>
  
  <link name="part_1_22">
    <inertial>
      <origin xyz="0 0 0" rpy="0 0 0" /><mass value="0.001" />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</inertial>
    
    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
  </link>
  
  <link name="part_1_23">
    <inertial>
      <origin xyz="0 0 0" rpy="0 0 0" /><mass value="0.001" />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</inertial>
    
    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
  </link>
  
  <link name="closing_thumb_ip_2">
    <origin xyz="0 0 0" rpy="0 -0 0" />
    <inertial>
      <origin xyz="0 0 0" rpy="0 0 0" /><mass value="0.001" />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</inertial>
  </link>
  <joint name="closing_thumb_ip_2_frame" type="fixed">
    <origin xyz="0 0.024 0.0005" rpy="-3.14159 0 0" />
    <parent link="part_1_23" />
    <child link="closing_thumb_ip_2" />
    <axis xyz="0 0 0" />
  </joint>
  
  <link name="closing_thumb_ip_2_z">
    <origin xyz="0 0 0" rpy="0 -0 0" />
    <inertial>
      <origin xyz="0 0 0" rpy="0 0 0" /><mass value="0.001" />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</inertial>
  </link>
  <joint name="closing_thumb_ip_2_z_frame" type="fixed">
    <origin xyz="0 0.024 -0.0995" rpy="-3.14159 0 0" />
    <parent link="part_1_23" />
    <child link="closing_thumb_ip_2_z" />
    <axis xyz="0 0 0" />
  </joint>
  
  <joint name="thumb_ip_rod_passive" type="revolute">
    <origin xyz="-0 -0.012 -0.0049" rpy="0 -0 -2.45422" />
    <parent link="part_1_22" />
    <child link="part_1_23" />
    <axis xyz="0 0 1" />
    <limit effort="10" velocity="10" lower="-3.141592653589793" upper="3.141592653589793" />
  </joint>
  
  <joint name="thumb_ip_motor" type="revolute">
    <origin xyz="0.0176901 0.0199435 0.02335" rpy="-3.14159 -0 3.05922" />
    <parent link="dc15_a01_case_m_dummy_7" />
    <child link="part_1_22" />
    <axis xyz="0 0 1" />
    <limit effort="10" velocity="10" lower="-3.141592653589793" upper="3.141592653589793" />
  </joint>
  
  <joint name="thumb_ip" type="revolute">
    <origin xyz="0.0290015 -0 -0.02425" rpy="0 0 -0" />
    <parent link="part_1_21" />
    <child link="dc15_a01_case_m_dummy_7" />
    <axis xyz="0 0 1" />
    <limit effort="10" velocity="10" lower="-3.141592653589793" upper="3.141592653589793" />
  </joint>
  
  <joint name="thumb_mcp_flex_motor" type="revolute">
    <origin xyz="-0.0115 -0.023 -0.0195" rpy="1.5708 -0 -1.5708" />
    <parent link="part_1_20" />
    <child link="part_1_21" />
    <axis xyz="0 0 1" />
    <limit effort="10" velocity="10" lower="-3.141592653589793" upper="3.141592653589793" />
  </joint>
  
  <joint name="thumb_cmc_flex_motor" type="revolute">
    <origin xyz="0.0329728 0.00970986 -0.0290907" rpy="-1.8326 0 -2.44346" />
    <parent link="dc15_a01_case_m_dummy_6" />
    <child link="part_1_20" />
    <axis xyz="0 0 1" />
    <limit effort="10" velocity="10" lower="-3.141592653589793" upper="3.141592653589793" />
  </joint>
  
  <joint name="thumb_cmc_abd_motor" type="revolute">
    <origin xyz="-0.00918372 0.0325048 0.0294794" rpy="-2.55947 -0.00973433 1.73392" />
    <parent link="part_1" />
    <child link="dc15_a01_case_m_dummy_6" />
    <axis xyz="0 0 1" />
    <limit effort="10" velocity="10" lower="-3.141592653589793" upper="3.141592653589793" />
  </joint>
</robot>
