yepengfei81-cpu/Motor_Glove/glove_mujoco/robot.xml

<?xml version="1.0" ?>
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
<mujoco model="glove">
  <compiler inertiafromgeom="true" angle="radian" meshdir="assets" autolimits="true"/>
  <option integrator="implicitfast"/>
  <default>
    <default class="glove">
      <joint frictionloss="0.002" armature="0.001"/>
      <position kp="50" dampratio="1"/>
      <default class="visual">
        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
      </default>
      <default class="collision">
        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
      </default>
    </default>
  </default>
  <worldbody>
    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
    <body name="part_1" pos="-0.00741612 -0.0472824 0.119223" quat="0.522225 -0.399484 -0.583448 0.476741" childclass="glove">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
      <inertial pos="0 0 0" mass="1e-09" fullinertia="1e-09 1e-09 1e-09 0 0 0"/>
      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
      <body name="part_1_2" pos="0.031767 -0.00977873 0.0035" quat="0.478721 0.476706 0.522256 0.52041">
        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
        <joint axis="0 0 1" name="mid_mcp_motor" type="hinge"/>
        <inertial pos="0 0 0" mass="1e-09" fullinertia="1e-09 1e-09 1e-09 0 0 0"/>
        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
        <body name="part_1_3" pos="-0.023 0.006 -0.003" quat="0 -0.999998 -0.00193179 0">
          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
          <joint axis="0 0 1" name="mid_mcp_p4_passive_r" type="hinge"/>
          <inertial pos="0 0 0" mass="1e-09" fullinertia="1e-09 1e-09 1e-09 0 0 0"/>
          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
          <body name="dc15_a01_case_m_dummy" pos="0.03 0.018 -0.00285" quat="0.707107 -0 -0 -0.707107">
            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
            <joint axis="0 0 1" name="mid_mcp_p3_passive_r" type="hinge"/>
            <inertial pos="0 0 0" mass="1e-09" fullinertia="1e-09 1e-09 1e-09 0 0 0"/>
            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
            <body name="part_1_4" pos="-0.01345 0.00722288 -0.01175" quat="0.5 0.5 0.5 -0.5">
              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
              <joint axis="0 0 1" name="mid_mcp_abd_motor" type="hinge"/>
              <inertial pos="0 0 0" mass="1e-09" fullinertia="1e-09 1e-09 1e-09 0 0 0"/>
              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
              <body name="dc15_a01_case_m_dummy_2" pos="-0.013 -0.0305728 -0.0125" quat="0.5 0.5 -0.5 -0.5">
                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
                <joint axis="0 0 1" name="mid_pip" type="hinge" range="-1.9199 0.6981"/>
                <inertial pos="0 0 0" mass="1e-09" fullinertia="1e-09 1e-09 1e-09 0 0 0"/>
                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
                <body name="part_1_5" pos="0.0294295 0.0211116 -0.0246" quat="1 0 -0 0.000580853">
                  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
                  <joint axis="0 0 1" name="mid_pip_motor" type="hinge"/>
                  <inertial pos="0 0 0" mass="1e-09" fullinertia="1e-09 1e-09 1e-09 0 0 0"/>
                  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
                  <body name="part_1_6" pos="0 -0.012 -0.00345" quat="1 0 0 0">
                    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
                    <joint axis="0 0 1" name="mid_pip_rod_passive" type="hinge"/>
                    <inertial pos="0 0 0" mass="1e-09" fullinertia="1e-09 1e-09 1e-09 0 0 0"/>
                    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
                  </body>
                </body>
              </body>
            </body>
            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
            <body name="part_1_7" pos="-0.0439 -0.016 -0" quat="0 1 0 0">
              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
              <joint axis="0 0 1" name="mid_mcp_p1_passive_r" type="hinge"/>
              <inertial pos="0 0 0" mass="1e-09" fullinertia="1e-09 1e-09 1e-09 0 0 0"/>
              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
            </body>
            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
            <body name="part_1_8" pos="-0.0439 -0.016 -0.0236" quat="0.247174 -0 0 0.968971">
              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
              <joint axis="0 0 1" name="mid_mcp_p1_passive_l" type="hinge"/>
              <inertial pos="0 0 0" mass="1e-09" fullinertia="1e-09 1e-09 1e-09 0 0 0"/>
              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
            </body>
          </body>
        </body>
      </body>
      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
      <body name="part_1_9" pos="0.0548787 -0.00775672 0.0035" quat="0.476706 -0.478721 -0.52041 0.522256">
        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
        <joint axis="0 0 1" name="mid_mcp_p5_l_passive" type="hinge"/>
        <inertial pos="0 0 0" mass="1e-09" fullinertia="1e-09 1e-09 1e-09 0 0 0"/>
        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
        <body name="part_1_10" pos="-0.023 -0.006 -0.00375" quat="0.999998 0 -0 -0.00193179">
          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
          <joint axis="0 0 1" name="mid_mcp_p4_passive_l" type="hinge"/>
          <inertial pos="0 0 0" mass="1e-09" fullinertia="1e-09 1e-09 1e-09 0 0 0"/>
          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
        </body>
      </body>
      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
      <body name="dc15_a01_case_m_dummy_3" pos="0.0942892 0.0480499 -0.00944936" quat="0.773695 -0.175826 0.557648 0.243945">
        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
        <joint axis="0 0 1" name="ring_mcp_flex_motor" type="hinge"/>
        <inertial pos="0 0 0" mass="1e-09" fullinertia="1e-09 1e-09 1e-09 0 0 0"/>
        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
        <body name="part_1_11" pos="-0.00475 -0.00999988 -0.02805" quat="0.398914 0.398914 -0.583839 0.583839">
          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
          <joint axis="0 0 1" name="ring_mcp_abd_motor" type="hinge"/>
          <inertial pos="0 0 0" mass="1e-09" fullinertia="1e-09 1e-09 1e-09 0 0 0"/>
          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
          <body name="dc15_a01_case_m_dummy_4" pos="-0.0274895 -0.0188718 -0.0125" quat="0.398914 0.398914 -0.583839 -0.583839">
            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
            <joint axis="0 0 1" name="ring_pip" type="hinge" range="-1.9199 0.6981"/>
            <inertial pos="0 0 0" mass="1e-09" fullinertia="1e-09 1e-09 1e-09 0 0 0"/>
            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
            <body name="part_1_12" pos="0.0245157 0.0219765 -0.03785" quat="0.999996 0 0 -0.00274754">
              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
              <joint axis="0 0 1" name="ring_pip_motor" type="hinge"/>
              <inertial pos="0 0 0" mass="1e-09" fullinertia="1e-09 1e-09 1e-09 0 0 0"/>
              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
              <body name="part_1_13" pos="0 -0.012 -0.00365" quat="0.404618 -0 0 0.914486">
                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
                <joint axis="0 0 1" name="ring_pip_rod_passive" type="hinge"/>
                <inertial pos="0 0 0" mass="1e-09" fullinertia="1e-09 1e-09 1e-09 0 0 0"/>
                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
              </body>
            </body>
          </body>
        </body>
      </body>
      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
      <body name="part_1_14" pos="-0.0106987 0.016 -0.0185" quat="0 0.707107 -0 -0.707107">
        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
        <joint axis="0 0 1" name="index_mcp_flex_motor" type="hinge"/>
        <inertial pos="0 0 0" mass="1e-09" fullinertia="1e-09 1e-09 1e-09 0 0 0"/>
        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
        <body name="part_1_15" pos="-0.00125 0.00999988 -0.02325" quat="0.5 -0.5 0.5 0.5">
          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
          <joint axis="0 0 1" name="index_mcp_abd_motor" type="hinge"/>
          <inertial pos="0 0 0" mass="1e-09" fullinertia="1e-09 1e-09 1e-09 0 0 0"/>
          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
          <body name="dc15_a01_case_m_dummy_5" pos="-0.01075 -0.03 -0.0125" quat="0.5 0.5 -0.5 -0.5">
            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
            <joint axis="0 0 1" name="index_pip" type="hinge" range="-1.9199 0.6981"/>
            <inertial pos="0 0 0" mass="1e-09" fullinertia="1e-09 1e-09 1e-09 0 0 0"/>
            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
            <body name="part_1_16" pos="0.0228226 0.0213691 0.0011" quat="0 8.9613e-08 1 0">
              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
              <joint axis="0 0 1" name="index_pip_motor" type="hinge"/>
              <inertial pos="0 0 0" mass="1e-09" fullinertia="1e-09 1e-09 1e-09 0 0 0"/>
              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
              <body name="part_1_17" pos="-0 -0.012 -0.00365" quat="0.995606 0 -0 0.0936454">
                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
                <joint axis="0 0 1" name="index_pip_rod_passive" type="hinge"/>
                <inertial pos="0 0 0" mass="1e-09" fullinertia="1e-09 1e-09 1e-09 0 0 0"/>
                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
              </body>
            </body>
          </body>
        </body>
      </body>
      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
      <body name="part_1_18" pos="0.0583426 -0.00343838 0.032" quat="0.594581 0.329441 0.625675 0.382718">
        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
        <joint axis="0 0 1" name="mid_mcp_p2_passive_l" type="hinge"/>
        <inertial pos="0 0 0" mass="1e-09" fullinertia="1e-09 1e-09 1e-09 0 0 0"/>
        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
      </body>
      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
      <body name="part_1_19" pos="0.0276058 -0.00612751 0.032" quat="0.476706 -0.478721 -0.52041 0.522256">
        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
        <joint axis="0 0 1" name="mid_mcp_p2_passive_r" type="hinge"/>
        <inertial pos="0 0 0" mass="1e-09" fullinertia="1e-09 1e-09 1e-09 0 0 0"/>
        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
      </body>
      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
      <body name="dc15_a01_case_m_dummy_6" pos="-0.00918372 0.0325048 0.0294794" quat="0.189262 -0.618858 -0.731194 0.215753">
        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
        <joint axis="0 0 1" name="thumb_cmc_abd_motor" type="hinge"/>
        <inertial pos="0 0 0" mass="1e-09" fullinertia="1e-09 1e-09 1e-09 0 0 0"/>
        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
        <body name="part_1_20" pos="0.0329728 0.00970986 -0.0290907" quat="0.208209 -0.271343 0.745508 -0.572049">
          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
          <joint axis="0 0 1" name="thumb_cmc_flex_motor" type="hinge"/>
          <inertial pos="0 0 0" mass="1e-09" fullinertia="1e-09 1e-09 1e-09 0 0 0"/>
          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
          <body name="part_1_21" pos="-0.0115 -0.023 -0.0195" quat="0.5 0.5 -0.5 -0.5">
            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
            <joint axis="0 0 1" name="thumb_mcp_flex_motor" type="hinge"/>
            <inertial pos="0 0 0" mass="1e-09" fullinertia="1e-09 1e-09 1e-09 0 0 0"/>
            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
            <body name="dc15_a01_case_m_dummy_7" pos="0.0290015 -0 -0.02425" quat="1 0 -0 -0">
              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
              <joint axis="0 0 1" name="thumb_ip" type="hinge" range="-0.6981 1.9199"/>
              <inertial pos="0 0 0" mass="1e-09" fullinertia="1e-09 1e-09 1e-09 0 0 0"/>
              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
              <body name="part_1_22" pos="0.0176901 0.0199435 0.02335" quat="0 -0.041173 -0.999152 0">
                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
                <joint axis="0 0 1" name="thumb_ip_motor" type="hinge"/>
                <inertial pos="0 0 0" mass="1e-09" fullinertia="1e-09 1e-09 1e-09 0 0 0"/>
                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
                <body name="part_1_23" pos="-0 -0.012 -0.0049" quat="0.336959 0 -0 -0.941519">
                  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
                  <joint axis="0 0 1" name="thumb_ip_rod_passive" type="hinge"/>
                  <inertial pos="0 0 0" mass="1e-09" fullinertia="1e-09 1e-09 1e-09 0 0 0"/>
                  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
                </body>
              </body>
            </body>
          </body>
        </body>
      </body>
    </body>
  </worldbody>
  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
  <actuator>
    <position class="glove" name="mid_mcp_motor" joint="mid_mcp_motor"/>
    <position class="glove" name="mid_mcp_abd_motor" joint="mid_mcp_abd_motor"/>
    <position class="glove" name="mid_pip_motor" joint="mid_pip_motor"/>
    <position class="glove" name="ring_mcp_flex_motor" joint="ring_mcp_flex_motor"/>
    <position class="glove" name="ring_mcp_abd_motor" joint="ring_mcp_abd_motor"/>
    <position class="glove" name="ring_pip_motor" joint="ring_pip_motor"/>
    <position class="glove" name="index_mcp_flex_motor" joint="index_mcp_flex_motor"/>
    <position class="glove" name="index_mcp_abd_motor" joint="index_mcp_abd_motor"/>
    <position class="glove" name="index_pip_motor" joint="index_pip_motor"/>
    <position class="glove" name="thumb_cmc_abd_motor" joint="thumb_cmc_abd_motor"/>
    <position class="glove" name="thumb_cmc_flex_motor" joint="thumb_cmc_flex_motor"/>
    <position class="glove" name="thumb_mcp_flex_motor" joint="thumb_mcp_flex_motor"/>
    <position class="glove" name="thumb_ip_motor" joint="thumb_ip_motor"/>
  </actuator>
  <equality>
    <connect site1="closing_mid_mcp_2_r_1" site2="closing_mid_mcp_2_r_2" solref="0.005 1"/>
    <connect site1="closing_mid_mcp_2_r_1_z" site2="closing_mid_mcp_2_r_2_z" solref="0.005 1"/>
    <connect site1="closing_mid_mcp_3_l_1" site2="closing_mid_mcp_3_l_2" solref="0.005 1"/>
    <connect site1="closing_mid_mcp_3_l_1_z" site2="closing_mid_mcp_3_l_2_z" solref="0.005 1"/>
    <connect site1="closing_mid_mcp_2_l_1" site2="closing_mid_mcp_2_l_2" solref="0.005 1"/>
    <connect site1="closing_mid_mcp_2_l_1_z" site2="closing_mid_mcp_2_l_2_z" solref="0.005 1"/>
    <connect site1="closing_index_pip_1" site2="closing_index_pip_2" solref="0.005 1"/>
    <connect site1="closing_index_pip_1_z" site2="closing_index_pip_2_z" solref="0.005 1"/>
    <connect site1="closing_mid_mcp_1" site2="closing_mid_mcp_2" solref="0.005 1"/>
    <connect site1="closing_mid_mcp_1_z" site2="closing_mid_mcp_2_z" solref="0.005 1"/>
    <connect site1="closing_ring_mcp_1" site2="closing_ring_mcp_2" solref="0.005 1"/>
    <connect site1="closing_ring_mcp_1_z" site2="closing_ring_mcp_2_z" solref="0.005 1"/>
    <connect site1="closing_mid_mcp_1_l_1" site2="closing_mid_mcp_1_l_2" solref="0.005 1"/>
    <connect site1="closing_mid_mcp_1_l_1_z" site2="closing_mid_mcp_1_l_2_z" solref="0.005 1"/>
    <connect site1="closing_mid_mcp_1_r_1" site2="closing_mid_mcp_1_r_2" solref="0.005 1"/>
    <connect site1="closing_mid_mcp_1_r_1_z" site2="closing_mid_mcp_1_r_2_z" solref="0.005 1"/>
    <connect site1="closing_thumb_ip_1" site2="closing_thumb_ip_2" solref="0.005 1"/>
    <connect site1="closing_thumb_ip_1_z" site2="closing_thumb_ip_2_z" solref="0.005 1"/>
  </equality>
</mujoco>
