yepengfei81-cpu/Motor_Glove/hand/robot.urdf

<?xml version='1.0' encoding='utf-8'?>
<robot name="hand">
  
  <link name="part_1">
    <inertial>
      <origin xyz="0.0327 0.0232236 0.00523213" rpy="0 0 0" /><mass value="0.170903" />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</inertial>
    
    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
  </link>
  
  <link name="dc15_a01_case_m_dummy">
    <inertial>
      <origin xyz="0.00113052 -0.0229789 -0.0239765" rpy="0 0 0" /><mass value="0.0326139" />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</inertial>
    
    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
  </link>
  
  <link name="dc15_a01_case_m_dummy_2">
    <inertial>
      <origin xyz="-0.000219281 -0.0188158 -0.0127556" rpy="0 0 0" /><mass value="0.0219539" />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</inertial>
    
    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
  </link>
  
  <link name="part_1_2">
    <inertial>
      <origin xyz="0.0210904 0.00102491 -0.0218441" rpy="0 0 0" /><mass value="0.00887149" />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</inertial>
    
    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
  </link>
  
  <joint name="ring_pip_motor" type="revolute">
    <origin xyz="0.019 -0.027573 -0.0125" rpy="-1.5708 -0.00489428 -1.5708" />
    <parent link="dc15_a01_case_m_dummy_2" />
    <child link="part_1_2" />
    <axis xyz="0 0 1" />
    <limit effort="10" velocity="10" lower="-3.141592653589793" upper="3.141592653589793" />
  </joint>
  
  <joint name="ring_mcp_abd_motor" type="revolute">
    <origin xyz="-0.00475 -0.00999988 -0.02805" rpy="1.5708 -1.5708 0" />
    <parent link="dc15_a01_case_m_dummy" />
    <child link="dc15_a01_case_m_dummy_2" />
    <axis xyz="0 0 1" />
    <limit effort="10" velocity="10" lower="-3.141592653589793" upper="3.141592653589793" />
  </joint>
  
  <joint name="ring_mcp_flex_motor" type="revolute">
    <origin xyz="0.0942892 0.0480499 -0.00944936" rpy="-0 1.24905 0.610865" />
    <parent link="part_1" />
    <child link="dc15_a01_case_m_dummy" />
    <axis xyz="0 0 1" />
    <limit effort="10" velocity="10" lower="-3.141592653589793" upper="3.141592653589793" />
  </joint>
  
  <link name="part_1_3">
    <inertial>
      <origin xyz="0.00443147 0.0230868 -0.0212294" rpy="0 0 0" /><mass value="0.0286079" />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</inertial>
    
    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
  </link>
  
  <link name="dc15_a01_case_m_dummy_3">
    <inertial>
      <origin xyz="2.45453e-05 -0.0201989 -0.0125644" rpy="0 0 0" /><mass value="0.0230603" />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</inertial>
    
    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
  </link>
  
  <link name="part_1_4">
    <inertial>
      <origin xyz="0.0219622 -0.000977568 -0.0118472" rpy="0 0 0" /><mass value="0.00505791" />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</inertial>
    
    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
  </link>
  
  <joint name="index_pip_motor" type="revolute">
    <origin xyz="-0.012 -0.03 -0.0125" rpy="1.5708 -0 -1.5708" />
    <parent link="dc15_a01_case_m_dummy_3" />
    <child link="part_1_4" />
    <axis xyz="0 0 1" />
    <limit effort="10" velocity="10" lower="-3.141592653589793" upper="3.141592653589793" />
  </joint>
  
  <joint name="index_mcp_abd_motor" type="revolute">
    <origin xyz="-0.00125 0.00999988 -0.02325" rpy="-1.5708 1.5708 0" />
    <parent link="part_1_3" />
    <child link="dc15_a01_case_m_dummy_3" />
    <axis xyz="0 0 1" />
    <limit effort="10" velocity="10" lower="-3.141592653589793" upper="3.141592653589793" />
  </joint>
  
  <joint name="index_mcp_flex_motor" type="revolute">
    <origin xyz="-0.0106987 0.016 -0.0185" rpy="3.14159 1.5708 0" />
    <parent link="part_1" />
    <child link="part_1_3" />
    <axis xyz="0 0 1" />
    <limit effort="10" velocity="10" lower="-3.141592653589793" upper="3.141592653589793" />
  </joint>
  
  <link name="dc15_a01_case_m_dummy_4">
    <inertial>
      <origin xyz="0.0348094 0.000357822 -0.0369962" rpy="0 0 0" /><mass value="0.0284274" />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</inertial>
    
    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
  </link>
  
  <link name="part_1_5">
    <inertial>
      <origin xyz="-0.026836 -0.0263096 -0.0172023" rpy="0 0 0" /><mass value="0.0272383" />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</inertial>
    
    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
  </link>
  
  <link name="dc15_a01_case_m_dummy_5">
    <inertial>
      <origin xyz="-0.0007784 0.0198171 -0.0157482" rpy="0 0 0" /><mass value="0.021947" />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</inertial>
    
    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
  </link>
  
  <link name="part_1_6">
    <inertial>
      <origin xyz="-0.0013053 0.0183708 0.0114227" rpy="0 0 0" /><mass value="0.00412979" />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</inertial>
    
    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
  </link>
  
  <joint name="thumb_ip_motor" type="revolute">
    <origin xyz="4.37353e-07 0.029001 -0.00435" rpy="3.14159 0 3.14159" />
    <parent link="dc15_a01_case_m_dummy_5" />
    <child link="part_1_6" />
    <axis xyz="0 0 1" />
    <limit effort="10" velocity="10" lower="-3.141592653589793" upper="3.141592653589793" />
  </joint>
  
  <joint name="thumb_mcp_flex_motor" type="revolute">
    <origin xyz="-0.0145 -0.023 -0.0195" rpy="-3.14159 1.5708 0" />
    <parent link="part_1_5" />
    <child link="dc15_a01_case_m_dummy_5" />
    <axis xyz="0 0 1" />
    <limit effort="10" velocity="10" lower="-3.141592653589793" upper="3.141592653589793" />
  </joint>
  
  <joint name="thumb_cmc_flex_motor" type="revolute">
    <origin xyz="0.0329728 0.00970986 -0.0290907" rpy="-1.8326 0 -2.44346" />
    <parent link="dc15_a01_case_m_dummy_4" />
    <child link="part_1_5" />
    <axis xyz="0 0 1" />
    <limit effort="10" velocity="10" lower="-3.141592653589793" upper="3.141592653589793" />
  </joint>
  
  <joint name="thumb_cmc_abd_motor" type="revolute">
    <origin xyz="-0.00918372 0.0325048 0.0294794" rpy="-2.55947 -0.00973433 1.73392" />
    <parent link="part_1" />
    <child link="dc15_a01_case_m_dummy_4" />
    <axis xyz="0 0 1" />
    <limit effort="10" velocity="10" lower="-3.141592653589793" upper="3.141592653589793" />
  </joint>
  
  <link name="dc15_a01_case_m_dummy_6">
    <inertial>
      <origin xyz="-0.0299575 -0.0131071 -0.0131226" rpy="0 0 0" /><mass value="0.0237321" />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</inertial>
    
    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
  </link>
  
  <link name="dc15_a01_case_m_dummy_7">
    <inertial>
      <origin xyz="-0.000224981 -0.0253546 -0.0119726" rpy="0 0 0" /><mass value="0.0225383" />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</inertial>
    
    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
  </link>
  
  <link name="part_1_7">
    <inertial>
      <origin xyz="0.00120706 0.0239907 0.00958202" rpy="0 0 0" /><mass value="0.00584722" />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</inertial>
    
    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
  </link>
  
  <joint name="mid_pip_motor" type="revolute">
    <origin xyz="0.0095 -0.034323 -0.0125" rpy="-3.14159 1.5708 0" />
    <parent link="dc15_a01_case_m_dummy_7" />
    <child link="part_1_7" />
    <axis xyz="0 0 1" />
    <limit effort="10" velocity="10" lower="-3.141592653589793" upper="3.141592653589793" />
  </joint>
  
  <joint name="mid_mcp_abd_motor" type="revolute">
    <origin xyz="-0.0155915 -0.007281 -0.0131" rpy="0 -1.5708 0" />
    <parent link="dc15_a01_case_m_dummy_6" />
    <child link="dc15_a01_case_m_dummy_7" />
    <axis xyz="0 0 1" />
    <limit effort="10" velocity="10" lower="-3.141592653589793" upper="3.141592653589793" />
  </joint>
  
  <joint name="mid_mcp_motor" type="revolute">
    <origin xyz="0.0545568 0.0220002 -0.01458" rpy="1.5708 0 1.65806" />
    <parent link="part_1" />
    <child link="dc15_a01_case_m_dummy_6" />
    <axis xyz="0 0 1" />
    <limit effort="10" velocity="10" lower="-3.141592653589793" upper="3.141592653589793" />
  </joint>
</robot>
