yepengfei81-cpu/Motor_Glove/hand_mujoco/robot.xml

<?xml version="1.0" ?>
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
<mujoco model="hand">
  <compiler inertiafromgeom="true" angle="radian" meshdir="assets" autolimits="true"/>
  <option integrator="implicitfast"/>
  <default>
    <default class="hand">
      <joint frictionloss="0.002" armature="0.001"/>
      <position kp="50" dampratio="1"/>
      <default class="visual">
        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
      </default>
      <default class="collision">
        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
      </default>
    </default>
  </default>
  <worldbody>
    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
    <body name="part_1" pos="-0.0487747 0.0115582 0.119223" quat="0.702415 -0.702415 -0.0813201 -0.0813201" childclass="hand">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
      <inertial pos="0 0 0" mass="1e-09" fullinertia="1e-09 1e-09 1e-09 0 0 0"/>
      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
      <body name="dc15_a01_case_m_dummy" pos="0.0942892 0.0480499 -0.00944936" quat="0.773695 -0.175826 0.557648 0.243945">
        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
        <joint axis="0 0 1" name="ring_mcp_flex_motor" type="hinge"/>
        <inertial pos="0 0 0" mass="1e-09" fullinertia="1e-09 1e-09 1e-09 0 0 0"/>
        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
        <body name="dc15_a01_case_m_dummy_2" pos="-0.00475 -0.00999988 -0.02805" quat="0.5 0.5 -0.5 0.5">
          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
          <joint axis="0 0 1" name="ring_mcp_abd_motor" type="hinge"/>
          <inertial pos="0 0 0" mass="1e-09" fullinertia="1e-09 1e-09 1e-09 0 0 0"/>
          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
          <body name="part_1_2" pos="0.019 -0.027573 -0.0125" quat="0.498775 -0.501222 0.498775 -0.501222">
            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
            <joint axis="0 0 1" name="ring_pip_motor" type="hinge"/>
            <inertial pos="0 0 0" mass="1e-09" fullinertia="1e-09 1e-09 1e-09 0 0 0"/>
            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
          </body>
        </body>
      </body>
      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
      <body name="part_1_3" pos="-0.0106987 0.016 -0.0185" quat="0 0.707107 -0 -0.707107">
        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
        <joint axis="0 0 1" name="index_mcp_flex_motor" type="hinge"/>
        <inertial pos="0 0 0" mass="1e-09" fullinertia="1e-09 1e-09 1e-09 0 0 0"/>
        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
        <body name="dc15_a01_case_m_dummy_3" pos="-0.00125 0.00999988 -0.02325" quat="0.5 -0.5 0.5 0.5">
          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
          <joint axis="0 0 1" name="index_mcp_abd_motor" type="hinge"/>
          <inertial pos="0 0 0" mass="1e-09" fullinertia="1e-09 1e-09 1e-09 0 0 0"/>
          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
          <body name="part_1_4" pos="-0.012 -0.03 -0.0125" quat="0.5 0.5 -0.5 -0.5">
            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
            <joint axis="0 0 1" name="index_pip_motor" type="hinge"/>
            <inertial pos="0 0 0" mass="1e-09" fullinertia="1e-09 1e-09 1e-09 0 0 0"/>
            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
          </body>
        </body>
      </body>
      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
      <body name="dc15_a01_case_m_dummy_4" pos="-0.00918372 0.0325048 0.0294794" quat="0.189262 -0.618858 -0.731194 0.215753">
        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
        <joint axis="0 0 1" name="thumb_cmc_abd_motor" type="hinge"/>
        <inertial pos="0 0 0" mass="1e-09" fullinertia="1e-09 1e-09 1e-09 0 0 0"/>
        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
        <body name="part_1_5" pos="0.0329728 0.00970986 -0.0290907" quat="0.208209 -0.271343 0.745508 -0.572049">
          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
          <joint axis="0 0 1" name="thumb_cmc_flex_motor" type="hinge"/>
          <inertial pos="0 0 0" mass="1e-09" fullinertia="1e-09 1e-09 1e-09 0 0 0"/>
          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
          <body name="dc15_a01_case_m_dummy_5" pos="-0.0145 -0.023 -0.0195" quat="0 -0.707107 -0 0.707107">
            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
            <joint axis="0 0 1" name="thumb_mcp_flex_motor" type="hinge"/>
            <inertial pos="0 0 0" mass="1e-09" fullinertia="1e-09 1e-09 1e-09 0 0 0"/>
            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
            <body name="part_1_6" pos="4.37353e-07 0.029001 -0.00435" quat="0 0 1 -0">
              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
              <joint axis="0 0 1" name="thumb_ip_motor" type="hinge"/>
              <inertial pos="0 0 0" mass="1e-09" fullinertia="1e-09 1e-09 1e-09 0 0 0"/>
              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
            </body>
          </body>
        </body>
      </body>
      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
      <body name="dc15_a01_case_m_dummy_6" pos="0.0545568 0.0220002 -0.01458" quat="0.477714 0.477714 0.521334 0.521334">
        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
        <joint axis="0 0 1" name="mid_mcp_motor" type="hinge"/>
        <inertial pos="0 0 0" mass="1e-09" fullinertia="1e-09 1e-09 1e-09 0 0 0"/>
        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
        <body name="dc15_a01_case_m_dummy_7" pos="-0.0155915 -0.007281 -0.0131" quat="0.707107 -0 -0.707107 -0">
          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
          <joint axis="0 0 1" name="mid_mcp_abd_motor" type="hinge"/>
          <inertial pos="0 0 0" mass="1e-09" fullinertia="1e-09 1e-09 1e-09 0 0 0"/>
          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
          <body name="part_1_7" pos="0.0095 -0.034323 -0.0125" quat="0 0.707107 -0 -0.707107">
            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
            <joint axis="0 0 1" name="mid_pip_motor" type="hinge"/>
            <inertial pos="0 0 0" mass="1e-09" fullinertia="1e-09 1e-09 1e-09 0 0 0"/>
            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
          </body>
        </body>
      </body>
    </body>
  </worldbody>
  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
  <actuator>
    <position class="hand" name="ring_mcp_flex_motor" joint="ring_mcp_flex_motor"/>
    <position class="hand" name="ring_mcp_abd_motor" joint="ring_mcp_abd_motor"/>
    <position class="hand" name="ring_pip_motor" joint="ring_pip_motor"/>
    <position class="hand" name="index_mcp_flex_motor" joint="index_mcp_flex_motor"/>
    <position class="hand" name="index_mcp_abd_motor" joint="index_mcp_abd_motor"/>
    <position class="hand" name="index_pip_motor" joint="index_pip_motor"/>
    <position class="hand" name="thumb_cmc_abd_motor" joint="thumb_cmc_abd_motor"/>
    <position class="hand" name="thumb_cmc_flex_motor" joint="thumb_cmc_flex_motor"/>
    <position class="hand" name="thumb_mcp_flex_motor" joint="thumb_mcp_flex_motor"/>
    <position class="hand" name="thumb_ip_motor" joint="thumb_ip_motor"/>
    <position class="hand" name="mid_mcp_motor" joint="mid_mcp_motor"/>
    <position class="hand" name="mid_mcp_abd_motor" joint="mid_mcp_abd_motor"/>
    <position class="hand" name="mid_pip_motor" joint="mid_pip_motor"/>
  </actuator>
  <equality/>
</mujoco>
