yepengfei81-cpu/Motor_Glove/(commit log)

2026-10-16 Isomorphic force-feedback glove: export pipeline, motor tools, bilateral teleop, slides
    - Onshape -> URDF / MuJoCo export (tools/export_glove.py, check_mates.py, glove_rules.py) with closed-chain handling
    - DYNAMIXEL tooling: bus wrapper, ID setup / verify / reassign, read-only probe, dynamic motor test, voltage-limit tool
    - Calibration (zero + direction), zero alignment and leader->follower map fitting between two gloves
    - Sim-in-the-loop force feedback (MuJoCo) and two-glove bilateral teleop with contact-gated feedback,
    adaptive follower stiffness (K_t = f(tau_t)), logging, replay and plotting
    - Lab-meeting deck (pptxgenjs), figures and outline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
    [adaptive.csv, b3b_eh.stl, b3b_eh_1.stl, bts2_m2_6x8.stl, bts2_m2_6x8_1.stl, dc15_a01_case_b_dummy.stl, dc15_a01_case_f_dummy.stl, dc15_a01_case_m_dummy.stl]
2026-10-20 Export the direct-drive robot hand, refresh the glove model, add glove-to-hand mapping
    - Robot hand (Onshape element 354ca377…) exported to hand/ (URDF) and hand_mujoco/ (MJCF)
    - Glove re-exported from the updated CAD (glove/, glove_mujoco/)
    - glove_rules: weld grounded instances to the base (rule 4); treat a motor held by one
    cylinder + one non-coaxial parallel mate as fastened (rule 5)
    - check_mates: orphaned bodies now count as a problem; per-joint body listing when they occur
    - tune_mjcf / place_root / export_glove: use the exported robot's own directory instead of glove paths
    - compare_kin: per-joint axis/sign/transmission comparison between glove and hand;
    writes config/glove_to_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
    [b3b_eh.stl, b3b_eh_1.stl, bts2_m2_6x8.stl, bts2_m2_6x8_1.stl, dc15_a01_case_b_dummy.stl, dc15_a01_case_f_dummy.stl, dc15_a01_case_m_dummy.stl, dc15_a01_horn_dummy.stl]
2026-10-20 Unified mg.py entry, device table, zero drift check, hand model support
    [calibrate.py, devices.py, glove_live.py, glove_model.py, mg.py, zero_check.py]
2026-10-23 Bench motor optimization: 3 Mbps DMA bridge, 750 Hz loop, motor identification, PWM-mode leader
    - firmware/openrb_bridge: DMA ring-buffer USB<->DXL bridge, 3 Mbps (4 M marginal)
    - dxl_bus: baud autodetect, Fast Sync Read 0x8A with resync+CRC, PWM mode, fast housekeeping reads
    - bench_bus.py: bus timing benchmarks, --as-device registration
    - motor_id.py: spin/ramp/chirp/step/sweep/spring/fit experiments; --mode pwm spin/step with inline analysis
    - bilateral.py: --rt realtime, persistent follower reader, observer, model-based contact gate,
    friction feedforward, efficiency compensation, wall/coupling modes, --mode pwm (voltage conversion,
    back-EMF feedforward + slow current loop, software c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
    [T1_chirp.csv, T1_coast0.csv, T1_coast1.csv, T1_coast2.csv, T1_coast3.csv, T1_coast4.csv, T1_coast5.csv, T1_pwmspin0.csv]
2026-10-25 M288 identification, per-model motor params, voltage-mode stall map, software follower loop, force reflection
    - motor_id: --mode pwm spin/step with stall-current column and --tag; fit converts torques with the sweep Kt
    - motor_params: T3/T4 (M288) identified; XL330-M288.json / XL330-M077.json selected per joint by `--model auto`
    - bilateral: per-joint model params (J, B, phi, G/Ke/R), --r-load-map; PWM duty from measured stall map
    (discontinuous conduction: 14 ohm apparent at low duty), current-loop gain by local apparent R;
    --follower-mode current (PD + model feedforward, bandwidth per model via --follower-bw-map);
    --fb-force reaction-force-observer reflection with matched 6 Hz filter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
    [T3_chirp.csv, T3_coast0.csv, T3_coast1.csv, T3_coast2.csv, T3_coast3.csv, T3_coast4.csv, T3_coast5.csv, T3_pwmspin0.csv]
